dadatiaoao/-1021ccc/README.md

# 野火 F429 七电机小车：当前状态与已确认信息

**2026-11-06 第一阶段更新：**当前开发分支以 `1c464da` 的 main 为基线，将 5/6/7 轴改为串行碰撞回零；地址 1～7 全部就绪后只自动启动一次，顺序为 6 轴顶部接触并到名义约 10 mm 安全观察位、5 轴接触归零并转至 90°、7 轴外伸接触并归中、最后复核整体停放。按 5/6/7 轴顺序，回零寻端速度为 **15/40/150 RPM**，普通动作默认速度为 **20/60/200 RPM**；三轴寻端无进展时间统一为 **1500 ms**。5 轴普通范围 **0～180°**，6 轴普通范围 0～150 mm，PG2/PG3 限位**只显示**。当前源码、软件验证与尚未进行的新流程实机验收见[第一阶段说明](Doc/MECHANISM_COLLISION_STAGE1_2026-11-06.md)。下方早期回零参数与测试数字保留为历史记录，不适用于这次三轴集成。

更新日期：2026-11-04。当前开发主线为 `main`，文档核对基线为 `f14be37`，后续光流停用改动见 4.4 节。原 `codex/chassis-motor-odometry` 的开发成果已快进合入 `main`；旧光流主线 `01c8a68` 保存在 `archive/main-before-odometry`。当前使用电机累计位置估算平移，陀螺保持航向并控制旋转；光流源码保留但退出编译，应用不再初始化、采样或显示光流数据。当前底盘行为见[电机里程计说明](Doc/CHASSIS_MOTOR_ODOMETRY_2026-10-24.md)，文档维护状态见[文档索引](Doc/README.md)。

**2026-10-27 选择性合入 PR #2：仅加入双舵机正式驱动和比赛纯调度框架。未合入 K230 通信、依赖视觉的运行适配器、重复 DUAL 工程、独立舵机测试界面或角度换算。该提交现已成为 `main` 的代码基线。**

- 上电先保持两路 PWM 关闭，等七机就绪后串行完成 **6→5→7→最终停放复核**；任何轴不能跳过。必须三轴均回零成功且机构、底盘和总线空闲，才依次启用两路初始 PWM：夹爪 **PA6/TIM3_CH1=1700 μs**、转盘 **PC8/TIM3_CH3=1240 μs**。无舵机位置反馈，输出不等于到位。
- 回零失败或全局 STOP 取消本次自动启用；STOP 同时关掉两路 PWM，夹爪可能失去保持力。之后不会自动重启舵机；初始化成功、回零等待已结束且机构/底盘/总线空闲、无待确认停车时，可通过明确的 ON 按钮恢复。手动 ON 不检查三轴 HOMED，不能当成回零成功证明；重新启用恢复该路初始脉宽。单路 OFF 同样取消待执行的自动启用。
- **首页 → MORE → SERVOS**：夹爪1700/2430 μs、转盘1240/1900/2600 μs，分别ON/OFF。回零等待、机构/底盘忙或待确认停车时拒绝 ON 和目标调整，OFF 仍可执行。两路实际配置的 `slew_us_per_s=0`，目标在 `Servo_Process` 中直接更新 PWM，不代表机械瞬时到位；没有舵机到位反馈或完整抓放动作计时。
- **首页 → MORE → RACE FRAMEWORK**：仅展示框架，标注 `NO EXECUTOR`。两批顺序、三槽推定状态和一次启动逻辑已保留；完整流程外部抓取/对外放置各12次，车载槽内部抓放不计。没有注册执行器、没有K230 READY/START，START始终拒绝；不是可运行的比赛固件。详见 [比赛框架边界](User/mission/README.md)。
- 当前仍使用 UART5 TTL 电机总线与 USART1 调试；未接入雷达或 K230 协议。
- 2026-10-27 历史软件验证记录：Keil 全量编译 0 错误/0 警告；主回归、舵机启动门控及 25920 组比赛顺序测试通过。当次记录为未烧录，本次文档审阅未重新构建或运行测试。

**2026-11-04 用户补充确认：已完成当前屏幕八段底盘验收和机构回零测试。** 这是功能实测记录，不包含 K230 启动、自主两批搬运、码垛及返回。测试实际日期、固件提交号/HEX、各轴覆盖与重复次数、行程/角度误差及停车时间未提供；不将其扩大为整车比赛或精度验收，舵机动作顺序和机械干涉仍待专项确认。

**机构参数及其假设以 [mechanism_config.h](User/mechanism/mechanism_config.h) 的配置与注释为准；本文及相关说明同步引用该入口。**

**本文是本工程当前状态、需求和交接的统一入口。此前已归档的计划书、阶段任务书、交付书及前期方案均已过时，仅供历史参考；旧文档与本文冲突时先核对当前源码，不再直接执行其中的旧交接指令。软件行为以源码为准；实物结论以注明范围的用户确认或测量记录为准。** 历史测试仍可作为对应版本的证据，不能据此推定当前实物已全部验收。若后续源码与本文发生差异，应核查并更新本文，不用旧文档覆盖新代码。

用户此前试跑出现 FLOW INVALID、ACTION TIMEOUT 和直行横移，曾发现光流红光遮挡，并反馈手推轴向与车体约定不一致。2026-10-24 用户确认光流模块故障，要求新开分支移除其控制反馈；该实现现已进入 main。当前 main 不再使用光流尺度、方向、质量或时间配对，也不再由光流异常触发底盘停车。保留已有机械参数和两个确认标志为 1；底盘参数本轮未重新测量；机构默认启用 TRIAL 试运行，实测范围见下文，比赛纯调度框架已加入，真实导航与抓放执行器未接入。

**2026-10-26 机构历史记录：当时默认 TRIAL=1，上电先 6→5，再按配置及健康反馈条件决定是否回零 7 轴；仅在线不足以保证参加回零。5/6 快慢速为 24/6、60/12 RPM，5 首次搜索 360°。7 号单头 1 mm 螺距丝杆、电机直联、总行程 50 mm，正向伸出；当时改为驱动器原生碰撞回零后缩回到距伸出端 25 mm 的中点，软件范围 ±25 mm。7 轴回零功能用户实测完成；无进展判定仅用于回零寻端，到端确认停车后自动归中，已移除临时电流采样与显示。当前参数、实现状态与待验项目以[机构标定记录](Doc/MECHANISM_CALIBRATION_TODO_2026-10-25.md)和配置头文件为准；旧机构计划、交付、试运行文档仅作历史记录。**

6 号六次整段计数平均 264855，粗测行程约 165 mm；2026-10-26 用户实机确认同步轮为 20 齿、同步带齿距为 2 mm，每电机圈位移为 40 mm，旧指令范围 0..160 mm；新碰撞点坐标的普通指令上限暂设 150 mm，真实底部余量待验证。临时采数已删除。同日用户已实机确认全部 1～7 号电机均为 **3200 指令脉冲/电机圈**，不能与每圈 65536 反馈计数混用。

## 1. 当前结论与实物进度

| 项目 | 当前已知状态 | 证据与范围 |
|---|---|---|
| 工程平台 | 野火 STM32F429 挑战者 V1 核心板，不使用野火底板；7 台电机 | 用户确认；H743＋8 电机是独立方案，不属于本工程 |
| 扫码 | **已实测成功，运行正常，可稳定扫码** | 用户于 2026-10-22 确认；USART3 9600/8N1、手动电平触发、PB12 低有效、15 字符任务码及换行结束符均匹配 |
| 单电机 | **已实测成功，运行正常** | 用户于 2026-10-22 确认；未提供测试固件提交、完整动作清单及异常注入记录，不扩展为七机或所有故障策略通过 |
| 多电机 | **已同时连接两台，并先后请求 move 完成测试** | 用户于 2026-10-22 补充；这是双节点连接、顺序动作验证，不代表两轴同步运动、四轮聚合或七机并发通过；测试地址、脉冲量和精度未记录 |
| 七电机 | 总线、控制、反馈、启动流程和故障处理已实现并有历史主机回归 | 已补充底盘八段和机构回零功能测试；七机并发、总线异常及停车重试未获专项验收确认，逐台配置仍需核对 |
| 光流 PMW3901 | 用户于 2026-10-24 报告故障，已退出当前 main 底盘控制 | 驱动源码归档保留、不参与编译；首页替换为鼠标位移模块占位卡片，无内页 |
| 陀螺仪 | **已完成实测**，继续使用当前模块 | 继续使用现有模块；2026-11-05 改为按 CAL 现场采样更新零偏，新流程待上板验证；漂移、角度误差和安装映射仍需量化 |
| LCD/触摸 | 4.3 寸 RGB 电容触摸屏；原画板曾运行且可触控 | 旧显示/触控有实测；2026-10-24 改为 180° 整屏倒置及总览首页，主机渲染/触摸/调度回归通过，实屏四角与比赛字高仍待验 |
| K230 视觉上位机 | **外部视觉模块的历史确认：基础模型训练完成**，可输出识别图像坐标；本仓库没有 K230 侧程序 | 用户确认；接 F429 的 USART1（PA9/PA10），通信协议尚未实现；未声明毫米坐标、抓放闭环或场景识别率已通过 |
| 比赛启动与分工 | **每次上电自动机构回零，再等待 K230 板上按钮触发 START；STM32 管任务与动作，K230 管视觉及启动** | 用户于 2026-10-23 确认的待实现需求；K230 的 READY 携带抽签启停区 1/2 与初始朝向，确认 STM32 READY 后才允许发 START；STM32 仍复核并回报拒绝原因。当前 6→5→7 串行碰撞回零软件已实现，待新集成实机复核，用户已确认完成机构回零测试；完整标定和接线追溯待补；K230 协议和比赛任务入口尚未实现 |
| 视觉任务交互 | **STM32 在需要 K230 时发送当前阶段和要执行的任务代码** | 首版不考虑比赛中 K230 断连或重启，不安排重连续跑；消息编码、字段及坐标约定待实现 |
| 抓放推进与异常范围 | **抓住、入槽、释放不做结果反馈，动作程序正常执行结束即按成功推进** | 首版不考虑抓取失败或空载对心超时处理；槽位/计数属于流程推定，不能证明实际持物或落点。既有电机反馈和停车策略保留 |
| 载物位 | **计划三个独立载物位，一趟带三个** | 用户明确设计方案；不代表机械制成或装载检测已验收 |
| 放置定位方案 | **随臂摄像头，视轴与夹爪轮廓圆心对齐；先空载对心，再回车取料、返回放置** | 用户确认方案；夹爪闭合轮廓为与物料抓取边缘同大小的圆。视觉同时定位夹爪圆与目标同心圆，底盘/机构微调；收敛后底盘不动，5 号轴回车取料再返回，6/7 号轴恢复定位姿态后垂直放下。目标在时间预算内完成，首版不处理对心超时；尚未实现/验收该闭环 |
| 舵机 | PA6夹爪、PC8转盘，两路50 Hz PWM已接入 | 三轴回零后输出初始脉宽；无位置反馈；舵机启用顺序与机械干涉未获专项实测确认 |
| 四轮底盘 | 车体速度、电机累计位置估算平移＋gyro 保向/旋转、屏幕单次前进/后退 30 cm | 用户于 2026-11-04 确认旧八段功能测试，2026-11-05 确认当前前进/后退按钮实测方向正确；直行后旋转问题仍待定位，距离误差/重复性未量化 |
| 整车功能 | 外设及底盘软件基础已具备，尚未形成比赛自主运行程序 | 机构碰撞回零及显示用限位软件已实现，新集成待实机验收，完整标定未完成；比赛纯调度已实现；全局定位/导航及真实抓放执行器未实现 |

**当前屏幕入口：上电打开“运行总览”；底栏固定为“首页 / 底盘 / 机械臂 / 限位 / 停止”。底盘 → MORE → “前进30cm”或“后退30cm”显式启动一次直线移动，参数不全时拒绝；只驱动地址 1～4，5～7 可缺席。全局停止覆盖七轴。** 上电机构回零由配置门控（默认 TRIAL=1；TRIAL=0 内置配置未标定，会拒绝回零），旧逐轮上电测试和电机 MANUAL/RUN 测试菜单已删除；比赛 K230 START 未实现；比赛纯框架已加入但执行器未接入。当前页面、旋转规则和预览见[UI 改版说明](Doc/UI_REDESIGN_2026-10-24.md)。

## 2. 整车组成与地址

电机为 X42S_V2.0 光耦版，采用 Emm 固件、TTL 串口。代码按固定地址 1～7 创建节点，不自动修改电机地址或写入持久化参数；具体固件版本、应答设置及多机电气连接仍待逐台核对。

| 地址 | 角色 | 已确认用途 |
|---|---|---|
| 1 | 前左轮 | 麦克纳姆底盘，主要按速度控制 |
| 2 | 前右轮 | 同上 |
| 3 | 后左轮 | 同上 |
| 4 | 后右轮 | 同上 |
| 5 | 旋转臂 | 同步轮 1:3 减速，120°/电机圈；回零与车侧平行，抓放与车侧垂直（90°） |
| 6 | 上下轴 | 同步带升降、无减速，实物总行程粗测约 165 mm；已实机确认 20 齿 × 2 mm，配置 40 mm/电机圈；顶部回零，向下为正 |
| 7 | 前后微调轴 | 单头 1 mm 螺距直联丝杆，50 mm 总行程，中点为零，正向伸出 |

2026-10-26 用户确认 7 号总行程为 50 mm，并要求碰撞回零与中点定位。5/6 限位仍为 PG2/J7-41、PG3/J7-43：COM 接地、NC 输入上拉，释放低、触发/断路高；**新流程只采样并显示，不用于运动决策**。5 号 1:3 减速，碰撞收拢端为 0°，90° 为工作位；6 号直驱同步带，以顶部碰撞点为 0 mm、向下为正，两轴回零方向已有用户实测确认。详细确认状态见[第一阶段说明](Doc/MECHANISM_COLLISION_STAGE1_2026-11-06.md)。底盘继续保留用户录入轮径 78 mm、前后轮距 216 mm、左右轮距 218.6 mm、传动比 1、方向 `{1,-1,1,-1}`；本轮未重新测量。平移按电机每圈 65536 反馈计数换算。2026-11-05 用户确认当前“前进30cm”“后退30cm”实测方向正确；保留 `{1,-1,1,-1}`。有效地面距离、打滑误差及转向反馈一致性仍需分别验证。

## 3. 工程、工具链与资源

| 项目 | 当前配置 |
|---|---|
| 工程路径 / 目标 | 仓库内 `Project/YH-F429.uvprojx`，Keil 目标 `LCD` |
| MCU | STM32F429IGT6 / 工程 STM32F429IGTx，Cortex-M4F，LQFP176 |
| 存储器 | 片内 Flash 1024 KiB、RAM 256 KiB（含 64 KiB CCM）；核心板另有 SDRAM、SPI Flash |
| 软件框架 | STM32 HAL 1.7.3；Arm Compiler 5.06 update 7 build 960（AC5） |
| 时钟 | HSE 25 MHz；PLLM=25、PLLN=360、PLLP=2、PLLQ=7；HCLK 180 MHz、APB1 45 MHz、APB2 90 MHz |
| 初始化方式 | 现有 main/BSP 的 C/HAL 初始化；本工程没有 .ioc，不需要从零重建 CubeMX |
| 显示 | LTDC＋DMA2D，480×272、ARGB8888；单层 522240 字节，外部 SDRAM 0xD0000000 |
| 触摸选择 | 源码选择 GT1151QM 4.3 寸配置；实物芯片型号没有单独确认记录 |
| 调度 | 协作式主循环，无 RTOS；main 中静态 QrApp，统一推进所有服务 |
| 栈 / DMA | 配置栈 4096 字节；UART DMA 缓冲在 DMA 可访问的片内 SRAM，不在 CCM 或 SDRAM |
| 产物 | `Output/YH-F429.hex`、`.axf`；Output、Listings 被 Git 忽略 |

PLLQ 当前不是精确 48 MHz，工程没有新增 USB 业务。历史 MotorDemo、单机 service 及其协议回归保留，默认 main 不调用 MotorDemo_Process。旧单机 UI 及重复的底盘/机构 UI 格式化器已删除，屏幕统一由 qr_ui.c 管理。

### 3.1 已配置引脚

下表“代码配置”不自动等同实际接线；扫码已由用户确认配置匹配，电机双节点顺序 move、光流和陀螺已有用户实测反馈；具体覆盖按第 1 节区分。

| 功能 | MCU / 接口 | 配置 |
|---|---|---|
| 电机 | UART5：PC12 TX、PD2 RX | 115200/8N1；RX DMA1 Stream0/Channel4，TX Stream7/Channel4 |
| 扫码 | USART3：PB10 TX、PB11 RX | 9600/8N1；RX DMA1 Stream1/Channel4 |
| 扫码 TRIG | PB12，V1 J7-14 | 推挽、低有效；周期 1000 ms，其中低电平 800 ms |
| 夹爪舵机 | PA6 / TIM3_CH1 | 50 Hz；初始/低位 1700 μs，高位 2430 μs |
| 转盘舵机 | PC8 / TIM3_CH3 | 50 Hz；初始 1240 μs，另有 1900/2600 μs 预设 |
| 上位机/调试 | USART1：PA9 TX、PA10 RX | 115200/8N1 为当前初始化；拟接 K230，双方协议尚未实现，printf 与协议复用待处理 |
| 历史光流 SCLK（未启用） | SPI2 PB13，J7-54 | AF5；Mode 3，8 bit，MSB first；APB1/64=703125 Hz |
| 历史光流 MISO（未启用） | SPI2 PC2，J7-16 | MCU 输入，接模块输出 |
| 历史光流 MOSI（未启用） | SPI2 PC3，J7-52 | MCU 输出，接模块输入 |
| 历史光流 CS（未启用） | PE3，J7-49 | 独立 GPIO，低有效 |
| 5 号旋转臂限位 | PG2，J7-41 | 输入上拉；COM 接地、NC 接输入；高有效 |
| 6 号上下臂限位 | PG3，J7-43 | 同上；仅初始化 GPIOG 这两位 |
| 陀螺 SCL | I2C1 PB6，J7-32 | AF4、开漏，100 kHz |
| 陀螺 SDA | I2C1 PB7，J7-31 | AF4、开漏 |
| 触摸 | I2C2 PH4/PH5；PD11 RESET、PD13 INT | 沿用野火 BSP；EXTI 只通知，前台处理触摸 |
| Flash | SPI5 PF7/PF8/PF9、PF6 CS | 保留现有 BSP |
| 显示/显存 | LTDC、FMC/SDRAM、DMA2D | 保留原板资源；完整网络以 V1 原理图及 BSP 为准 |

HAL UART MSP 按 USART1/UART5/USART3 分支；统一回调位于 `User/usart/bsp_uart_callbacks.c`。UART5/USART3 各自 RX DMA 缓冲 256 字节、软件队列 512 槽，UART5 TX 持久缓冲 128 字节。光流 SPI2 初始化转发已移除，当前固件不配置其引脚；陀螺与触摸不共用 I2C 总线。

### 3.2 模块接线边界

- **电机 TTL：**主控 TX → 电机 R/A/H，主控 RX ← 电机 T/B/L，共地。光耦脉冲端和 TTL 通信端是不同接口。七台的实际参数、并联接法和电平尚未整体验证。
- **扫码：**用户已确认上述接口/模式/格式可稳定工作。裸 XM1605 资料的 12Pin 为 2=VCC、3/8=GND、4=RX、5=TX、12=TRIG；不能套用成任何转接板的排针顺序。当前固定波形用于手动电平触发；连续模式下 TRIG 的暂停/继续语义不同。实物电源/转接电路细节尚无完整记录。
- **历史光流接线（驱动未编译）：**方案使用 3.3 V 供电/逻辑，共地；模块 VCC 直接关联 VDDIO，不能因有稳压器就按 5 V 接入。资料的 MIS/MOS 丝印与信号方向有歧义：必须按芯片 MOSI 输入接 PC3、MISO 输出接 PC2，不能只看缩写。RESET 不接 MCU、依赖模块上拉及软件复位；MOTION、VREG 不接，VREG 不是外部供电口。早期有安装与模块实测记录，2026-10-24 后续反馈为模块故障；尚无恢复正常确认。实际排针版本/信号核验记录和毫米标定另待补齐，且不再作为当前底盘启动条件。
- **陀螺：**型号 WDS601M-ICM-42688，资料目标芯片 ICM-42688-P，MODULE。用户确认引脚为 **VCC、GND、SCL、SDA、SA0、CS、INT1、INT2**。当前实现走芯片直连 I2C：VCC=3.3 V，CS 拉高，SA0 拉低选 0x68，INT1/INT2 不接 MCU。PS/模式焊点按模块资料保持开路，SCL/SDA 外部上拉到 3.3 V；用户已完成实测，但具体模式焊点、上拉、电平和固定安装方向没有逐项记录。若 SA0 确认固定高，需明确改为 0x69，代码不自动猜地址。未使用板载 MCU 的串口/解算接口。

核心板供电与屏幕排线的历史事实：原画板曾由 DAP LINK 下载并正常显示/触控；屏幕产品资料为 4.3 寸、480×272、5 点触摸、RGB888，要求 5 V 与 3.3 V。原图仅作规格记录，标称刷新指标不是当前应用性能：

显示屏参数原图

## 4. 当前程序架构与运行效果

`main → QrApp_Init / QrApp_Process` 统一编排以下模块，后台服务不因切页停止：

| 模块 | 当前职责 | 主要位置 |
|---|---|---|
| 应用 | 底盘调度、触摸意图分发、控制权仲裁、校准门控 | `User/app/qr_app.c` |
| 机构 | 显示用限位采样、有界碰撞回零、角度/毫米 API、中点回零与屏幕验收 | `User/mechanism/` |
| 底盘 | 配置校验、X 型麦轮逆解、电机位置里程计、非阻塞单次平移/旋转 | `User/chassis/` |
| 电机 | Emm 构帧/解析、七节点独立状态、唯一 UART5 调度、控制/停止/反馈 | `User/motor/emm_protocol.*`、`motor_bus.*` |
| 扫码 | UART 字节接入、文本组帧、任务码解析、会话锁定/重扫 | `User/qr/`、`User/usart/bsp_qr_*.c` |
| 光流（归档、不编译） | 保留 SPI2/PMW3901/服务/旧 UI 源码，应用无引用 | `User/flow/` |
| 陀螺 | I2C1 适配、ICM42688 初始化、单轴速率、CAL/ZERO/积分/恢复 | `User/gyro/` |
| 界面 | 总览首页、模块详情/MORE、固定底栏、180° 显示与触摸、分步绘图 | `User/app/qr_ui.*`、`User/lcd/lcd_orientation.h`、gyro UI |
| 舵机 | TIM3 双路 PWM、预设脉宽、上电门控和 OFF | `User/servo/` |
| 比赛框架 | 两批步骤、三槽推定状态、同色映射、一次启动和错误处理；执行端为空 | `User/mission/` |
| 底层 | 时钟、LCD/SDRAM/触摸、UART/DMA、SPI/I2C | `User/main.c`、各 BSP；HAL 保持原版本 |

电机累计位置与 gyro 接入短程底盘动作，光流驱动不参与编译；扫码结果仍只采集与显示，不触发比赛动作，未实现全局导航。新增业务通过现有 MotorBus API 发送，不另建 UART5 发送者。

### 4.1 上电与屏幕操作

1. 初始化通信、扫码、gyro 和显示用限位后，进入“运行总览”。首页展示准备/机构回零/底盘验收/运动/停车/故障等真实软件阶段、当前轴或验收段号及任务码。默认 TRIAL=1 等待七机反馈齐全、静止且无故障/未确认停车后，只自动尝试一次 6→5→7 串行碰撞回零及完整停放；TRIAL=0 的内置配置仍未标定，会拒绝回零。限位去抖状态不参与开始条件。
2. 首页六个白色模块卡片分别为电机、陀螺仪、扫码、鼠标位移模块、视觉、机械臂。鼠标位移模块显示 NOT LINKED，点击留在首页，暂不设计内页；其余卡片点击进入模块；右上角 MORE/LESS 统一切换诊断。视觉页明确显示 K230 协议尚未实现。
3. 底栏在所有页面固定为“首页 / 底盘 / 机械臂 / 限位 / 停止”。底盘显示后台轮端里程计当前连续坐标段的 X/Y/YAW，断链重建用 SEG 区分；无效或过期显示 --。该估计不等于实际地面位置，也不等于每段动作的相对目标坐标。
4. 机械臂概览显示 5 号角度、6/7 号毫米位置和 HOMED/NO ZERO。MORE 内可切换轴并执行重新回零/机构验收。限位页独立显示 PG2/PG3 原始电平和消抖状态，高电平写“按下 / 断路”，7 号明确无开关。
5. 电机页只读：七轴状态、速度、单轴位置、错误/停止信息和上一轴/下一轴；已删除 MANUAL、使能/速度/脉冲 RUN、0xAA/SYNC 测试模板及隐藏标题跳转。底层 MotorBus 的运动 API 和停车策略保留。
6. 底盘 → MORE 提供“前进30cm”“后退30cm”。每次按下分别以动作开始时的车体局部 X 轴为基准，前进目标为 +300 mm、后退目标为 −300 mm；两按钮的实测前后方向已由用户于 2026-11-05 确认，自动准备四轮、使用轮端里程计和 gyro 保向，到位后确认停车并复查误差。一次点击只移动一次，不自动往返；准备/运动/停车确认期间再次点击拒绝，长按不重复。正常陀螺模式需先静止 CAL，配置和反馈有效（启动失败降级模式见末节）；停止或故障会取消尚未执行的移动。八段路线、段号、段间等待及专用接口已彻底删除。机构与底盘继续互斥，CAL/ZERO 都在机构或底盘持有控制权时拒绝；CAL 另查七轴活动/UNKNOWN/未确认 STOP，ZERO 未执行这层电机状态检查；光流采样及清零入口已移除。
7. 所有按钮为白底黑字白色矩形，按住不重复。切页只改变显示，后台采样、回零/验收继续推进；“停止”取消机构/底盘动作和运行中的比赛框架，向七轴发 STOP 并等待反馈确认，同时关闭两路舵机 PWM、取消其上电自动启用。

**比赛目标流程（需求；自动回零与纯调度已实现，通信及真实执行尚未接入）：**

- K230 发送配置就绪消息，包含抽签启停区 1/2 和初始朝向；STM32 完成自动回零、配置接收及必要准备后报告执行就绪。文档分别称为 `K230_READY` 和 `STM32_READY`，仅用于区分方向，实际协议编码待定。
- K230 先确认 STM32 的 READY，再允许板上按钮发送 START；STM32 收到后再次核查，未就绪则拒绝并回报原因。初始朝向的单位/参考方向仍需约定。
- STM32 管整场步骤，在需要视觉时发送阶段和任务代码；K230 返回对应任务的识别结果。首版不做比赛中 K230 断连/重启恢复。
- 抓住、放入载物位及释放不增加物料结果反馈，动作序列正常结束后更新逻辑槽位与计数；不把电机命令刚入队当作整个动作结束。规划首版不做抓取失败检测/重试或专用空载对心超时恢复。现有纯调度框架仍有扫码 15 s、其余每个动作 90 s 的通用超时；超时进入 FAULT 并调用停止接口，接入对心执行器前须协调这一实现与需求。超时不等于已对心成功。
- 空载对心成功后底盘保持不动，回车取料再返回记录姿态并垂直放置。原有电机反馈、停车确认/重试与故障门控继续保留；上述简化不改变当前底层代码。

| 配置 | 默认值与实际含义 |
|---|---|
| CHASSIS_MECHANICAL_CONFIRMED / CHASSIS_FEEDBACK_CONFIRMED | 当前均为 1，沿用用户调参配置；前者确认机械/方向，后者确认电机位置换算与 gyro；不再确认光流参数。源码有效配置不等于实机精度验收通过 |
| MOTOR_SYNC_CLEAN_BOOT_CONFIRMED | 0；同步缓存默认锁定，无已实测的运行期解锁方案 |
| MOTOR_DRIVER_REQUIRE_MANUAL | 0；驱动 API 不强制 UI 会话，程序化调用方负责明确动作意图；屏幕无原始电机运动入口 |
| MOTOR_UNKNOWN_AUTO_RECOVER_MS | 500；只有无未确认停止意图、获得新的零速/无故障反馈并满足稳定窗，才允许 UNKNOWN 自愈 |

除 CHASSIS_* 外，表中总线策略宏集中在 `User/motor/motor_test_config.h`（历史文件名保留）。旧 UI 测试模板及其无用宏已删除；公共 API 仍检查反馈、动作参数、目标/脉冲关系及同步锁。

### 4.2 电机通信与停止语义

已支持单轴使能、限时速度、三种位置脉冲模式（相对上一输入目标、相对坐标零点、相对当前实际位置）、四轮 37 字节 0xAA 速度聚合、传统缓存同步及逐轴反馈。不是七台实物已经同步验证。上一次输入目标不明时拒绝对应相对模式；同步缓存失败会锁定，MCU 复位不证明电机缓存已清。

总线只有一个活动请求；最小命令间隔 10 ms、应答期限 60 ms、取消/超时隔离 120 ms。静止时位置/速度/状态目标各约 500 ms；运动时速度和位置目标 200 ms、状态 500 ms，实际频率受控制、重试和离线节点影响，四轮速度发布仍为 100 ms。电机反馈新鲜度阈值保留 1600 ms，各字段独立计时。轮端位移先对齐到共同时间再使用，位置过期、跳变或断轨中止平移动作。

**2026-10-22 已落地的故障修复：**

- UART5 在清 IDLE 前检查 PE/FE/NE/ORE，DMA 回调同样隔离；恢复丢弃受影响的 DMA、软件队列及协议半帧。检查本次 RX/TX DMA 启动状态，覆盖旧 HAL 返回 OK 但底层未启动的情况。恢复失败至少间隔 100 ms；RX 错误不主动截断在途 TX。
- RX 不可用时阻止所有 TX（包括 STOP），停止意图保留，接收恢复后继续；当前没有 TX-only 停止通道。
- STOP 的“待发送”“已提交”“未确认”“已确认”分开。首次提交及两次快速尝试至少间隔 200 ms，此后至少 1000 ms 一次，轮转轴并让出反馈事务；忙/隔离会延后实际发送。
- 重复 STOP 合并，不重置首次期限或证据基准。只有首次 STOP 提交后新取得、仍新鲜的零速和无保护/堵转状态，才确认停止。ACK、DMA 完成、旧零速均不够。
- 3 s 到期可转 UNKNOWN，但保持 STOP UNCONF、运动禁入及重试；界面概览 STOP?、详情 STOP UNCONF。收到足够停车证据后停止重发。位置/速度动作本身不自动重放。
- STOP 不自动 Disable，尤其地址 6 不用失能替代升降停车。实物保持力矩与机械制动效果尚未验收。

协议线上没有事务序号，超过隔离期的同地址同码迟到响应仍有归属限制。链路断开、MCU 停机或重启时，软件不能保证机械停住；重启也不保留 RAM 中的未决意图。现有单机及双节点顺序 move 实测不覆盖这些故障情形。

### 4.3 扫码

接受固定 15 字符 `ddd+ddd+ddd+ddd`，按 CR/LF/CRLF 组帧。两批颜色各取 1～6 且不重复、集合相同；每批位置为 1～3 的排列；不从噪声里截取合法片段。用户已确认实物设置匹配且可稳定扫码。

每会话只发布并锁定一个合法任务；重复/其它码不替换。RESCAN 清当前结果、本机旧缓冲并增加会话，保留累计统计/历史；重扫等待结束符或 250 ms 无数据间隙重新同步，边界处可能丢弃首条记录。10 秒 WAIT TIMEOUT 后仍接收，静默不判离线。UART/溢出/半帧超时丢弃受损记录，不覆盖已锁定结果。

PB12 周期触发在锁定后仍继续；只更新 DUP/IGN 等统计。扫码、RESCAN、切页及故障恢复均不触发电机动作。纯文本接口不能完全识别模组内部滞留后才输出的旧码。

### 4.4 光流停用与鼠标位移模块占位

2026-11-04：移除 QrApp 的光流状态、初始化、周期采样、快照和累计清零，删除首页光流状态及 FLOW/MORE 内页。首页原位置改为“鼠标位移模块 / NOT LINKED”，点击不跳转；尚未实现鼠标协议、采样或位移接入。

`User/flow/` 下 SPI2、PMW3901、服务、旧 UI 及许可文件完整保留，但从 `Project/YH-F429.uvprojx` 编译列表移除。公共 `HAL_SPI_MspInit` 仅保留 SPI5 Flash，不再转发光流 SPI2。默认 `Scripts/test.ps1` 也不编译光流源文件或调用光流独立测试；历史驱动回归仍可手动运行 `Scripts/test_flow.ps1`，不属于当前应用验收。

底盘继续使用电机累计位置＋gyro；此次未增加新的位移传感器或改变控制参数。旧光流采样、标定及故障记录见已标注过时的 [光流历史文档](Doc/OPTICAL_FLOW.md)。

### 4.5 陀螺仪

仅输出选定旋转轴的 **角速度（deg/s）＋相对转角（deg）**。默认 Z+、地址 0x68、±500 °/s、100 Hz、65.5 LSB/(°/s)，这些是源码默认，非实物安装结论。使用条件为所选轴近似竖直、车体近似平面运动；相对积分会漂移，不是绝对航向或任意姿态欧拉 yaw。

驱动核验 WHO_AM_I=0x47；轮询 DRDY，只有新样本参与积分。未启用加速度业务、温度、FIFO、磁场参考或姿态融合；时间戳来自 MCU 毫秒时钟，漏样无法追回。

- **按键采样校准（2026-11-05）：**已删除固定 15.86°/s 补偿。上电显示 UNCAL / CAL REQUIRED，只提供 RAW，RATE/REL 为 `--`；等机构回零和所有运动结束，将整车保持静止，进入首页“陀螺仪”页点“校准”（CAL）。程序收集至少 201 个连续新样本且采样窗口满 2 s，成功显示 CAL:OK / READY，按本次所选轴均值更新 RAM 中的 BIAS，并将相对角归零。按住不重复；再次点击会重新测量并替换偏置。
- **零偏范围与质量检查：**为容纳现有模块约 15.86°/s 的静止读数，X/Y/Z 三轴均使用单样本绝对值 ≤25°/s、均值绝对值 ≤25°/s。三轴窗口极差 ≤1°/s、方差 ≤0.04 (°/s)²、3 s 超时及原采样连续性门限保持不变。这些是待实板验证的软件接纳上限，不是固定补偿值或传感器精度指标。窗口失败不覆盖旧偏置，并中断角度连续性；首次失败仍未校准。偏置不存 Flash，不后台自适应。
- CAL 使用当前时间的新鲜度：运动为 MOTOR ACTIVE，相关反馈不足为 MOTOR UNKNOWN，未确认停车为 STOP UNCONF。轴范围默认 0x7F；从未发现且从未命令的节点可缺省，任何轴未确认 STOP 都不能绕过。旧上电测试已删除；显式底盘准备/运动/未确认 STOP 仍阻断校准。
- ZERO 在已校准且最新样本可用、未进行 CAL 时建立新角段，保留偏置。每次上电或传感器重新初始化后必须先 CAL，ZERO 不能替代零偏校准。ZERO 只重置角段，不验证偏置，也不消除持续漂移。应用仅检查机构/底盘是否占用；`Gyro_ZeroAngle` 本身不接收电机活动或 STOP 状态，因此不能宣称 ZERO 与 CAL 具有相同的停车门控。
- 轮询空档达到 10 ms、样本 dt 大于 14 ms/为零、过期 30 ms、非法码/饱和或总线故障会中断连续性，显示 REL -- / GAP。保留旧数值供快照诊断，但不当作有效角或跨空档积分。速率恢复后可 ZERO，或重新 CAL。
- 配置巡检不更新采样 `last_poll`，避免占用下一次 DRDY 轮询额度；2026-11-04 修复切页相位下 15 ms 间隔触发 GAP 的问题。普通页第六行在异常时显示 ERR/BUS，ZERO/CAL 被机构或底盘占用拒绝时直接提示；MORE 的 LBUS 保留最近一次非 OK 的总线错误，正常通信后仍可追溯。详见 [UI 修复记录](Doc/UI_REDESIGN_2026-10-24.md)。
- 总线故障按 250 ms 至 4 s 退避；持续 500 ms 无有效样本会重初始化。电机零速与低方差不能证明没有外力推动或恒定慢转，CAL 仍要求操作者保证静止。

### 4.6 界面与主循环

全部页面共用可取消绘图状态机：一次至多绘制一个 480×4 矩形条带或两个字形后返回主循环。至少间隔 100 ms 请求新快照，冻结整组控件文本，切页立即取消旧绘图作业。仅重绘变化的控件；校准/清零依靠状态更新，不强制整页清除。

LCD 基础绘图按 180° 映射像素、线、矩形、字体及位图；触摸在 QrUi_Touch 只转换一次为 `(479-x,271-y)`。配置统一在 `User/lcd/lcd_orientation.h`。中文标签使用片内 20×20 精简字模，不依赖外部 SPI Flash 字库；英文遥测沿用 Font16，任务码使用 Font24。当前字高不代表已满足比赛 12 mm 实测要求。

这是已实现的调度策略，不是实板耗时保证。单个 LCD/HAL 操作真正超预算时仍应显示 GAP，没有调宽陀螺 10/14/30 ms 阈值来掩盖丢样。诊断包括 UI 最大单步耗时及 gyro 最大轮询/样本间隔。

## 5. 已有软件验证与实物边界

2026-11-05 底盘直线按钮改动（基于 `55a6192`）：已删除八段代码，`Scripts/test.ps1` 全量回归通过，Keil Rebuild 为 0 错误、0 警告。独立车体模型验证前进/后退各 300 mm、完成后无自动续行、准备中停止/传感器重置取消；应用测试验证两个按钮、忙时拒绝与长按去重。连续往返的特定模拟采样相位触发停车后 `FINAL ERROR`，已保留回归覆盖；未放宽到位和停车复查门限，不能据此保证任意实车工况成功。该次交付时未烧录；2026-11-05 用户后续确认新按钮实测前进/后退方向正确。30 cm 为命令距离，实际距离误差及直行稳定性未确认，直行一段后开始旋转的问题仍待定位。[本次日志](Output/straight-move-20261105/full-tests.log)、[构建日志](Output/straight-move-20261105/keil-build.log)、[HEX](Output/straight-move-20261105/YH-F429.hex)、[界面预览](Output/straight-move-20261105/chassis-buttons.png) 保存在本地忽略目录。

2026-11-05 后续调整：根据实板 `CAL:MOVING 1/201` 反馈及用户要求，三轴单样本/均值绝对值上限统一为 25°/s。全量主机回归通过；三种轴映射各 62385 项检查，新增三轴正负 25°/s 边界及三轴同时存在大零偏的按键校准覆盖。Keil Rebuild 为 0 错误、0 警告；[新版 HEX](Output/calibration-all-axes-25/YH-F429.hex)、[测试日志](Output/calibration-all-axes-25/full-tests.log)、[构建日志](Output/calibration-all-axes-25/keil-build.log)。尚未烧录，新阈值待实板验证。以下为此前单轴放宽版本的验证记录。

2026-11-05 按键零偏校准：基于最新 `main / f75e0ca`，`Scripts/test.ps1` 全量主机回归通过。新增约 15.86°/s 带噪声偏置、负偏置/重复校准、扣偏后积分、越界/波动拒绝及真实按键长按去重测试；三种轴映射各 53469 项、两个 I2C 地址各 140119 项检查通过。Keil LCD / AC5 Rebuild 为 0 错误、0 警告；[主机日志](Output/calibration-20261105/full-tests.log)、[构建日志](Output/calibration-20261105/keil-build.log)、[对应 HEX](Output/calibration-20261105/YH-F429.hex) 留在本地忽略目录。未烧录；新校准流程的实物成功率、静止漂移和温漂仍待验证。

UI 改版时的历史验证与 Keil 资源见[UI 改版说明](Doc/UI_REDESIGN_2026-10-24.md)：全量主机回归通过，18 个页面变体完成渲染/边界检查；LCD/AC5 全量构建 0 错误、0 警告。Code/RO/RW/ZI=87356/30636/1688/22376 字节，静态 app=13456 字节，静态分析最大栈 1752 字节加未知项，配置栈仍为 4096 字节。当次未烧录或实屏验收；新增用户功能确认见本文顶部。底盘基线验证见[分支说明](Doc/CHASSIS_MOTOR_ODOMETRY_2026-10-24.md)，升降换算及采数清理历史见[机构试运行说明](Doc/MECHANISM_TRIAL_2026-10-24.md)；机构历史交付见[机构交付说明](Doc/MECHANISM_IMPLEMENTATION_2026-10-24.md)。下表保留原光流版本的历史验证，不能当作当前 main 实机验收。

2026-10-24 机构交付历史（`49be15a`，非当前配置）：全量主机回归通过；机构默认/严格 MotorBus 两组各 6319 项通过。Keil LCD / AC5 全量构建 0 错误、0 警告；Code/RO/RW/ZI=86024/19196/1708/18716 字节，静态 app=9792 字节，栈仍为 4096 字节。未知机械参数继续保持无效，未烧录或完成实机验收。

| 记录 | 已核对结果 |
|---|---|
| 历史光流版本主机测试 | `Output/flow-fix-full-tests.log`：默认/配置/固定补偿应用、默认/严格总线及底盘、UART 故障、光流、三种 gyro 轴映射及两个 I2C 地址全部通过；原四轮上电测试已替换 |
| 故障回归 | 包含 STOP 命令丢失/仅 ACK 丢失、持续离线与公平查询、UART 错误+IDLE/DMA 次序、DMA 假成功、CAL 门控、慢 LCD 和真实超预算 GAP |
| 历史光流版本构建 | `Output/build.log`：AC5 LCD，0 错误、0 警告；Code=76372、RO-data=18552、RW-data=1708、ZI-data=15588 字节 |
| 历史资源记录 | app 静态对象 6664 字节（底盘初版 6480，历史 5472）；配置栈仍为 4096 字节；静态最大调用深度 1760 字节（历史 1248），存在函数指针/循环未知项，不是实测栈高水位 |
| 用户实测 | 扫码、单电机正常；新增双节点连接/先后 move、光流与陀螺实测完成；不扩展为同步、七机、标定精度或异常注入验收 |

历史光流版本慢 LCD 回归中的七节点＋扫码 10 Hz＋光流＋触摸＋gyro 场景记录：UI 单步最大 2 ms、gyro 最大轮询/样本间隔 3/14 ms、触摸 STOP 至 transport.send 2 ms、PB12 相位抖动 2 ms。运动中的应用联合场景另完成 21 组四轮速度，gyro 最大轮询/样本间隔 3/12 ms，抢占/清零/STOP 仲裁通过。**这些是指定替身成本模型的结果，不是实板性能、串口线上延时或机械停车时间。** 故意将单个绘图原语设成 12 ms 时，仍检出 GAP。

常用命令（在本工程目录执行）：

```powershell
.\Scripts\test.ps1
.\Scripts\build.ps1 -Rebuild
```

这些脚本面向 Windows：主机测试依赖 Visual Studio MSVC（/W4 /WX），固件构建依赖 Keil UV4/AC5 并检查 0 警告；不能在 macOS 上直接照此运行。Output/Listings 的日志、HEX、map、预览图可被清理，重要验收记录需另行保存；HEX 存在不代表已经烧录。

用户已确认完成屏幕八段和机构回零功能测试；仍待补录固件标识、测试日期、次数及原始测量。专项待验：电机计数与实际轮转方向/圈数、四轮往返及横移/斜行误差、四轮/七机通信压力、停车确认/重试、UART 故障恢复和轴 6 带载保持；当前 gyro 按键采样校准的成功率、重复性及校准后漂移/角度误差；K230 通信和后续比赛任务。光流当前仅保留归档源码，鼠标位移模块待后续设计。

## 6. 未确定、未实现的事项

以下是明确缺口，不是已获确认的参数，也不是自动执行的开发任务书。

| 事项 | 当前边界 |
|---|---|
| 七台配置 | 地址用途已确定；实物固件/应答模式/菜单参数尚未全部核对 |
| 底盘模型 | 用户几何/方向和确认标志沿用；电机位置换算已实现，实际地面尺度、打滑和重复精度需重新量化 |
| 三机构轴 | 默认 TRIAL；全部 1～7 号电机 3200 指令脉冲/圈已实机确认；5/6 方向已确认，6 号 20 齿 × 2 mm＝40 mm/圈已确认；7 号 1 mm/圈、50 mm 行程已确认，用户于 2026-11-04 再次确认完成机构回零测试；具体固件标识、各轴覆盖及归中精度未提供，不能据此确认所有回零分支和异常路径 |
| 舵机 | PA6夹爪、PC8转盘；脉宽预设见 servo_control.c；电源和机械干涉、动作时间仍需实机核对 |
| 光流 | 归档源码保留且退出编译；初始化、采样、数据页已移除，鼠标位移模块仅占位 |
| 陀螺 | 原模块已实测；当前按 CAL 采样更新偏置，上电/重初始化后需重校准；保留 I2C1、0x68、Z+，新流程及精度/温漂/安装映射待实测 |
| K230 | 模型已训练，识别物料、圆环/数字、障碍物并输出图像坐标；USART1 协议、坐标标定、延迟/置信度和 printf 共存方式尚未实现 |
| 载物与确认 | 三独立载物位方案明确；槽位动作序列未接入；两个舵机用于夹爪与转盘。首版已明确不做抓取/入槽/释放结果反馈，按动作序列正常完成推定成功 |
| 两圆对心放置 | 随臂摄像头及取料期间底盘保持不动已确认；相机标定、图像阈值到落点误差、空载/载料返回重复性、抓取圆与物料底面中心关系、遮挡与下降高度待验证；首版不处理空载对心超时 |
| 整车算法 | 电机位置估算＋gyro 短程动作已实现；旧屏幕八段功能测试已获用户确认；当前独立前进/后退 30 cm 的方向已获用户实测确认，距离精度及保向问题仍待验证；机构软件已落地并临时放行，5/6 方向及部分传动信息已确认，完整标定仍待验证；全局定位/导航与比赛执行器未实现；纯调度框架已加入 |
| 实物追溯 | 扫码、单机/双节点顺序 move、光流、陀螺已有反馈；逐项用例、原始测量和误差仍需补录，不据此宣布整车通过 |

## 7. 文档与资料索引

### 当前代码入口

完整的当前说明、历史档案与源码证据对照见[文档索引](Doc/README.md)。

- [主程序](User/main.c)、[应用编排](User/app/qr_app.c)、[界面](User/app/qr_ui.c)、[UI 改版与预览](Doc/UI_REDESIGN_2026-10-24.md)
- [底盘 API](User/chassis/chassis.h)、[底盘配置](User/chassis/chassis_config.h)、[当前底盘说明与验收](Doc/CHASSIS_MOTOR_ODOMETRY_2026-10-24.md)、[历史交付](Doc/CHASSIS_IMPLEMENTATION_2026-10-23.md)
- [电机配置](User/motor/motor_test_config.h)、[电机 API](User/motor/motor_bus.h)
- [机构标定配置](User/mechanism/mechanism_config.h)、[机构 API](User/mechanism/mechanism.h)、[机构历史交付](Doc/MECHANISM_IMPLEMENTATION_2026-10-24.md)、[后续标定待办与记录](Doc/MECHANISM_CALIBRATION_TODO_2026-10-25.md)
- [舵机控制](User/servo/servo_control.c)、[比赛框架边界](User/mission/README.md)
- [扫码配置](User/qr/qr_config.h)、[归档光流配置（未编译）](User/flow/flow_config.h)、[陀螺配置](User/gyro/gyro_config.h)
- [光流第三方许可](User/flow/THIRD_PARTY_NOTICES.md)、[陀螺来源与许可](User/gyro/UPSTREAM.md)：仍有效，不属于过时计划/交付文档。

### 行为规划与历史边界

[智能搬运行为层总计划书](Doc/BEHAVIOR_MASTER_PLAN_2026-10-22.md)：基于本地官方三份 PDF，规划 K230 感知、四轮移动、机构/载物、两批搬运、码垛、计数与验收。已同步代码进度，剩余目标仍属规划；不属于下列停止维护的档案。

[机构阶段计划](Doc/MECHANISM_STAGE_PLAN_2026-10-24.md)、[机构交付](Doc/MECHANISM_IMPLEMENTATION_2026-10-24.md)及[试运行固件记录](Doc/MECHANISM_TRIAL_2026-10-24.md)均已过时，仅保留历史。当前配置与实测范围见[机构标定记录](Doc/MECHANISM_CALIBRATION_TODO_2026-10-25.md)。

### 历史迁移候选方案（未实施，重新采用前需重审）

2026-10-23：用户已购入“TJA1050 CAN模块”，电机端 CAN 通信小板尚未核对。新增 [TTL → CAN 假设性迁移计划](Doc/TTL_CAN_MIGRATION_PLAN_2026-10-23.md)，包含引脚冲突、光流 SCK 候选改线、分包适配及验收。**当前工程仍使用 UART5 TTL；未切换总线、未改接线，也未完成 CAN 实测。**

### 已过时，仅供参考的历史文档

下列正文保留当时的目标、接线依据、实施过程和证据，**不是当前项目事实的另一套来源**。其中“尚未实施”“未实测”“未提交”“单独分支”“上电只读”等描述可能只在当时成立；当前结论以本文为准。历史文档内的嵌套交接提示不再直接执行。

| 历史内容 | 文件 |
|---|---|
| 扫码阶段任务 / 交付 | [QR_UART_STAGE_TASK](Doc/QR_UART_STAGE_TASK.md)、[QR_UART](Doc/QR_UART.md) |
| 七电机阶段任务 / 交付 | [MULTI_MOTOR_STAGE_TASK](Doc/MULTI_MOTOR_STAGE_TASK.md)、[MULTI_MOTOR](Doc/MULTI_MOTOR.md) |
| 光流任务 / 开发基线 / 交付 | [OPTICAL_FLOW_STAGE_TASK](Doc/OPTICAL_FLOW_STAGE_TASK.md)、[OPTICAL_FLOW_BASELINE](Doc/OPTICAL_FLOW_BASELINE.md)、[OPTICAL_FLOW](Doc/OPTICAL_FLOW.md) |
| 陀螺任务 / 交付 | [GYRO_STAGE_TASK](Doc/GYRO_STAGE_TASK.md)、[GYRO](Doc/GYRO.md) |
| 审查修改计划 / 修复交付 | [审查计划](Doc/GYRO_MOTOR_REVIEW_FIX_PLAN_2026-10-22.md)、[修复报告](Doc/GYRO_MOTOR_FIX_REPORT_2026-10-22.md) |
| 单机历史演示 | [MOTOR_DEMO](Doc/MOTOR_DEMO.md) |
| 旧底盘计划 / 光流交付与修复 | [阶段计划](Doc/CHASSIS_STAGE_PLAN_2026-10-23.md)、[交付](Doc/CHASSIS_IMPLEMENTATION_2026-10-23.md)、[光流修复](Doc/CHASSIS_FLOW_FIX_2026-10-24.md) |
| 旧电机屏幕 / 原画板例程 | [电机界面](Doc/MOTOR_UI_DISPLAY_2026-10-23.md)、[原例程说明](Doc/readme.txt) |
| 早期整车架构 / 起步 / 兼容性分析 | 原工作区的 `迁移分析/`，未随本仓库提供；不作为当前代码入口 |

### 原始资料历史位置

下列路径来自原 Windows 开发机，不是当前检出目录内的可用路径；本次仅核对仓库源码，未重新核验外部资料、赛事规则或硬件原理图。

| 资料 | 位置 |
|---|---|
| 赛题、评分与解析 | `E:/工创赛/官方文件`（命题.pdf、评分细则.pdf、赛题解析.pdf） |
| 电机官方资料/例程 | `D:/BaiduNetdiskDownload/ZDT_XS系列第二代闭环步进电机资料` |
| PMW3901 | `E:/工创赛/硬件说明/PMW3901光流传感器模块` |
| ICM-42688-P | `E:/工创赛/硬件说明/ICM-42688-P加速度六轴IMU陀螺仪` |
| XM1605 | `E:/工创赛/硬件说明/二维码扫描模组/XM1605扫码模组资料` |
| 舵机 | `E:/工创赛/硬件说明/PWM舵机（PM系列）` |
| 野火 V1 板资料 | `E:/MPU's_study/野火【STM32F429开发板-挑战者】资料` |
| 无极 S2 参考资料 | `E:/MPU's_study/无极S2开发板资料汇总` |

硬件说明目录中的 H743 八电机拓展板 README/设计文档属于用户确认的独立方案，本轮未改写，也不据此改变本工程主控或电机数量。

## 8. 后续维护规则

只有用户明确确认、当前源码落地或实际验证完成的信息才能更新为事实。实物结果注明模块、固件版本（若已知）、验证范围和日期；未知数据保持未定，不把资料默认值、软件初值或模拟测试值写成实测值。

2026-10-27 选择性合入 PR #2 的代码已于 2026-11-04 成为 main 主线；排除项和实际范围见本文顶部，旧 main 已归档。保留既有诊断模块和底盘动作接口；旧上电逐轮测试不恢复。交付时同步维护本文，历史计划/交付文档仅用于追溯。

2026-11-06：底盘 MORE 页在前进/后退按钮下新增“左转90度”“右转90度”，分别单次逆时针/顺时针旋转 90°（俯视，沿用现有正角定义）。准备、运动、停车中拒绝重复命令；STOP 取消待执行转向。四轮诊断压缩为两行，底栏不变。

## 2026-11-06：陀螺启动失败降级与纠偏

上电等待最多 2 s 检测有效陀螺原始样本；一直无可用样本时锁定本次上电为 `ENCODER ONLY / NO GYRO`。已有正常样本但尚未 CAL 时不会降级，仍须静止校准；正常启动后在运行中掉线仍按原逻辑停车。降级后底盘不采用陀螺数据，即使后台驱动重试恢复也不自动切回；重启重新检测。陀螺页保留真实错误，不伪造校准成功。

轮端模式采用四轮累计编码器位置，在共同时间点插值后计算平移和转角，正角为俯视逆时针。左右转按钮分别请求 +90/-90°；保留车体控制限速、稳定窗口、停车确认和最终误差复查。电机闭环保证轮端执行，不能保证轮胎不打滑或整车真实航向；屏幕角度是几何估算，不是陀螺实测。轮端过期、重置、跳变仍中止动作。

`User/chassis/chassis_config.h` 的 `CHASSIS_LEFT_TRAVEL_SCALE`（地址 1/3）与 `CHASSIS_RIGHT_TRAVEL_SCALE`（地址 2/4）默认均为 1.0，定义为实际有效轮周长/标称周长。比例越大，相同目标速度所需 RPM 越低；里程计使用同一比例乘回实际距离，避免只改指令而估算自相矛盾。范围 0.5～1.5；修改后重新编译上电，不允许运动中改参。这不是自动纠偏，也不能补偿随机打滑。

实测时保持地面、载荷和速度一致，记录实际直行距离、偏左/偏右、横向偏移、终点朝向角；分别测前进、后退多次。再据数据估计左右比例；仅一次横移量不足以唯一确定轮径差。转弯精度还受轮距、轴距及麦轮侧滑影响。

软件验证：全量主机回归、四种动作的轮端降级独立模型、恢复不切源、轮反馈丢失停车、未校准门控及比例换算。新降级和转向尚未实板验收。

本次验证日志：[全量主机回归](Output/motion-20261106/final-tests.log)、[轮端降级专项](Output/motion-20261106/encoder-final.log)、[Keil 最终构建](Output/motion-20261106/keil-final.log)。Keil 0 错误、0 警告；[固件 HEX](Output/motion-20261106/YH-F429.hex)、[四按钮预览](Output/motion-20261106/buttons.png)。未烧录，未以模拟结果替代实测。
