dadatiaoao/-1021ccc/Doc/CHASSIS_MOTOR_ODOMETRY_2026-10-24.md

# 四轮底盘：移除光流反馈，使用电机位置里程计

更新：2026-11-04，源码核对基线 main / `f14be37`，并纳入后续光流停用改动。本文继续维护当前底盘行为，保留 2026-10-24 电机里程计初版的验证记录。该方案最初由 `01c8a68` 建立开发分支，现已成为 main；旧光流方案留在 `archive/main-before-odometry`。机构、舵机及比赛纯调度的进展另见[工程 README](../README.md)。

## 当前行为

- `SetBodyVelocity(vx,vy,omega)` 仍以 mm/s、°/s 接收速度，周期刷新与 300 ms 输入有效期保持原语义。驱动内部负责电机闭环，MCU 不增加轮速 PID。
- `MoveRelative(dx,dy,speed)` 改用四台电机累计位置估算平移。沿用协议反馈每电机圈 65536 counts，乘有效轮周长、除减速比，应用各轮方向，再用麦轮正运动学计算车体 X/Y。
- 平移仍保留接近目标减速、限加速度和 gyro 保向；`RotateRelative(angle,rate)` 继续用 gyro 控制有符号相对角。保留现有增益和速度上限，没有顺带提速。
- `Chassis_Process(c,gyro,now)` 不再接收 `FlowSnapshot`。底盘光流尺度、安装偏置、时间配对、有效性门控和 FLOW INVALID 故障链均已移除。
- 光流源码保留但退出编译，初始化、后台采样、FLOW/MORE 诊断和 CLEAR 入口均已删除。首页改为“鼠标位移模块 / NOT LINKED”占位卡片，无内页。GYRO ZERO/CAL 都受机构/底盘控制权门控；CAL 另检查电机活动和未确认停车，ZERO 没有相同的电机状态检查。
- 唯一 MotorBus/UART5、四轮 0xAA 速度包、100 ms 发布、健康检查、STOP 重试和新反馈停车证据保留。运动时位置查询目标由 500 ms 调为 200 ms，与速度查询相同；状态查询仍为 500 ms，实际间隔由既有总线调度决定。
- 2026-11-05：底盘八段路线、段号、段间等待、专用接口及配置已删除。屏幕“底盘 → MORE”改为“前进30cm”“后退30cm”，每次点击分别执行动作开始时车体局部 X 轴的 +300 mm（前进）/−300 mm（后退）目标，准备四轮后复用单次闭环控制，停车确认及新反馈误差复查通过才成功。长按不重复，忙时拒绝，不自动往返。仅驱动 1～4，5～7 可缺席；正常陀螺模式需先静止 CAL；完成或明确取消机构回零并确认停车。上电仍可能尝试机构回零，不能概括为“上电不运动”。

## 位移估算及故障处理

四轮位置是串口依次回读的，不能直接把四个不同时间的位置相加。每轮保留最近 4 个位置样本，以四轮最新样本中最早的时刻为共同时间，只在样本区间内插值，不外推。gyro 保留约 1.75 s 的角度历史，与共同时间配对后，把车体位移旋转到动作起始坐标系。轮询时间戳为 MCU 接收时刻，仍存在通信延迟及匀速插值近似。

保留电机位置 1600 ms、gyro 30 ms 的有效期。位置反馈缺失/过期、序号回退、不可解释的位置跳变、历史不足或 gyro 断轨使平移失败并请求停车；不使用旧命令或目标值填补缺失测量。跳变阈值按 RPM 上限和采样间隔计算，小幅复位若落在物理可行范围内仍不能可靠识别。

当前屏幕底盘概览显示后台 `Chassis.odometry` 的连续坐标段 X/Y/YAW、VALID/SEG，MORE 显示目标/反馈与原因；详见 [UI 说明](UI_REDESIGN_2026-10-24.md)。动作的相对目标坐标与后台坐标段不同。失效时坐标显示 `--`，代码保留断轨原因、轮号和年龄；失败动作不会自动续跑。旧版 `EST X/Y`/`ODOM` 页面文字仅属于初版界面。

**电机转数闭环不能证明车在地面上移动了相应距离。** 打滑、空转、有效轮径和麦轮接触误差仍会影响行程。`SUCCESS` 表示轮端估算与 gyro 达到内部窗口并确认停车，实物终点要用尺和外部角度参考验收。

## 配置与烧录

`User/chassis/chassis_config.h` 沿用用户已提交参数，没有填入模拟尺寸：

| 参数 | 当前值 |
|---|---|
| 有效轮径 | 78 mm |
| 前后轮中心距 / 左右轮中心距 | 216 / 218.6 mm |
| 减速比：电机圈数 / 轮子圈数 | 1 |
| 1～4 电机前进方向 | `{1,-1,1,-1}`；2026-11-05 用户确认前进/后退 30 cm 按钮实测方向正确，保持配置 |
| 机械确认 / 反馈确认 | 1 / 1，沿用用户配置；反馈确认现在指电机位置尺度/方向与 gyro |

光流的 23 mm / 180 counts 不再参与底盘计算，也无需填入另一轴光流尺度。未知机械参数仍应置 0 并拒绝运动，两个确认标志为 1 不等于本分支实物精度已通过。

`Chassis_DefaultConfig` 保留最大平移 100 mm/s、角速度 30°/s、电机上限 60 RPM、平移加速度 200 mm/s²、角加速度 60°/s²。修改后需重新编译并烧录。

2026-10-24 初版记录曾生成 `Output/YH-F429.hex`，当次未烧录；该路径被 Git 忽略，不代表当前检出含有固件。实机精度追溯需核对按协议正向转动一圈对应约 +65536 counts（协议反向为负），当前前后按钮方向已由用户于 2026-11-05 实测确认；旧“车尾作为车头”配置注释已删除，不能据此推定当前方向错误。屏幕八段功能测试是历史记录；距离尺度、保向稳定性及转向反馈一致性仍需独立测量，不以屏幕估计坐标自证精度。

## 2026-10-24 初版软件验证记录（非当前固件重新验证）

以下计数、资源占用、日志和 HEX 校验值仅对应当时版本；2026-11-04 文档核对未重跑测试或构建。

- `Scripts/test.ps1` 全量主机回归通过，MSVC `/W4 /WX`：扫码、手动/固定补偿应用、多电机默认/严格门控、UART 故障、FLOW、GYRO 和底盘。
- 底盘默认/严格两组各 75553 项检查通过。覆盖每圈计数、减速比/方向、轮询相位、共同时间插值、纯旋转位移抵消、时钟回绕、位置跳变/复位/过期、卡轮超时、停车后越界及首次故障锁存。
- 真实 MotorBus 加独立惯性车体模型完成一轮八段：42451 ms，最终回位 -3.8/+2.1 mm、约 0.0°；另验证 +270° 后按新朝向局部平移。这些仅为模拟结果。
- 主动模拟轮子空转而车体不动：程序可能按轮端估算 SUCCESS，实际位移为 0。该用例明确记录没有地面反馈时的能力边界。
- 实际 QrApp/Flow 服务联合替身验证：光流通信失败后可以 START，动作中 FLOW CLEAR 不改变底盘动作，STOP 仍取消。正常 CAL、配置手动参数以及默认固定补偿应用均验证。
- 慢 LCD/多外设替身：UI 最大单步 2 ms；七节点并行 gyro 最大轮询/样本间隔 3/14 ms；运动应用场景 21 组四轮速度，gyro 3/12 ms。不是实板时序测量。
- Keil `LCD` / AC5 全量构建：0 错误、0 警告。Code=75728，RO-data=18512，RW-data=1708，ZI-data=18284 字节；静态 app=9360 字节。栈配置仍为 4096 字节，静态最大调用深度 1752 字节加未知函数指针/循环项，不是实测高水位。
- 日志：`Output/motor-odometry-tests.log`、`Output/build.log`；产物/日志被 Git 忽略。
- 本次 HEX SHA256：`C0C14F5112D0C7D00319DC35E5669172D706CB936487EF96AE5A8B321B55E0B2`。

## 实机记录

2026-11-04 用户确认：已完成当前屏幕八段底盘验收及机构回零测试。测试实际日期、固件提交号/HEX、重复次数和原始测量未提供；该确认只记为功能测试完成，不能写成自主比赛流程或量化精度验收通过。

待补记录：轮端一圈计数、地面/载荷、各段目标与外部实测/估计坐标、gyro 偏差、STOP 停稳耗时及重复测试结果。原光流版本的失败与修复仅作历史追溯。

## 2026-11-06：陀螺启动失败降级与纠偏

上电等待最多 2 s 检测有效陀螺原始样本；一直无可用样本时锁定本次上电为 `ENCODER ONLY / NO GYRO`。已有正常样本但尚未 CAL 时不会降级，仍须静止校准；正常启动后在运行中掉线仍按原逻辑停车。降级后底盘不采用陀螺数据，即使后台驱动重试恢复也不自动切回；重启重新检测。陀螺页保留真实错误，不伪造校准成功。

轮端模式采用四轮累计编码器位置，在共同时间点插值后计算平移和转角，正角为俯视逆时针。左右转按钮分别请求 +90/-90°；保留车体控制限速、稳定窗口、停车确认和最终误差复查。电机闭环保证轮端执行，不能保证轮胎不打滑或整车真实航向；屏幕角度是几何估算，不是陀螺实测。轮端过期、重置、跳变仍中止动作。

`User/chassis/chassis_config.h` 的 `CHASSIS_LEFT_TRAVEL_SCALE`（地址 1/3）与 `CHASSIS_RIGHT_TRAVEL_SCALE`（地址 2/4）默认均为 1.0，定义为实际有效轮周长/标称周长。比例越大，相同目标速度所需 RPM 越低；里程计使用同一比例乘回实际距离，避免只改指令而估算自相矛盾。范围 0.5～1.5；修改后重新编译上电，不允许运动中改参。这不是自动纠偏，也不能补偿随机打滑。

实测时保持地面、载荷和速度一致，记录实际直行距离、偏左/偏右、横向偏移、终点朝向角；分别测前进、后退多次。再据数据估计左右比例；仅一次横移量不足以唯一确定轮径差。转弯精度还受轮距、轴距及麦轮侧滑影响。

软件验证：全量主机回归、四种动作的轮端降级独立模型、恢复不切源、轮反馈丢失停车、未校准门控及比例换算。新降级和转向尚未实板验收。
