dadatiaoao/-1021ccc/Doc/CHASSIS_IMPLEMENTATION_2026-10-23.md

# 四轮底盘软件交付、标定与实机记录

后续进展：2026-10-24 首次试跑失败、时间配对修复及 X/Y 标定状态见 [修复记录](CHASSIS_FLOW_FIX_2026-10-24.md)。本文数值与待测表保留 2026-10-23 初版交付时的版本边界。

日期：2026-10-23。实施基线：`main / a1dac27`；软件提交：`f9ec56f`。此前已有文档和屏幕资料已先提交保留。

**软件已实现；主机测试、联合模拟和 Keil LCD 构建通过。未烧录，未取得本阶段实机测量，未完成地面验收。** 默认机械/反馈确认均为 0，轮径、轴距、轮距、减速比、方向与光流尺度保持未知；当前屏幕 START 应拒绝并显示 CONFIG REQUIRED。

本文件对应 [阶段计划](CHASSIS_STAGE_PLAN_2026-10-23.md)，当前事实以 [README](../README.md) 为入口。总计划的 K230、导航、机构回零、舵机、比赛流程、CAN 与 Flash 参数存储均未实施。

## 1. 已落地的范围

| 文件 | 内容 |
|---|---|
| `User/chassis/chassis_config.h` | 显式无效的机械/反馈默认值、完整运行配置结构与问题位 |
| `chassis_kinematics.*` | X 型麦轮、真实单位、平移向量/角速度限制、统一轮速缩放、对称整数 RPM 量化 |
| `chassis_odometry.*` | 两点 gyro 时间配对、毫米尺度/安装角、旋转中心偏置补偿、连续性/序号检查 |
| `chassis.*` | Prepare、周期速度、MoveRelative、RotateRelative、STOP、一次八段验收 |
| `chassis_ui.*` / `qr_ui.*` | 底盘视图、具体配置缺项、轮速详情、START 边沿、诊断页与全局 STOP |
| `qr_app.*` | 调度及四轮控制权仲裁；移除原 boot 状态机及成员 |
| `motor_bus.*` | 仅增加实际四轮帧提交次数/时刻诊断；协议、租约、轮询与 STOP 证据链不改 |
| 工程、测试脚本 | 注册新源文件，删除旧上电测试宏/用例，以无自动运动、配置拒绝、底盘及并行用例替代 |

始终只有 MotorBus/UART5 一个发送者。Chassis 不调用串口、延时或等待循环，不向旧目标追加队列；所有动作通过主循环推进。现有同步 I2C/SPI 访问及 LCD 原语仍有各自耗时边界，不能称整个固件零阻塞。

## 2. 对外调用和结果

公开类型/API 见 [`chassis.h`](../User/chassis/chassis.h)。调用方绑定现有 MotorBus，配置在初始化时复制；准备/运动期间保持配置不变。修改已标定参数后，应在确认停止的情况下重新初始化/重新编译，而非运行中修改正在使用的配置。

```c
/* QrApp 已负责每轮调用 Process，不要额外创建第二套底盘实例抢同一组轮子。 */
Chassis_Prepare(&app.chassis, now_ms);  /* 显式意图；只提交一次 */
/* 持续运行 QrApp_Process，检查快照，等 READY，不在这里忙等。 */

/* 二选一：速度模式周期刷新，或启动一个有限动作。 */
Chassis_SetBodyVelocity(&app.chassis, 100.0f, 0.0f, 0.0f, now_ms);
/* 速度模式：上层建议每 50 ms 用当前目标再次调用。 */

Chassis_MoveRelative(&app.chassis, 300.0f, 0.0f, 100.0f, now_ms);
/* 或 Chassis_RotateRelative(&app.chassis, 90.0f, 30.0f, now_ms); */
/* 有限动作只启动一次，随后查询 Chassis_GetSnapshot。 */
Chassis_Stop(&app.chassis, now_ms);     /* 随时取消；随后仍需 Process 验证停车 */
```

代码片段是独立调用方式说明，不应把速度调用和有限动作连续提交；前一个动作持有四轮时，后一个运动请求返回 BUSY。

- 坐标：前 +x、左 +y、俯视逆时针正角；速度 mm/s、°/s，距离 mm，角度 °。
- 地址 1/2/3/4 = FL/FR/RL/RR。`gear_ratio` 为电机转数/轮子转数；直接驱动也需实物核对后明确填 1。
- `ACCEPTED` 仅表示意图接受。Prepare 等四轮健康静止，异步使能并等待新的状态反馈；总期限 10 s。不请求 5～7 使能、运动或回零。
- 状态与结果分开：DISARMED/PREPARING/READY/VELOCITY/MOVING/ROTATING/STOPPING/FAULT；结果 NONE/RUNNING/SUCCESS/CANCELLED/FAILED。STOPPING 不等于已停止。
- 速度模式合法刷新覆盖目标；300 ms 无新请求则停止并锁定失败。内部 100 ms 重发不能替上层续命；新包租约不超过原始截止时间，剩余不足 100 ms 不再排包。零向量也进入停车确认。
- MoveRelative 的目标在本段起始车体系内，横纵向一起纠偏并保持开始朝向；RotateRelative 只依赖 gyro，保留有符号累计角，+270° 不转成 -90°，首版范围 ±360°。
- 有限动作不可被速度或另一个动作抢占。直接速度不依赖光流/gyro，不承诺地面测速或保向闭环；四轮新鲜健康反馈仍是必要条件。
- 故障或超时不能靠再次发送速度、重复 START 或 STOP 清掉失败。确认停止后须显式 Prepare；屏幕 START 内部重新 Prepare。未确认停车时持续 STOP，不接受新运动。
- `publish_accepted` 为 MotorBus 接受次数，`submitted_frames/last_submit_ms` 来自实际 transport.send 成功提交，均不是机械执行完成；BUS_REJECTED、最大提交间隔及四轮反馈年龄保留诊断。

## 3. 算法和测量边界

`k=(L+W)/2`，omega 从 °/s 换 rad/s，四轮轮缘速度分别为 `vx-vy-k*w`、`vx+vy+k*w`、`vx+vy-k*w`、`vx-vy+k*w`；再乘 `60*gear/(pi*diameter)` 及每轮符号。任一轮超限时四轮同比缩放。整数 RPM 对称四舍五入，不增加最小转速脉冲。

内部最多每 20 ms 计算一次，使用实际 dt，不补跑积压周期；100 ms 发布最新四轮目标。平移比例 Kp=1.5/s、角度 Kp=2.0/s、角速度阻尼 0.2，平移/角向加速度初值 200 mm/s²、60°/s²，限速 100 mm/s、30°/s。接近目标还受 `sqrt(2*a*remaining)` 制动包络限制。驱动加速度字段 100 是协议参数，不能理解成 mm/s²。全部是待实车验证的控制初值。

里程计只维护当前 gyro 连续段内的局部坐标。动作保存最近成功配对的光流位置和当时 gyro 角度作为起点，不清零共享服务；准备时要求电机静止，起点仍受采样时间分辨率/时延限制。新光流必须与最近两个有效 gyro 时间戳配对，插值求姿态，等待未配对样本而不外推。同一连续段可用累计 counts 差值吸收未逐次消费的样本。

光流安装角作用于 FlowSnapshot 已映射的 X/Y，不能重复应用 `FLOW_SWAP_XY/FLOW_*_SIGN`。相邻采样间用中间朝向变换平移，再减去 `(R_new-R_old)*sensor_offset`。无论样本值是否看起来正常，光流 rejected/gaps/segments/clears/overflow 或 gyro ZERO/CAL/重启/断轨变化都使当前相关动作失败。平移需光流≤100 ms、gyro≤30 ms；旋转仅需 gyro，单独光流失效不阻止旋转。序列段间也检查下一段必需的传感器及连续性。

平移≤10 mm 且朝向误差≤2°，旋转误差≤2°，实测角速度≤3°/s，**新测量连续满足 200 ms**才请求停止。必须等 MotorBus 的新鲜零速/状态确认，再取得停车确认之后的测量重新检查，才给 SUCCESS；停稳后越界报告 FINAL ERROR。动作期限为 `5 s + 3*距离/速度` 或 `5 s + 3*角度/角速度`，上限 60 s。停车 3 s 未确认记失败，仍持续重试，不推进下一段。

300 ms 是软件发起停车的期限，依赖 MCU 继续运行与通信可用；不是机械停稳保证，也不是驱动端硬件看门狗。保持现有 UART 故障与 STOP 未确认语义。

## 4. 屏幕操作

上电 QR → 右下 MOTOR → 点击左上 `CHASSIS [tap] / MOTOR` → 底盘视图。

- 左下 START：完整配置、必需测量及四轮准备通过后只执行一轮。长按/重复 START 不重启运行中的动作。
- 左上标题：BODY/WHEELS 切换。BODY 显示段号、目标/当前位姿、速度、测量/停车状态；WHEELS 显示各轮目标/实测 RPM。无效或过期反馈显示 `--`。配置不全时列出确认标志、几何参数缺项、方向和光流缺项。
- 顶部 FLOW/GYRO：继续查看原诊断页；BACK 逐层返回。切页不取消动作，不停止后台采样。闭环/序列及四轮占用期间拒绝 FLOW CLEAR、GYRO ZERO/CAL；四轮手动使能/运行、四轮组/同步、模式切换不能抢占，显示 CHASSIS BUSY。
- 底部 STOP：先取消底盘意图，再按原全局范围停止七轴。详情 STOP AXIS 选择 1～4 时也停止整组四轮；5～7 单轴 STOP 保持原义。
- 每段实际停车确认后等待 1 s，再从该段实际姿态开始下一段。依次：+300x、-300x、+300y、-300y、(+200,+200)、(-200,-200)、+90°、-90°。结束 DONE，取消 CANCELLED，失败显示具体原因。任何一段失败不继续。

旧 `Doc/MOTOR_UI_DISPLAY_2026-10-23.md` 和其中截图描述的是实施前基线，保留追溯；当前概览标题和底盘视图以本文件/源码为准。

## 5. 人工标定与逐级放行

当前所有实物栏为 **待测**。不要把 `Tests/test_chassis.c` 的尺寸或测试结果抄进正式配置。

### 5.1 先核对机械和通信

1. 核对地址/物理轮位：1 FL、2 FR、3 RL、4 RR；确认 X 型滚子布局。实际非 X 型时先修正安装或明确变更模型，不用随意翻转公式掩盖问题。
2. 架空用现有 MANUAL 单轴 10 RPM、1 s 点动核对每轮方向。让该轮产生车体前进作用的协议正/负 RPM 记为 `motor_sign=+1/-1`。核对电机实际应答、使能、零速、故障标志，尤其验证聚合包地址 1 ACK 与四轮反馈。
3. 实测有效轮径 D、前后轮中心距 L、左右轮中心距 W、传动比。轮径包含实际承载接触效果；不是轮子外壳/滚子单件直径。
4. 填几何和方向，人工确认后才将 `CHASSIS_MECHANICAL_CONFIRMED` 设为 1。这只放行速度 API，不放行距离动作或屏幕自动验收。先架空核对四轮向量、反向和 STOP；已有 MANUAL 四轮模板是架空通信测试，不是未标定地面验收。

| 机械/通信项 | 用户实测与条件 | 当前结论 |
|---|---|---|
| D / L / W（mm） | 待测 / 待测 / 待测 | 配置为 0，无效 |
| 电机转数/轮子转数 | 待核对 | 配置为 0，无效 |
| FL / FR / RL / RR 符号 | 待测 / 待测 / 待测 / 待测 | 配置为 0，无效 |
| X 型滚子/轮位 | 待核对 | 未确认 |
| 0xAA 四轮聚合、STOP 及新反馈确认 | 待架空实测 | 未通过 |
| 5～7 缺席运行 | 待实物核对 | 仅联合模拟通过 |

### 5.2 光流尺度、轴向及偏置

1. 记录安装高度、地面材质/纹理、光学中心相对旋转中心的 offset_x/y（前正、左正）。只有实测光学中心确实在旋转中心，才可把零偏置视为已确认。
2. 保持车体无旋转，人工沿前/后/左/右各移动 500 mm，每个方向至少三次。每次记录映射后的累计 counts 起止值、质量、rejected/gaps/segments/clears；不用跨无效区间累计值计算尺度。
3. 先确认轴交换和符号，再求正的 X/Y mm/count 和安装角。一般关系为 `body_delta = R(mount_angle) * diag(scale_x,scale_y) * mapped_counts_delta`。轴近似对齐时尺度可用已知距离/主轴 counts 绝对值；有交叉轴残差时须拟合/修正安装角，不能仅分别改两个比例。
4. 用已知角度正反旋转检验偏置补偿，记录补偿后的虚假中心位移。不要把原地旋转的传感器圆弧位移当底盘平移。

| 次数/方向 | 已知 dx/dy mm | 起/止 counts X/Y | SQUAL / rejected / gaps / segments | 外部角变化 | 是否可用于标定 |
|---|---|---|---|---|---|
| 前/后/左/右，各 1～3 次 | 待填 | 待填 | 待填 | 待填 | 待判 |

最终 scale_x、scale_y、mount_angle、offset_x、offset_y、安装高度：**全部待实测提供**。

### 5.3 gyro 及闭环放行

保留当前 `GYRO_TEMP_FIXED_BIAS_ENABLED=1` 与固定 15.86°/s，不自动换偏置。`calibrated` 软件位不是实物精度合格证；ZERO 只能建立新角段，不能消掉漂移。

1. 固定安装轴近似竖直，核对 Z+/现有映射与“俯视逆时针为正”；记录预热时间、RAW/RATE、温度条件（如有外部温度计）与载荷。
2. 无外力且静止记录 10/30/60 s 角度漂移；正反各 90° 至少三次，用外部角度参考核对符号、比例和误差。
3. 首版放行目标：静止 30 s 漂移≤3°、单次 90° 误差≤3°，且采样连续、不发生 GAP。未达到则保持反馈确认 0；先检查固定补偿、安装、时序，不扩大有效性门限。
4. 光流/gyro 标定、偏置补偿及方向/STOP 核对都有证据后，才将 `CHASSIS_FEEDBACK_CONFIRMED=1`；重新构建，再做低速短程试验。两确认标志和全部参数均进入实测记录。

| 试验 | 用户实测 | 状态 |
|---|---|---|
| 静止 10 / 30 / 60 s 漂移（°） | 待测 / 待测 / 待测 | 未验收 |
| +90° 三次，gyro/外部参考（°） | 待测 | 未验收 |
| -90° 三次，gyro/外部参考（°） | 待测 | 未验收 |
| 旋转时补偿后的中心虚假位移（mm） | 待测 | 未验收 |

### 5.4 地面连续三轮记录

每轮记录固件提交、HEX 校验值、全部 ChassisConfig、地面、载荷、安装高度、起点标记。用尺/地面标记/外部角度参考验收，不能只看程序自己的剩余误差。各段目标相对本段实际起点；成对运动不保证累计回到整轮原点。

| 轮次/段 | 目标 dx/dy/角度 | 外部实测终点及角度 | 欧氏位置/角度误差 | 停车耗时 | UI 结果/原因 | 判断 |
|---|---|---|---|---|---|---|
| 第 1～3 轮，各第 1～8 段 | 按固定八段表 | 待测 | 待测 | 待测 | 待记录 | **未验收** |

300 mm 及斜行段终点欧氏误差≤20 mm，平移朝向误差≤5°；90° 转角误差≤5°。三轮每项都满足才记通过，失败样本全部保留。另记录旋转中心漂移、整轮回位误差；未约定阈值的指标只记录，不写成合格。

同时在受控条件下记录屏幕 STOP、停止上层速度刷新、屏蔽一个反馈、恢复反馈的实际行为。停止确认前不开始下一段，恢复后不续跑原动作。通信完全中断时按实际停车能力记录，不能以软件测试代替机械停车结果。

## 6. 软件验证证据

运行命令（工程目录）：`Scripts/test.ps1`，单独底盘回归 `Scripts/test_chassis.ps1`，Keil `Scripts/build.ps1 -Rebuild`。

| 项目 | 已取得的软件结果 |
|---|---|
| MSVC | /W4 /WX；完整原有协议、UART、扫码、UI、Flow、gyro 轴映射及两个 I2C 地址回归通过 |
| 底盘 | 默认/严格 MANUAL 两种构建各 50264 检查通过（末次专项回归，额外覆盖上层持续刷新而传输忙时不得延租）；纯运动学、配置/NaN/Inf、时间回绕、租约、准备、停车、里程计及闭环模型 |
| 联合总线 | 使用真实 MotorBus、分片响应、异步发送/轮询；四轮在线且 5～7 离线、缺轮、使能拒绝、组 ACK 丢失、丢 STOP 首帧重试、持续停车未确认均覆盖 |
| 控制模型 | 独立轮速→车体正解、80 ms 惯性、整数 RPM、5 ms 测量延迟；八段约 42496 ms 完成，模型整轮回位约 (-0.5,-1.4) mm / 0.1°；只表示该模拟场景 |
| 结果真实性 | 新样本稳定窗、ACK 不到位、STOP 后才成功、停稳后外力位移越界失败、卡住超时、故障恢复不重放、段间清零中止 |
| 应用并行 | 七节点＋扫码＋慢 LCD：UI 最大单步 2 ms、gyro 最大轮询/样本间隔 3/14 ms、STOP 至 transport.send 2 ms；超预算绘图仍检出 GAP |
| 运动时并行 | 约 2.2 s 发 21 组速度，gyro 最大轮询/样本间隔 3/12 ms、扫码 21 次重复；手动抢占/测量清零被拒绝，全局 STOP 后无运动重放 |
| 正式默认配置 | 固定偏置宏=1 的应用构建验证上电不运动、配置拒绝与屏幕 STOP；不视为固定偏置实际精度通过 |
| Keil | AC5 LCD 全量构建 0 error / 0 warning；资源数值见下方最终构建记录 |

模型、屏幕替身及超时注入均不是实机结果。没有测量尺寸、架空四轮聚合/STOP 和地面三轮原始数据之前，交付状态保持 **软件已验证，实物待标定/待验收**。

日志在 `Output/chassis-full-tests.log`、`Output/chassis-focused-tests.log`、`Output/build.log`；map/调用图在 `Listings/YH-F429.map`、`Output/YH-F429.htm`。Output 可清理，关键资源和验收边界在本文保留；HEX 存在不代表已烧录。

最终 AC5 构建：Code=75372、RO-data=18392、RW-data=1708、ZI-data=15404 字节；相对 e04f31d 的历史记录分别增加 15808、880、4、1012 字节。map 中静态 app=6480 字节（历史 5472，增加 1008）；静态最大调用深度 1760 字节（历史 1248，增加 512），配置栈仍为 4096 字节。调用图含循环/不可追踪函数指针，不是实测栈高水位。

已构建 HEX：`Output/YH-F429.hex`，对应软件提交 `f9ec56f`；SHA256：`CCA797D6833A9ED92183A7CB0B59B63C7F91A0A2D60AA72096AA016BAFF252D9`。没有执行烧录。
