dadatiaoao/-1021ccc/Doc/MECHANISM_COLLISION_STAGE1_2026-11-06.md

# 第一阶段：三轴碰撞回零与完整停放

基线：`main` 的 `1c464dad7000d22652b1ddc1042667c6fdaad6ff`。本阶段只改现有机构、MotorBus 的回零位置查询优先级、对应主机测试与说明；未移入 PR #4 的视觉、抓取、比赛执行器或复制工程。原 PR #4 中 6 轴原生碰撞回零的协议思路及 900（0.1 电机度）退角作为来源，保留主工程的底盘、舵机启动策略和界面布局。

## 当前软件行为

上电等待地址 1～7 全部在线，位置/速度/状态反馈新鲜、零速、无驱动器故障、UNKNOWN 或未确认 STOP。初次使能在对应轴 PREPARE 阶段完成并确认，因此未使能本身不阻止启动。HOME 一旦接受便取消一次性自动启动意图；STOP 和失败均不会因通信恢复而重试，手动 HOME 是明确的重新启动入口。

串行流程为 **6 轴顶部接触 → 6 轴观察安全位置 → 5 轴收拢接触 → 5 轴工作角 → 7 轴外伸接触 → 7 轴中点 → 复核三轴停放、静止和参考 → HOME SUCCESS**。7 轴缺席不能跳过。6 轴原生退让恰好落在观察位置时，不再发送零脉冲位置命令，但仍等待新的位置样本、零速和稳定时间。完整 HOME SUCCESS 才可触发原有双舵机自动 PWM 启用门控。

| 轴 | 寻端速度 | 普通动作默认速度 | 碰撞坐标与普通范围 | 原生退角 | 最终停放 |
|---|---:|---:|---|---:|---:|
| 5 旋转 | 15 RPM | 20 RPM | 收拢接触点 0°；0～180° | 120 个 0.1 **电机度**，即机械臂约 4° | 90° |
| 6 升降 | 40 RPM | 60 RPM | 顶部接触点 0 mm，向下为正；普通目标 0～150 mm | 900 个 0.1 电机度，即名义 10 mm | 原 PR 观察物理位置，名义约 10 mm |
| 7 伸缩 | 150 RPM | 200 RPM | 伸出接触端回到 50 mm 行程中点后设 0 mm；普通目标 ±25 mm | 3600 个 0.1 电机度，即 1 mm | 行程中点 0 mm |

普通动作默认速度在配置结构中以机械臂度/秒或毫米/秒保存，分别为 40°/s、40 mm/s、约 3.333333 mm/s，发往驱动器时换算为表中的 RPM。普通命令允许的转速上限分别为 20.1/60.1/200.1 RPM，其中 0.1 是浮点换算余量，不表示默认动作再加速。

6 轴旧 PR 坐标按 `新坐标 = 旧坐标 + 名义退让 10 mm` 换算。因此旧观察 0 mm 对应新约 10 mm；旧抓取 130 mm 对应新约 140 mm。抓取功能属于第二阶段，目前只集中保存该姿态参数，未执行抓取。普通升降上限暂取 **150 mm**，低于 main 原 160 mm 指令上限并容纳后续约 140 mm 抓取点。main 旧零点取自限位退离位置，与 PR 的退让零点不同，不能仅凭 `160−10` 证明两者物理边界相同；此上限需实机核对有效余量，软件没有据坐标平移扩大行程。

第二阶段还需把夹爪闭合及允许上限统一改为 2450 μs，并在自动闭爪等待结束后让 6 轴返回本次抓取前高度；本阶段继续沿用 main 的 1700/2430 μs 舵机预设，没有接入抓取状态机。

三轴原生碰撞配置统一在 `mechanism_config.h`。300 RPM / 800 mA / 60 ms 为既有 7 轴及 PR 6 轴所用的驱动器识别试验参数，不能视作已量化的接触力。5 轴 4°固定退角参照旧限位回零后 4°避让幅度换算为 120 个 0.1 电机度，是新的**待实机核对试验值**，不是 5 轴碰撞回零已测得的退角。协议仍只写驱动器 RAM，不保存 EEPROM，也不启用驱动器独立上电回零。全部电机使用 3200 指令脉冲/圈；位置反馈使用 65536 counts/圈。5、6、7 轴传动分别为 120°、40 mm、1 mm/电机圈。

6 轴的退角参数 `900` 的单位是 0.1 电机度；它继续对应名义约 10 mm 退让，**不等于**本次更新的 1500 ms 无进展判定时间。

## 无进展与停车

三轴仅在原生碰撞寻端动作执行后，用该动作之后的新位置样本判定 **1500 ms 有效连续无进展**。累计位移死区分别为 5 轴 0.20°、6 轴 0.05 mm、7 轴 0.02 mm；它们与普通位置到位容差独立。相邻有效样本间隙超过 600 ms 会重新建立观察窗口；缓存或断流不会构成到端证据。时间差使用无符号 32 位差值以跨系统时钟回绕。启动时已在端部可被判为接触；观察到反向退让后不再执行寻端无进展判定。MotorBus 对回零轴的到期位置查询做局部优先处理，STOP 及停车核验仍优先，总线其余节点继续轮询，全局 1600 ms 新鲜度未放宽。

驱动器自行完成时，以退让后反馈位置反推接触点：5、6 轴从该接触点建立零位，7 轴移动到中点才建立零位。主控判到端时先请求原生回零中断，等待 STOP 经新速度和状态反馈确认、机构稳定及新位置样本，再以保存的接触位置为零点安排同一停放目标；7 轴从接触点退完整 25 mm。STOP 入队、ACK 或单次零速均不算停车确认。普通停放、回中和 TEST 卡住会失败，不转成到端成功。

PG2/PG3 仍采集真实 GPIO 并在屏幕限位页显示原始值及去抖结果，**不参与 HOME、普通运动许可、互锁、停车或故障决策**。软件姿态互锁仍有效：5 轴大范围旋转要求 6 轴处于顶部附近（0～10.5 mm）；6 轴下降要求 5 轴处于 90°±2°；7 轴普通微调要求 5 轴在该工作角窗口且 6 轴在观察点 ±0.5 mm。机构 TEST 从 90°/10 mm/中点开始，完成后回到该姿态。

## 软件验证与实机待办

本次 `Scripts/test_mechanism.ps1` 在普通与严格总线门控下通过；测试使用真实 `Mechanism_Process`、`MotorBus_Process` 和 Emm 帧仿真，覆盖七机门控、串行顺序、三轴原生/1500 ms 两路径、时钟回绕、开始即在端部、抖动、样本间隙、停车未确认、驱动故障、STOP、限位显示与软件互锁、TEST、最终停放完成前不报成功。主机反馈间隔断言不超过 600 ms，仍需在真实七机总线上记录间隔。`Scripts/test.ps1` 完整回归通过。`Project/YH-F429.uvprojx` 的 `LCD` 目标由 `Scripts/build.ps1 -Rebuild` 构建为 0 错误、0 警告。这些是主机仿真与编译结果，**本阶段尚未烧录或执行新固件的实机验收**。

实机验收需记录固件提交/HEX、地址 1～7 上电反馈及静止门控、每轴实际到端方式和接触/退让位置、回零轴真实样本最大间隔、STOP 确认时间、最终 5/6/7 姿态与 6 轴新坐标。分别试上电、手动 HOME、STOP 与再次明确 HOME，重点查 1500 ms 是否误判、5 轴 4°退角与三轴避让、6 轴 10/140 mm 对应的原实测物理位置及有效行程。原碰撞回零、视觉对准和抓取已有用户确认实测可用；本次三轴统一集成和 1500 ms 参数尚无实机结论。
