dadatiaoao/-1021ccc/Doc/GYRO_STAGE_TASK.md

# 【已过时，仅供参考】小阶段任务书：单旋转轴陀螺仪角速度与相对转角

> **维护状态：已过时，停止按当前版本维护（2026-11-04）。** 陀螺驱动已接入；当前按键采样校准阈值及新界面以 README 为准，不再遵循初始任务状态。 当前入口为[工程 README](../README.md)和[文档索引](README.md)。
> 以下正文、参数、截图、资源数字、测试/烧录状态及交接指令均保留为当时记录；即使使用“当前”“本轮”等措辞，也不适用于最新 main，不应直接执行。

> **已过时，仅供参考；当前状态、需求、配置和验收结论以 [工程 README](../README.md) 为准。**
> 归档标记：2026-10-22。以下保留原阶段目标、交付与验证记录，不代表当前仍待执行、未完成或已经实物验收；正文及嵌套文档中的旧交接指令不再直接执行。与 README 冲突时，以 README 为准。历史版本的测试证据及引用资料仅用于追溯。

日期：2026-10-21。本文件供新对话实施，是阶段目标与验收要求，不代表已实现或实测。本次仅编写任务书。

## 1. 明确需求与实施范围

用户提供的模块信息：**WDS601M-ICM-42688，封装 MODULE**；新增资料对应 **ICM-42688-P**。用户已更正并确认本次使用的 8 个引脚标识为 `VCC、GND、SCL、SDA、SA0、CS、INT1、INT2`，其中 SA0 末位为数字 0。后续以此为准，不再保留旧名称的拼写疑问。

2026-10-21 补充资料已核对：`E:/工创赛/硬件说明/ICM-42688-P加速度六轴IMU陀螺仪`。图片显示 WDS601M 带板载 MCU，支持芯片直连和 MCU 解算接口；上述 8 脚属于芯片直连侧。**本阶段采用芯片直连模式，主控采集角速度并计算相对转角**，模式选择要求见第 3、4 节。

用户已确认需要 **角速度＋相对转角**。本阶段按小车绕竖直轴转向使用，输出一个安装映射后的旋转轴；传感器 X/Y/Z 选择及正负号集中配置，不能默认电路板 Z 轴必然与车体竖直轴一致。

必须完成：身份识别、初始化、周期采样、角速度换算、静止零偏校准、相对转角积分、有效性与故障恢复、屏幕显示和使用说明。

**对工程进行最小限度的改动；给出最终运行效果；全部在现有 main 分支完成。**

- 不新建功能分支或 worktree，不切回旧版本，不重建 CubeMX；保留 HAL、Keil AC5、时钟及现有外设配置。
- 新增陀螺仪模块和必要测试；现有文件只做初始化、周期调用、UI 路由、工程引用与测试入口的增量修改。
- 不重构电机、光流、扫码，不批量改名/移动/格式化/转换编码。交付逐文件改动理由。
- 陀螺仪只提供测量，不新增电机控制，不接入闭环转向或导航；不实现全姿态、加速度位移积分、磁航向、卡尔曼融合、光流融合或比赛流程。
- 允许底层一次读取三轴陀螺用于安装轴选择和校准运动检测，但业务输出和主页面只围绕选定旋转轴。首版不为此强制启用加速度计或算法库。

相对转角是校准后角速度随时间的积分，会随零偏、温度、采样和安装误差漂移；没有外部航向参考，不能宣称绝对朝向、长期无漂移或固定精度。单轴投影只适用于安装轴基本竖直、车体近似平面运动的条件，不自动等价于任意姿态下的欧拉 yaw。

## 2. main 基线与必须保留的功能

本任务书核对时：分支 `main`，HEAD 为 `50b816b 文档：交付光流接线、使用说明与验证记录`，工作区干净。用户确认前阶段已完成；源码已包含扫码、七电机及光流。文档记录软件测试通过，但不能据此推断实物已验证。

实施前重新读取最新 Git 状态与源码，保留用户后续更改。README 中光流增补仍提到历史开发分支，它是开发记录，不是当前工作分支指令。

先读：

- `E:/工创赛/迁移野火板/README.md`。
- `Doc/MULTI_MOTOR.md`、`Doc/OPTICAL_FLOW.md`、`Doc/QR_UART.md`。
- `E:/工创赛/硬件说明/ICM-42688-P加速度六轴IMU陀螺仪` 中的两张产品说明图片。
- `User/main.c`、`User/app/qr_app.*`、`qr_ui.*`、`app_runtime.*`。
- `User/flow/flow_service.*`、`flow_ui.*`、`bsp_flow_spi.*`、`flow_config.h`。
- `User/touch/bsp_i2c_touch.*`、`User/flash/bsp_spi_flash.*`、LCD/SDRAM BSP。
- `User/motor/motor_test_config.h`、`Project/YH-F429.uvprojx`、`Scripts/test.ps1`、`Scripts/build.ps1`。

当前 QrApp 主循环负责七机总线、启动测试、触摸、扫码、光流和 UI；主程序不是独立陀螺仪例程。必须接入这条真实链路，不只交付未被调用的驱动。

保持以下行为：

1. 默认四轮上电一次性测试及最新电机门控/点动逻辑；不为校准陀螺仪擅自关闭、重放或改变它。
2. 扫码周期触发、锁定/重扫、UART5 七机通信、手动操作及 STOP。
3. FLOW/MORE 页面、后台采样、累计清零和错误恢复；陀螺仪操作不清空光流累计。
4. 新 UI 动作显式分发，不能因枚举范围判断误落入电机 `manual_action` 或取消启动测试。
5. 陀螺仪未接、校准失败或恢复过程中，其余应用继续运行，不停在全局初始化死循环。

本任务不要求自动提交或推送；若实际提交，只包含本阶段相关改动，不能夹带用户其它修改。

## 3. 资料来源与型号边界

用户新增的本地模块资料为两张产品说明图片，已直接阅读：

- [模块概述、参数与引脚图](E:/工创赛/硬件说明/ICM-42688-P加速度六轴IMU陀螺仪/O1CN017M4IpvQErgG1bS1C_!!2214417625444.webp)。
- [引脚表续页与模式选择](E:/工创赛/硬件说明/ICM-42688-P加速度六轴IMU陀螺仪/O1CN01o6f1eRSm9RK1bS1C_!!2214417625444.webp)。

图片确认 WDS601M 具有板载 MCU 和两种使用路径：芯片侧 I2C/SPI 直连；MCU 侧 UART/I2C 解算输出。图示板共 14 脚，用户本次明确的 8 脚对应 Pin1～Pin8；另一侧还包括 PS、INT、TX/DA、RX/CL 和电源脚，不能据图假定用户实物这些脚均已引出或接好。

模式说明写明：PS 悬空为独立陀螺仪芯片模式，需主控自行启动和配置；PS 接 VCC 为 MCU 串口模式；PS 接 GND 为 MCU I2C 模式，也可通过模块右下角焊点选择。实施前检查实物 PS/焊盘的现状，使之符合**芯片直连模式**；不是只在软件中选择 I2C 就完成模式切换。

图片标称模块 VCC 为 3～5 V、最快更新率 500 Hz、角度分辨率 0.01°。后两项未明确全部适用条件，不能当作本工程直连采样率、角度精度或验收保证。图片称提供 Arduino/ROS 示例，但当前目录只有图片，未提供代码、完整模块协议或原理图；不要宣称已读过厂家例程。板载 MCU 的融合输出也不属于本阶段实现路径。

可用的芯片一级参考：

- [TDK ICM-42688-P 产品与资料入口](https://www.invensense.tdk.com/en-us/products/6-axis/icm-42688-p)。
- [TDK DS-000347 v1.6 完整手册](https://product.tdk.cn/system/files/dam/doc/product/sensor/mortion-inertial/imu/data_sheet/ds-000347-icm-42688-p-v1.6.pdf)，本次核对了接口、电源、身份、量程及工作模式相关条目；不是 WDS601M 模块原理图。重点章节：电气规格、信号描述、接口、轴向、Use Notes、寄存器表。

按用户新增的 ICM-42688-P 资料确定芯片实现目标，实物仍通过丝印与身份读回核验。P/V 等变体不可混用；识别不匹配应报告原始值和型号问题，不能删除 ID 校验以便运行。现有图片足以明确接口路径，但未给出完整稳压、电平转换、上拉和内部总线连接电路；这些未展示内容不能凭板载 MCU 的存在推断。

ICM-42688-P 芯片参考事实：VDD/VDDIO 为 1.71～3.6 V；支持 I2C/SPI。I2C 下 CS 接 VDDIO，AD0 选择 7 位地址 0x68/0x69；WHO_AM_I 位于 0x75，期望 0x47。模块标称 VCC 3～5 V 不等于芯片接口允许 5 V 逻辑；本工程优先模块 3.3 V 供电、3.3 V 总线，并核对实际上拉和模式。引脚复用及未使用引脚处理依照芯片手册和模块资料。[依据：TDK 手册](https://product.tdk.cn/system/files/dam/doc/product/sensor/mortion-inertial/imu/data_sheet/ds-000347-icm-42688-p-v1.6.pdf)。

## 4. 接线与资源选择

### 模块引脚核对表

| 已确认标识 / 资料编号 | 接口含义与接入要求 |
|---|---|
| VCC / GND，Pin1 / Pin2 | 图片标称模块供电 3～5 V；本阶段采用 3.3 V 供电方案并共地，不据此推断信号脚耐受 5 V。 |
| SCL，Pin3 | 芯片 I2C SCL / SPI SCLK；首选 I2C 接入时接所选硬件 I2C 的 SCL。 |
| SDA，Pin4 | 芯片 I2C SDA / SPI 数据输入或双向数据；首选 I2C 接入时接 SDA，核对上拉。 |
| SA0，Pin5 | 芯片 I2C 地址选择 / SPI SDO。I2C 首选固定为低得到 0x68，若板载配置为高则使用 0x69；不得悬空，也不能在未检查已有连接前强行短接。 |
| CS，Pin6 | 芯片 SPI 片选；I2C 下保持有效的高电平，与 PS 模式选择分开，不悬空、不由其它设备片选控制。 |
| INT1 / INT2，Pin7 / Pin8 | 芯片中断引脚，不是初始化输入。首版不需要 DRDY 外接时不必占 MCU 引脚；仍按芯片配置处理 INT2 的复用及电平，不能笼统短接或向输出脚强驱动。 |

另检查资料中的 PS（Pin9）或右下角模式焊点：按图片设置为芯片直连模式。PS 的“悬空”要求只用于该模块模式选择，不能扩展为 SA0/CS 也可悬空。若实际仅提供上述 8 脚，应检查模式焊盘或板卡版本，而非虚构第 9 脚接线。MCU 侧 Pin10 INT、Pin11 TX/DA、Pin12 RX/CL 不能与本表芯片侧接口混用；不要让板载 MCU 与 F429 在错误模式下同时访问芯片。

实施完成必须给出模块丝印→MCU GPIO→**V1 核心板排针脚号**→方向/配置/电平的接线表，并注明证据。没有核实的 MCU 接线不得写成已确定事实。

优先评估一组未占用、已引出的独立硬件 I2C，先以 100 kHz 联调、必要时验证到 400 kHz。优先保证触摸与光流不受影响；若没有合适空闲引脚，再说明其它方案的实际改动，不为了复用而先改写整个总线层。首版只实现一种选定接口，不同时维护两套 I2C/SPI 驱动。

| 当前资源 | 约束 |
|---|---|
| 光流 SPI2 | PB13 SCLK、PC2 MISO、PC3 MOSI、PE3 CS，703125 Hz；不得当作空闲或改变其配置 |
| 板载 Flash SPI5 | PF7/PF8/PF9、PF6 CS；MSP 已按实例分发 |
| 触摸 I2C2 | PH4/PH5；PD11 RESET、PD13 INT；不得在恢复陀螺仪时复位触摸总线 |
| 电机 UART5 | PC12/PD2；DMA1 Stream0/7 |
| 扫码 USART3 与触发 | PB10/PB11；DMA1 Stream1；PB12 触发 |
| 调试串口 / 显示存储 | PA9/PA10；保留 LTDC、DMA2D、FMC/SDRAM 全部资源 |

核对实际 HAL MSP 的定义位置，新增实例只走自身分支。I2C 引脚用开漏，核对板载/外部上拉及其电源；不能用 MCU 内部弱上拉代替电气核算。7 位地址和 HAL 地址参数只在 BSP 层转换一次。

首版优先短、有限超时的事务与 data-ready 轮询，不强制新增 DMA/EXTI/FIFO。若实测主循环无法满足采样要求，再做最小必要的 DRDY/FIFO 扩展；说明其时序收益和资源代价。即使采用 HAL 短超时，也要核查本版本内部 BUSY 等待路径，不仅看调用参数。

## 5. 最小模块与数据接口

建议 `User/gyro/` 下组织少量文件，允许按工程风格合并，不为分层扩建框架：

| 模块 | 职责 |
|---|---|
| `bsp_gyro_bus.*` | 选定总线、GPIO、地址、短事务、有限恢复及错误 |
| `icm42688.*` | 身份、复位/配置、量程/ODR/滤波、数据就绪、连贯读取及解析 |
| `gyro_service.*` | 调度、选轴映射、校准、积分、快照与有效性 |
| `gyro_config.h` | 总线/轴/符号、量程/ODR、校准窗口及阈值、过期与重试参数 |
| `gyro_ui.*`（按需） | 简单 GYRO 页；沿用现有字体与局部刷新 |

建议接口为 `Gyro_Init`、`Gyro_Process(now)`、`Gyro_GetSnapshot`、`Gyro_RequestCalibration`、`Gyro_ZeroAngle`。测试可注入总线和时钟，不需新建通用设备框架。

快照至少包含：识别值、初始化/通信状态、选定轴与符号、原始角速度、校准零偏、校正角速度（°/s）、相对转角（°）、校准状态/进度、样本序号/时间/实际间隔、数据年龄、角速度有效与角度连续有效标志、饱和/丢样/错误计数、最近错误。

明确区分 RAW（原始速率）、UNCAL（未校准）、READY、CALIBRATING、STALE/ERROR 和 ANGLE GAP。未校准可显示原始速率供诊断，但不能标成“已校准角速度”，相对转角在首次成功校准前不可用。

## 6. 初始化、采样与相对转角

### 初始化和采样

1. 先确认模块 PS/焊盘为芯片直连模式；完成供电稳定、身份检查、软件复位及完成确认、寄存器 bank 选择、量程/ODR/滤波配置、陀螺仪启用和稳定等待，再允许发布样本；关键配置读回核对。全 0/FF 或错误 ID 不继续正常流程，不能改用另一侧 MCU 地址/协议掩盖模式错误。
2. 配置遵守所选版本的保留位、bank、接口模式及启动时序。手册中的“至少保持开启 45 ms”与“开启后 200 μs 内不写寄存器”是不同约束，不能把前者当作唯一启动条件；另核查启动就绪和首样本条件。[依据：TDK 手册 PWR_MGMT0](https://product.tdk.cn/system/files/dam/doc/product/sensor/mortion-inertial/imu/data_sheet/ds-000347-icm-42688-p-v1.6.pdf)。
3. 建议起点：陀螺低噪声工作、±500 °/s、100 Hz ODR、UI 10 Hz；这些是设计初值，不是实测保证。滤波参数须与 ODR 合法匹配，记录延迟；无需启用 DMP/APEX 或高分辨率 FIFO。
4. 从连贯样本组装有符号数据，明确字节序、所用输出格式和对应灵敏度。量程变化与换算系数必须同步，不混用普通寄存器与 FIFO 格式。验证边界、饱和及特殊无效值语义，不以裸字节全零判断静止样本非法。
5. 只有新的 data-ready 样本才能进入校准和积分；值与上一帧相同也可能是合法新样本，不能靠数值变化判断新鲜度。正确处理状态位清除规则和跨更新读取一致性。
6. 样本时间尽量靠近采集/DRDY；说明采用的是传感器时间还是 MCU 获取时间及误差。不能用 UI 刷新周期积分，也不能主循环每次调用就重复积分旧数据。
7. 报告实际采样周期、最长间隔、处理耗时和迟到情况。无 FIFO 时错过的帧不可恢复，不循环读同一最新寄存器伪造补采；若现有显示/触摸导致持续漏采，要调整调度或做必要缓冲，并保留证据。
8. 长等待及重试用状态机；每次调用限制事务数量，禁止 HAL_MAX_DELAY、长期忙等和中断绘图。使用已有时基时不得复位 DWT 或重配 SysTick，避免破坏光流计时。

### 静止零偏校准

- 默认上电完成识别后显示 UNCAL，等待显式 CAL 操作。**不能在四轮上电测试运行期间自动把转动平均成零偏。** 校准期间保持车体和模块静止；读取电机活动状态作为拒绝条件只能是辅助，电机停止不证明传感器静止。
- 建议以连续约 2 秒、满足预期样本数的窗口作为初值；窗口内数据必须新鲜、无丢样/饱和，均值和波动在可解释的限值内。阈值集中配置并标明待实测，不随意写“保证静止”。
- 用户明确保证静止，程序再检查波动与合理幅值。仅单轴陀螺无法可靠区分恒定慢转和偏置，不能宣称通过方差检查就证明没有运动。
- 校准过程中不发布有效相对转角、不触发电机；失败报告 MOVING/TIMEOUT/ERROR，不能用不完整窗口更新零偏。若有旧零偏则保留并注明本次失败，角度连续性另行失效，避免悄悄回到旧轨迹。
- 成功后设置本次零偏、相对角归零并建立新的积分基准。零偏首版仅保存在 RAM；不为本阶段增加 Flash 持久化。重新复位/重初始化后先回到待校准状态。
- 不在运行时无条件滑动修正零偏，不用死区把真实慢转长期吞掉。温度变化导致的漂移记录实测，首版不扩展温度补偿模型。

### 相对转角与清零

对安装映射后的角速度使用一致符号与单位：`ω = sign × (raw / sensitivity − bias)`；bias 必须在同一轴/单位约定下计算。相邻有效样本可用梯形积分：`Δθ = (ω_prev + ω_now) / 2 × dt_seconds`。

- 首样本只建立时间基准；不得从开机至首样本累计虚构转角。dt 用实际可解释时间并正确处理回绕。
- 内部保留连续累计角；UI 优先显示连续相对角，跨 ±180°/360°不跳变。若另提供归一化角，明确区间且不能覆盖连续积分状态。
- `ZERO` 只重建相对角基准，不重新估计偏置，不修改光流累计/扫码结果/电机模式。校准未成功或样本过期时拒绝 ZERO，并提示先校准/恢复；以最新有效样本定义清零边界。
- 无数据、读取失败、饱和、过大 dt 或已知漏采导致 ANGLE GAP：停止跨缺口积分，保留旧角作失效诊断，不用旧速率乘整段断连时间补齐。连续性失效应锁存；后续角速度恢复也不能自动声称旧角有效，需用户 ZERO 建立新段或重新 CAL。
- 传感器复位/重新配置、轴/符号/量程改变时废弃旧时间基准，按需要重校准；不能将两套尺度或方向的角度无提示拼接。

## 7. 最终运行效果

以下为交付目标，必须在实现说明和最终回复中逐项报告实际效果与验证状态。

| 操作或场景 | 应观察到的效果 |
|---|---|
| 正常上电 | 原扫码、七电机启动测试和光流正常进行；陀螺仪显示 INIT→UNCAL，身份读回可查看，不自动校准或新增动作。 |
| 未接陀螺仪 | 显示 NOT FOUND/ERROR，有限重试并退避；其它页面和 STOP 仍可使用。 |
| 进入 GYRO 页 | 显示选定轴/符号、角速度 °/s、相对角 °、校准状态、数据年龄和错误；无效值用 -- 或明确失效标记，不能以初始 0 冒充有效。 |
| 保持静止并点击 CAL | 提示保持静止并显示进度；满足窗口后 READY、角度从 0 开始；期间运动或异常则失败并说明原因。 |
| 绕安装转向轴正反转 | 校正角速度随方向正负变化，连续相对角随实际转动累计；通过实物验证轴映射，不提前猜顺/逆时针符号。 |
| 停止转动 | 角速度通常接近零，相对角大致保持但可缓慢漂移；交付记录真实漂移，不承诺永久不变。 |
| 点击 ZERO | 将当前有效相对角参考设为 0，保留零偏；长按只执行一次。重新校准需点 CAL，二者语义不同。 |
| 切到 QR/MOTOR/FLOW | 陀螺仪后台采样继续；扫码/光流和电机操作保持，切页、CAL、ZERO 不发电机命令。 |
| 断连、漏采、饱和或过期 | 显示对应错误及 ANGLE GAP，旧角不继续冒充有效转角；不补算未知运动。 |
| 通信恢复 | 恢复识别和采样；重初始化需重新 CAL，普通连续性缺口按 ZERO/CAL 建立新基准，不恢复未知航向。 |

沿用现有 480×272 布局与字体，以一个简单 GYRO 页及 CAL/ZERO/返回控件完成，不重做整个 UI。全体 STOP 在 GYRO 页始终可访问，并复用原语义。

操作指南需能直接照做：实际接线→上电→等待现有电机测试完成并确认静止→进入 GYRO→CAL→正反向转动→ZERO→故障恢复。测试时可使用明确关闭启动动作的测试构建，但不得修改 main 中现有电机默认配置来迁就陀螺校准；说明最终构建使用的配置。

## 8. 测试与阶段验收

按“资料/接线核对→独立驱动与服务→主循环/UI 集成→main 全量回归”推进。资料暂缺时先做接口、状态机和模拟测试，不编造模块供电、具体接线或实物结果。

新增有意义的测试至少覆盖：

- 正确/错误身份、bank/配置读回、复位/启动等待、超时/NACK/BUSY、恢复及不会阻塞原应用。
- 正负数、字节序、量程换算、轴/反号映射、饱和和无效输出；同值新样本与重复旧样本的区别。
- 校准成功、运动/丢样/超时失败、窗口不完整、失败保留旧偏置且不恢复无效角度；电机启动活动时不校准。
- 假时钟下已知恒定/分段角速度的积分、首帧、变 dt、计时回绕、跨 360°、ZERO、CAL 与不重复积分。
- 中断/缺帧后不跨段积分，恢复数据后 ANGLE GAP 不自动消失，重初始化需校准。
- CAL/ZERO/切页的按下边沿处理，长按不重复操作；GYRO 页 STOP 可用，动作不串到电机控制分支。
- 七机/扫码/光流/触摸并行，陀螺仪缺失和恢复不破坏既有行为，报告实际调度预算。

在 `E:/工创赛/迁移野火板` 的 main 上运行：

```powershell
powershell -NoProfile -ExecutionPolicy Bypass -File Scripts/test.ps1
powershell -NoProfile -ExecutionPolicy Bypass -File Scripts/build.ps1 -Rebuild
```

要求现有与新增主机测试通过、Keil 0 错误 0 警告，不删断言掩盖回归。核查新增 RAM/栈与浮点格式化开销；纯服务测试应验证数值与状态，不只验证 UI 文本或固定断言数量。文档改动本身不需要重编全部固件。

实物验收单列：身份与接线、总线波形、样本时序、静止校准、正反向与重复 90°/180°/360°转动、静止 30/60 秒漂移、运行前后温度影响、断连与恢复、四模块并行。使用独立角度标记或量具作参考，不把电机命令角度直接当作实测真值。报告实际误差和条件，不预先承诺精度门槛。没有设备时列出待实测项，软件通过不能写成实物验收通过。

## 9. 交付物与新对话提示

应交付：main 中的最小实现与集成、主机测试、`Doc/GYRO.md`（来源/型号边界、接线、配置/API、校准与积分规则、最终运行效果和操作指南、逐文件改动理由、构建/测试结果及实物待验项）。README 仅增量记录已落地或用户已确认事实。

可直接发给新对话：

> 请读取并执行 E:/工创赛/迁移野火板/Doc/GYRO_STAGE_TASK.md，直接在当前 main 分支完成 WDS601M-ICM-42688 模块接入，不新建分支或 worktree。先读用户新增资料 E:/工创赛/硬件说明/ICM-42688-P加速度六轴IMU陀螺仪 中的两张说明图片，再核对 TDK 芯片手册。用户已确认引脚为 VCC、GND、SCL、SDA、SA0、CS、INT1、INT2，对应芯片直连侧；模块另有板载 MCU 解算路径，本阶段不使用它。检查 PS/模式焊点为芯片直连状态，优先采用 3.3 V 和独立硬件 I2C，明确 CS/SA0 状态与实际接线。用户只需要小车旋转轴的角速度（°/s）和相对转角（°），安装轴/符号可配置。完成识别、初始化、新鲜样本采集、静止零偏校准、相对角积分、无效/断连处理、GYRO 页及测试。要求对工程进行最小限度的改动，不重建 CubeMX，不重构电机/光流/扫码，保留最新 main 的默认电机启动测试与现有操作；上电不无条件校准，CAL/ZERO 不触发电机。不得将相对积分角当作绝对航向。完成现有及新增主机测试和 Keil 构建，交付接线、逐文件理由、最终运行效果与操作步骤，区分软件验证和实物待验项。先检查工作区并保留已有修改。
