dadatiaoao/-1021ccc/Doc/MECHANISM_IMPLEMENTATION_2026-10-24.md

# 机构模块交付与标定说明

> **历史文档，不再作为当前参数、7 轴行为或当前构建产物的参考。** 2026-10-26 更新：5/6 快慢回零为 24/6、60/12 RPM，5 首次搜索 360°；7 为单头 1 mm 螺距直联、总行程 50 mm、正向伸出，当前为原生碰撞回零配合主控无进展寻端，确认停车后缩回中点；用户已确认 7 轴回零功能实测完成，已移除临时电流采样显示。本轮自动归中衔接改动待烧录复核。当前事实、参数、流程及待验项目统一见[机构标定记录](MECHANISM_CALIBRATION_TODO_2026-10-25.md)与 [mechanism_config.h](../User/mechanism/mechanism_config.h)。以下保留当时方案和验证历史，旧会话零点及“无边界”约定已被替代。2026-10-26 用户进一步实机确认：**全部 1～7 号电机均为 3200 指令脉冲/电机圈，6 号同步轮 20 齿、同步带齿距 2 mm，对应 40 mm/电机圈**。下文相关“假设/待核对”仅保留为确认前的历史状态，不再是当前待办。

日期：2026-10-24。分支：`codex/chassis-motor-odometry`；实施基线 `ec11ff2`。

**后续配置覆盖：默认启用 TRIAL=1；全部 1～7 号电机 3200 指令脉冲/圈、6 号 20 齿 × 2 mm＝40 mm/圈已于 2026-10-26 实机确认。160 mm 指令上限对应的真实底部余量仍未验证。当前参数及流程见[机构标定记录](MECHANISM_CALIBRATION_TODO_2026-10-25.md)和 [mechanism_config.h](../User/mechanism/mechanism_config.h)。下文默认值、旧 UI、资源及 HEX 校验值保留为历史交付记录。**

已实现 5/6 号有界回零、7 号会话相对零点、非阻塞角度/毫米接口、限位与停车确认、机械姿态联锁和屏幕单轮验收。**在 `49be15a` 交付时，机械标定值和确认标志仍为 0，上电、HOME、TEST 和机构位置 API 均不能放行未标定运动。没有烧录，没有接线、负载保持、停距或机械精度的实机验收结果。**

开始时该分支已有暂存机构计划和 README 的 stash 应用冲突。本次合并保留了机构确认事项和电机里程计底盘说明，纳入原计划，未合并、切换或重建其他分支。原 stash 保留。MotorBus、Emm 协议、UART5 传输实现未修改；扫码、FLOW、GYRO、底盘里程计及原 1～4 号手动控制保留。未实施 K230 协议、比赛任务、舵机、视觉或 CAN。

## 接线与输入

| 轴 | 限位输入 | 接法与电平 |
|---|---|---|
| 5 ARM | PG2 / J7-41，车内收拢端 | COM → 核心板 GND；NC → 上拉输入；NO 悬空 |
| 6 LIFT | PG3 / J7-43，最上端 | 同上 |
| 7 TRIM | 无输入 | 不找限位、不设机械行程上下界、不自动回中心 |

释放时 COM–NC 导通，输入低；按下或回路断开为高，单输入不能区分这两种情况。对地短路持续低，只能由有界搜索未触发发现。沿用计划中 3.3 V 外部 4.7 kΩ 上拉、1 kΩ 串联和 MCU 侧 10 nF 初始接法，内部上拉辅助；仅初始化 GPIOG 的 2/3 两位。实际端子和排针方向用万用表核对。

每轮在 `MotorBus_Process` 选取下一事务前采样限位并推进机构。按真实经过时间连续 20 ms 确认稳定；活动期间采样空档超过 10 ms 停车失败，不用补采样掩盖空档。寻零方向的原始高电平立即锁存 STOP，随后再等稳定触发与停车确认；200 ms 内不能稳定确认则 `LIMIT UNSTABLE`，不会继续原搜索。

GPIO 触发后停车仍依赖共享 TTL 总线、DMA、隔离和反馈，不是驱动器硬件限位。开关必须留出实测停距，软件停止不自动失能 6 号；负载保持不能当作机械抱闸。

## 集中标定与放行

唯一实物参数入口为 [`MECHANISM_CALIBRATION`](../User/mechanism/mechanism_config.h)。初始化复制配置；运行中不直接修改，参数变更应在确认停车后重新初始化并重新回零。测试中的参数全部是合成数据，不写入此入口。

| 配置 | 必须实测或核对的内容 |
|---|---|
| `axis[0..2]` | 每电机圈机构角度/毫米、指令 pulses/rev、协议正向符号、最大 RPM、动作速度、容差与 `calibrated` |
| `home[0..1]` | 5/6 最大软件位置、初始退离上限、快寻上限、退让量、慢寻上限、最终释放退让量；接线与回零余量/方向确认 |
| 姿态 | 从软件零点量得的车外工作角、顶部窗口、车外角度窗口 |
| `49be15a` 历史调试候选，非当前参数 | 快寻 5 RPM、慢寻/退离 2 RPM、加速度字段 100，5 号 1° / 6、7 号 0.5 mm 容差；必须结合实测传动与停距确认，不等于安全实测值 |
| 验收幅度 | 6 号 +5 mm；7 号本轮起点 ±5 mm；这是用户指定测试幅度，不能推定总行程 |

`home` 只有两项，7 号没有机械边界字段。`CONFIG REQUIRED` 时仍可查看原始限位、在线/使能、计数和反馈年龄。CFG 位为：1=换算，2=方向，4=确认，8=运动参数，16=回零参数，32=姿态参数；分别显示 5/6/7 缺项掩码。

命令采用 `EMM_REL_ACTUAL`，反馈为每电机圈 65536 counts，与命令脉冲数不同。使用宽中间量检查数值、脉冲、RPM、反馈可观测范围和 100～60000 ms 的位置动作时限；不截断超范围请求，不用零脉冲假动作。超时按量化 RPM 与实际脉冲距离计算为预计时间的 3 倍加 1 s，排队另留 1 s；不可表示的动作直接拒绝。

## 回零、坐标与接口

标定放行后每次初始化只自动尝试一轮：先检查两路稳定输入与 5/6 反馈，已发现或已命令的车轮先停车确认；6 号顶部回零后，5 号收拢回零。缺少 5 或 6 则失败。独立机构台架不要求从未出现的车轮在线；已活动的底盘拒绝机构请求。

每轴执行 `CHECK → INITIAL_RELEASE（若初始高）→ FAST_SEEK → BACKOFF → SLOW_SEEK → PARK_RELEASE`。两次寻零都有最大距离；触发后提前 STOP，退离均有界，找不到/退不掉/停不住则锁存失败，不反转猜方向、不扩大距离。慢速触发停车后读取新位置保存接近点，最终退离到开关稳定释放且停稳后，再读取新位置建立软件零点。开关接触点不是软件零点。

5/6 坐标质量为 `HOMED`：ARM 从车内向外为正，单位 °；LIFT 从顶部向下为正，单位 mm。7 若配置有效且在线，首次使能后等零速稳定窗及新位置，以原位置建立 `SESSION_REFERENCE`，不发生找零运动；向前为正，单位 mm。7 缺席不否定两轴回零，但 TEST 显示/拒绝 `TRIM NOT READY`。不清驱动坐标，不写 EEPROM。

公共接口见 [`mechanism.h`](../User/mechanism/mechanism.h)：

```c
Mechanism_HomeAll(m, now_ms);
Mechanism_MoveTo(m, MECH_ARM, angle_deg, deg_per_s, now_ms);
Mechanism_MoveRelative(m, MECH_LIFT, delta_mm, mm_per_s, now_ms);
Mechanism_MoveTo(m, MECH_TRIM, session_mm, mm_per_s, now_ms);
Mechanism_StartAcceptance(m, now_ms);
Mechanism_Stop(m, now_ms);
Mechanism_GetSnapshot(m, &snapshot);
```

调用立即返回 `ACCEPTED/BUSY/NOT_READY/INVALID`；执行结果单独为 `NONE/RUNNING/SUCCESS/FAILED/CANCELLED`。一次仅允许一个机构轴动作或一条机构序列，活动请求不会被重复点击覆盖。独立调用方每轮先调用 `Mechanism_SampleLimits`，再 `Mechanism_Process`，最后 `MotorBus_Process`；应用已绑定机构与底盘双向互斥。

旋转要求 6 号已回零、顶部窗口内、使能健康且零速；正常下降要求 5 号已回零、车外工作角窗口内且静止。5/6 普通位置限制在 `0..max_position`；7 仅检查数值、协议能力、超时和总线健康，不检查机械行程边界。旧 MOTOR 页 5～7 的使能/点动/原始脉冲 RUN 统一拒绝并指向 MECH，不能绕过机构检查。

ACK 不等于到位；完成同时检查匹配的总线请求号、MotorBus 完成、新鲜位置/速度/状态、零速稳定窗和机构单位目标误差。限位中止不要求走完原搜索目标。STOP 沿用 MotorBus 的提交后新速度/状态确认与持续重试；3 s 未确认仍持有控制权，不能清掉停止意图。普通取消且反馈持续可信可保留已有参考；失能、通信/驱动故障或位置不可信则使相关参考失效。失败原因锁存，STOP 不把 FAILED 改成成功或取消；显式 HOME 可在条件恢复和停车确认后重试，绝不自动重跑。

## 历史屏幕验收入口（当前入口见 UI 改版说明）

`MOTOR → 5/6/7 任一轴详情 → 标题 MECH [tap]` 进入机构页。HOME、TEST、全局 STOP、BACK 位于底部；点标题依次查看总览和三轴详情。页面沿用单步条带/两字符绘图，切页继续服务。显示回零轴/子步骤、HOMED 或 SESSION、度/mm、NC 原始/稳定电平、使能/在线、反馈年龄、CFG、停止待确认和失败原因。

TEST 需三轴参考、反馈、静止和标定有效，且 5/6 在收拢/顶部停放窗口。每次只执行一轮，段间停稳等待 500 ms：

1. 5 到标定车外工作角（实物约 90°，默认不填猜值）。
2. 6 到 +5 mm，再回 0。
3. 7 从本轮起点 +5 mm、回起点、−5 mm、回起点；不重定义会话零点。
4. 6 仍在顶部、7 已回位后，5 回 0；共八段，显示 DONE。

异常显示 FAILED，用户 STOP 显示 CANCELLED，均不推进下一段。全局 STOP、退出 MANUAL 等入口先取消机构/底盘生产者，再调用原 MotorBus 停止接口。K230/比赛 READY 尚未实现，HOME READY 不代表比赛可启动。

## 验证记录

主机：`Scripts/test.ps1`，MSVC `/W4 /WX`，覆盖原扫码、多电机默认/严格模式、UART、底盘、FLOW、GYRO 及应用回归；新增 `Scripts/test_mechanism.ps1` 在默认/严格两种 MotorBus 门控下，各 **6319 项**通过。真实 MotorBus 配合独立机械替身验证回零顺序、双次接近与停车后新位置、按住开关上电、7 缺席、部分车轮台架、NC 断路/对地短路/抖动、时钟回绕与采样空档、STOP 首帧丢失/持续不确认、延迟/丢失 ACK、使能失败、反馈过期/位置不刷新、保护/堵转、方向错误、单位/符号/NaN/Inf/溢出、较紧物理误差窗口和一轮八段验收。

实际 QrApp 联合替身验证 NC 对应、配置门控、重复 HOME/TEST、旧手动入口封堵、底盘仲裁、诊断切页、持续扫码与原始限位先停车。慢 LCD 替身单步 ≤2 ms，限位采样最大间隙 ≤10 ms；原有七节点并行场景 gyro 最大轮询/样本间隔 3/14 ms、全局 STOP 至发送 2 ms。**这些是合成模型结果，不是实板或机械停稳时间。** UI 图为 `Output/host-tests/mechanism_config_nc.pgm` 和 `mechanism_cancelled.pgm`。

Keil：`Scripts/build.ps1 -Rebuild`，目标 LCD / AC5 5.06u7，0 错误、0 警告。受限启动时曾出现 DLL 重定位，单独 `--vsn` 在沙箱外正常，随后在沙箱外运行原构建脚本成功；没有改系统 DLL 或工具链。最终资源和 HEX 校验值见下方记录。

| 最终构建项目 | 字节 / 值 |
|---|---|
| Code / RO-data | 86024 / 19196 |
| RW-data / ZI-data | 1708 / 18716 |
| AC5 静态 `app` | 9792（底盘基线 9360，增加 432） |
| HEX SHA256 | `546C7B5A68393930E3A38D9EAAA5D193DAF634F9D8EBFE0542466E6CFA564821` |

日志 `Output/mechanism-full-tests.log`、`Output/build.log`；HEX、AXF、map、日志与 UI 图被 Git 忽略，存在产物不等于已经烧录。配置栈保留 4096 字节；静态最大调用深度仍为 1752 字节加未知循环/函数指针项，不能当作实测栈高水位。当前主机 `sizeof(Mechanism)=456` 字节。

`49be15a` 交付时的实机待办（已知项以当前配置注释为准）：先逐个核对限位释放低/按下及断路高，再测量并录入三轴换算/方向、5/6 有界距离/停距/行程和工作姿态；验证 6 号带载保持，至少三次回零与三轮 TEST，用外部角度/长度量具记录误差和故障停车。实机目标、记录表项和接线细节仍参照[机构计划](MECHANISM_STAGE_PLAN_2026-10-24.md)第 8.4 节；不得用增加显示容差替代机械验收。
