dadatiaoao/-1021ccc/Doc/MECHANISM_STAGE_PLAN_2026-10-24.md

# 旋转臂、上下臂与微调臂模块计划书

> **历史文档，不再作为当前参数、7 轴行为或当前构建产物的参考。** 2026-10-26 更新：5/6 快慢回零为 24/6、60/12 RPM，5 首次搜索 360°；7 为单头 1 mm 螺距直联、总行程 50 mm、正向伸出，当前为原生碰撞回零配合主控无进展寻端，确认停车后缩回中点；用户已确认 7 轴回零功能实测完成，已移除临时电流采样显示。本轮自动归中衔接改动待烧录复核。当前事实、参数、流程及待验项目统一见[机构标定记录](MECHANISM_CALIBRATION_TODO_2026-10-25.md)与 [mechanism_config.h](../User/mechanism/mechanism_config.h)。以下保留当时方案和验证历史，旧会话零点及“无边界”约定已被替代。2026-10-26 用户进一步实机确认：**全部 1～7 号电机均为 3200 指令脉冲/电机圈，6 号同步轮 20 齿、同步带齿距 2 mm，对应 40 mm/电机圈**。下文相关“假设/待核对”仅保留为确认前的历史状态，不再是当前待办。

日期：2026-10-24。适用工程：野火 STM32F429 挑战者 V1 核心板。计划最初基于 `main / 01c8a68`；现按用户指示在 `codex/chassis-motor-odometry / ec11ff2` 实施，保留电机里程计底盘。

**本文件保留 2026-10-24 的设计和待办历史，不作为当前参数或已知状态的来源。当前以 [mechanism_config.h](../User/mechanism/mechanism_config.h) 的配置及注释为准：5 号 1:3 减速与 5/6 回零方向已确认，全部电机 3200 指令脉冲/圈、6 号 20 齿 × 2 mm＝40 mm/圈已于 2026-10-26 实机确认，160 mm 指令上限的真实底部余量仍未验证。当前行为见[机构标定记录](MECHANISM_CALIBRATION_TODO_2026-10-25.md)，历史交付见[机构交付说明](MECHANISM_IMPLEMENTATION_2026-10-24.md)。** 读者应同时参考[工程 README](../README.md)和[行为层总计划](BEHAVIOR_MASTER_PLAN_2026-10-22.md)，但本文件所列用户确认优先于旧的“限位数量/位置待定”描述。

## 1. 本次确认与 Git 基线

### 1.1 用户已经确认的机械条件

| 电机地址 | 机构 | 本阶段定义 |
|---|---|---|
| 5 | 旋转臂 ARM | 一个机械微动限位，位于车内收拢端；从收拢处向外约 90° 到完全旋出车身的位置 |
| 6 | 上下臂 LIFT | 一个机械微动限位，位于最上端；回零方向为向上 |
| 7 | 前后微调臂 TRIM | 暂不接限位；用户指定两侧有足够空间，本阶段不考虑机械行程边界，不增加软限位或边界避让 |

两个限位开关均有 COM、NO、NC 三个接点。上电自动完成两轴回零，顺序固定为 **6 号升到顶部 → 5 号回收拢位**，7 号保持原位；用户确认该顺序能够避碰。

屏幕验收顺序已经确认：**顶部位置旋到车外 → 上下臂下降 5 mm 再升回 → 微调臂前后各 5 mm 并回到本次零点 → 旋转臂回收拢位**。屏幕持续显示各部分状态，其他采样/通信继续运行。

### 1.2 计划编写时的分支操作（历史，不重复执行）

- 原 main 为 `d0f5e86`，本地“电机调参”为 `01c8a68`；已通过 `git merge --ff-only` 快进合并，main 包含 `fd6a80f` 和 `01c8a68`。
- 验证“电机调参”已被 main 包含后，用 `git branch -d` 删除该本地分支；未发现同名远端分支，本次未推送远端。
- 切换前位于 `codex/chassis-motor-odometry / ec11ff2`。该分支比“电机调参”多了电机里程计改动，本次按用户明确指定的分支范围保留它，未将其额外提交混入 main。因此本计划基于的 main 仍为光流＋gyro 底盘方案。
- 原 Keil `uvoptx` 文件只有 Git 归一化后的换行差异，已保留原始文件于 `Output/merge-backup-20261024/`，并留有同日命名的 stash；未将其他分支的本地选项覆盖到 main。

## 2. 模块边界与最小改动

继续使用现有 UART5、Emm 协议、MotorBus 七节点、位置/速度/状态反馈和 STOP 证据链。新增机构服务，不另开串口发送者，不增加 RTOS，不在 ISR 或动作函数内等待运动结束。

建议新增 `User/mechanism/`：

- `bsp_limit_gpio.*`：PG2/PG3 初始化与原始电平读取，无电机操作。
- `mechanism_config.h`：三轴单位换算、方向、回零距离/速度、姿态及验收参数。
- `mechanism.*`：限位去抖、单轴动作、两轴顺序回零、软件坐标基准、控制权与结果快照。
- `mechanism_ui.*`：生成机构页文本，复用现有分步绘图；验收序列作为机构服务内的小状态机，不建立通用任务框架。

既有文件只在必要处扩展：QrApp 持有/调度机构服务，统一 UI 加入口和按钮，Keil 工程/主机测试脚本加入新文件。MotorBus、协议和底层通信优先原样复用；不为本阶段增加电机端清零命令或 EEPROM 写入。

本阶段不实施 K230、抓放流程、舵机、三槽位姿、视觉对心或 CAN 迁移。机构就绪不等于比赛 READY；最终由比赛层综合所需状态。

## 3. 引脚配置与接线

### 3.1 已核查的引脚分配

依据本地 V1 核心板原理图第 1 页排针、第 2 页 MCU 网络，并核查当前 `User/` 的 LCD、SDRAM、触摸、UART、SPI、I2C、LED 初始化。

| 信号 | MCU 引脚 | 芯片脚号 | V1 核心板排针 | 原图网络/备注 | 计划模式 |
|---|---|---|---|---|---|
| ARM_HOME，5 号旋转臂限位 | PG2 | 106 | **J7-41** | PG2 / CAMERA_RST；本车未使用 F429 DCMI 摄像头 | GPIO 输入，内部上拉 |
| LIFT_HOME，6 号上下臂限位 | PG3 | 107 | **J7-43** | PG3 / CAMERA_PWDN；同上 | GPIO 输入，内部上拉 |
| 7 号微调臂限位 | 不分配 | — | — | 本阶段无此输入 | 不初始化、不检查 |

PG2/PG3 没有被当前 LTDC、FMC/SDRAM、触摸、Flash、UART5、USART1/3、SPI2、I2C1 使用。不要把同为 PIN_2/PIN_3 的其他 GPIO 端口误判成冲突。K230 使用 USART1，不占用这两个相机控制网络；以后若给 F429 接 DCMI 相机，必须重新分配。

仅开启 GPIOG 时钟并初始化这两位，不重新初始化 GPIOG 整组，避免影响 LCD/SDRAM。不采用旧开源工程的 PD14/PD15，它们连接本板 SDRAM 数据线。

### 3.2 固定采用 NC 接法

两只开关分别采用同样的电路：

```text
核心板 3.3 V ── 4.7 kΩ ── S ── 1 kΩ ── PG2 或 PG3
                           │             │
                       开关 NC          10 nF
                       开关 COM          │
                           │             │
核心板 GND ────────────────┴─────────────┘

NO 悬空，不接电机电源。
```

4.7 kΩ 为外部上拉，1 kΩ 为输入串联电阻，10 nF 电容放 MCU 侧靠近接入点；它们是本方案的初始硬件配置，不是厂家对该开关的规定值。内部上拉作为辅助，不以内部上拉代替确定的外部接线。每个开关单独一根信号线，共用核心板参考地。

| 实际状态 | COM–NC | 输入 | 软件含义 |
|---|---|---|---|
| 未压下 | 导通 | 低 | 未触发 |
| 压下 | 断开 | 高 | 触发 |
| 信号线或 COM 回路断开 | 断开 | 高 | 与触发相同，不能宣称能区分断线和压下 |
| 输入对地短路 | 持续低 | 低 | 单输入不能直接识别，靠找零最大行程/超时发现未触发 |

接线前用万用表确认释放时 COM–NC 导通、压下时断开；不能只凭外壳端子位置猜测。两个输入只连接上述 3.3 V 逻辑/干接点，不接 5/12/24 V。供电取核心板明确标识的 3V3、GND，不把排针朝向或未核实的供电脚号写死；J7-41/43 按实物 1 脚标记数针核对。

信号与 GND 成对布线，尽量远离电机供电线；不将开关直接串进升降电机电源或使能回路，避免把停车变成失去保持力矩。

GPIO 输入模式与上下拉原则可参考 [ST GPIO 指南](https://wiki.stmicroelectronics.cn/stm32mcu/wiki/Getting_started_with_GPIO)。具体选脚、阻容数值和接法由上述本地原理图及本项目设计确定。

### 3.3 限位采样、去抖及停车时机

- 首版使用前台轮询，不增加 EXTI；每轮在 MotorBus 选取下一发送事务**之前**采样限位并处理停止意图。
- 采样目标间隔 1 ms，记录实际最大间隔；运行期间超过 10 ms 的采样空档视为限位监测中断，请求停车并报告原因。不得用连续快速调用补齐遗漏的采样次数。
- 稳态确认采用实际时间连续 20 ms，而不是“读 20 次”。上电先完成稳态确认，再决定是否已经压住开关。
- 向限位方向运动时，第一次原始高电平就锁存事件、请求 STOP；20 ms 去抖用于判断这个触发是否可信，不先继续顶着开关等去抖。
- 退离阶段允许初始高电平，仅允许已配置的远离限位方向、有最大距离/超时的运动；稳定释放后按状态机继续，不允许自动反转猜方向。
- 原始触发后若 200 ms 内无法稳定确认，记 `LIMIT_UNSTABLE`，本轮失败，不自动恢复原寻零动作。记录触发时间、停车请求/提交时间、最终位置及电平。

GPIO 触发后仍通过共享串口请求停车，既有 DMA 帧、隔离和反馈会带来延迟；开关应在机械硬顶点之前有足够触发行程，回零速度按实测停距确定。此接法不是电机端硬件限位，软件不能保证 MCU 停机或通信完全断开时立即停车。

## 4. 坐标与对外接口

### 4.1 单位与零点

| 轴 | 对外单位与正方向 | 零点来源 |
|---|---|---|
| ARM/5 | °，从车内向车外为正 | 收拢限位低速二次接近、停稳后，退到开关释放的停放位置，定义该位置为软件 0° |
| LIFT/6 | mm，从顶部向下为正 | 顶部限位低速二次接近、停稳后，向下退到开关释放的停放位置，定义该位置为软件 0 mm |
| TRIM/7 | mm，向前伸出为正、缩回为负 | 本次初始化后首次使能、稳定零速和新鲜位置确认时的当前位置定义为 0 mm；不发生寻找原点运动 |

开关的触发点与软件停放零点不同。将实测停车退让量记录为 `home_clearance`；“顶部”“收拢”在正常接口中均指该释放后的停放零点。约 90° 旋出角需要以此零点实测修正，不能把开关接触角与软件零点混用。

5/6 的参考质量为 `HOMED`，7 为 `SESSION_REFERENCE`，屏幕明确区分。7 号不宣称找到了机械原点，重启后零点可以不同。7 号不设最小/最大位置、越界故障或自动回中心；保留数值合法性、协议范围、动作超时、堵转/保护、通信和停止检查，这些不是机械边界判断。

不清电机内部坐标，不写电机持久化参数。记录每轴 `origin_counts`，用相对原点的反馈计数换算机构位置；当前协议反馈为电机每圈 65536 counts，命令脉冲数与它不是同一单位。

### 4.2 计划接口

```c
/* 所有动作只提交意图，立即返回。所有时间使用毫秒。 */
void Mechanism_Init(Mechanism *m, MotorBus *bus,
                    const MechanismConfig *cfg, uint32_t now_ms);
void Mechanism_Process(Mechanism *m, uint32_t now_ms);
MechanismRequestResult Mechanism_HomeAll(Mechanism *m, uint32_t now_ms);
MechanismRequestResult Mechanism_MoveTo(Mechanism *m, MechanismAxis axis,
    float target, float speed, uint32_t now_ms);
MechanismRequestResult Mechanism_MoveRelative(Mechanism *m, MechanismAxis axis,
    float delta, float speed, uint32_t now_ms);
void Mechanism_Stop(Mechanism *m, uint32_t now_ms);
void Mechanism_GetSnapshot(const Mechanism *m, MechanismSnapshot *out);
MechanismRequestResult Mechanism_StartAcceptance(Mechanism *m, uint32_t now_ms);
```

`axis` 为 ARM/LIFT/TRIM；target/delta 和 speed 随轴使用 °/°/s 或 mm/mm/s。请求返回 `ACCEPTED/BUSY/NOT_READY/INVALID`；另有动作结果 `NONE/RUNNING/SUCCESS/FAILED/CANCELLED`。快照保留请求号、当前轴/子步骤、坐标参考质量、目标/实际位置、限位原始/稳定电平、使能、反馈年龄、停止待确认及首个失败原因。

首版同一机构服务一次只执行一个轴的动作。新的请求不覆盖正在执行的动作；返回 BUSY。全序列由上层或内置验收状态机按完成结果推进，不能靠 HAL_Delay 猜测上一动作完成。

## 5. 电机动作与两轴回零算法

### 5.1 选择已有的位置模式，避免额外改造总线

正常位置动作与寻零都使用现有 `MotorBus_Submit()`＋`Emm_MoveEx()`。寻零采用**有最大位移的扫寻位置命令**，碰开关后提前 STOP；如果完整扫寻已经走完却没触发，立即失败，不再次加长距离继续撞。

这比无限发送速度命令更适合当前工程：现有单轴 Submit 不允许在该轴正在运动时不断覆盖速度，而位置动作已经具备目标计数、执行期限和到位反馈。无需为了回零增加“单轴速度续租”或另一个串口写入者。

- 单轴相对移动统一用 `EMM_REL_ACTUAL`。MoveTo 先由软件原点和当前新鲜位置计算差值，再生成一次相对实际位置命令，不依赖上一次输入目标。
- 只在轴已停稳、无待发动作且参考有效时计算差值。记录发送后的 MotorBus 实际量化目标；动作结束按最终软件绝对目标复核，不能只靠较早的反馈计算值判成功。
- 单位换算集中实现：电机圈数＝机构单位位移/每电机圈机构位移，命令脉冲＝圈数×该轴 pulses_per_rev；命令速度也按同一机械系数换算 RPM。保留 64 位中间值并检查协议范围。
- 不向电机发送零脉冲的假动作；量化后为零时，仅在新鲜位置已落入容差、轴已静止时返回完成，否则提示分辨率不足。

### 5.2 上电顺序

```text
限位输入就绪、配置检查、两轴反馈健康且静止
       ↓
6号使能确认 → 6号顶部回零 → 顶部释放后的停放位置
       ↓
5号使能确认 → 5号收拢回零 → 收拢释放后的停放位置
       ↓
两轴 HOMED；7号如在线则使能并建立 SESSION_REFERENCE
       ↓
等待屏幕验收或后续业务调用，不自动展开或循环试动作
```

5/6 是本次自动回零必需节点；缺少任意一个则准备失败，不跳过。7 缺席不否定已完成的两轴回零，但机构三轴验收不可启动，显示 `TRIM NOT READY`。四轮可未连接，本阶段回零不依赖光流和 gyro。

上电自动回零每次 MCU 启动只发起一次；若失败或用户 STOP，不因后续反馈恢复自动再来一遍。屏幕显式 HOME 可在停车确认及条件恢复后重新发起整套回零。

### 5.3 每轴回零子状态

| 步骤 | 动作与推进条件 |
|---|---|
| CHECK | 配置/反馈/静止/使能确认，采集稳定开关电平；参考标志先清为 UNHOMED |
| INITIAL_RELEASE | 若上电已触发，向远离限位方向作有界扫寻；稳定释放后请求停车并等确认；仍不释放则失败 |
| FAST_SEEK | 向限位方向发有界位置扫寻；原始触发即 STOP，待稳定触发＋停车确认；距离用尽或超时而未触发则失败 |
| BACKOFF | 按配置退让距离向外移动，到位、零速、开关稳定释放后进入下一步；不能只等固定时间当已退开 |
| SLOW_SEEK | 更低速度重新向限位扫寻；原始触发即 STOP，稳定触发＋停车确认后读取新的位置反馈，保存接近点证据 |
| PARK_RELEASE | 从已确认接近点向外移动 home_clearance；到位、停稳且开关稳定释放后，以最终新鲜位置建立软件零点 |
| HOMED | 本轴回零成功；允许 HomeAll 推进下一轴 |

每一段都单独配置最大运动量和超时。计划编写时的历史候选初值为寻零速度 5 RPM、二次接近/退离 2 RPM（非当前配置）、驱动加速度字段 100；它们是低速调试候选，必须根据本车传动和停车余量确认。不能在传动比未知时把这几个 RPM 直接解释成安全的 °/s 或 mm/s。

不做“超时后自动交换方向”或自动扩大搜索范围。断线表现为持续触发时，只允许有界的 INITIAL_RELEASE，随后报告不能释放；方向配置错误必须由人工核对。

### 5.4 停车、到位和有效性

- ACK 仅说明命令接受。普通位置动作同时要求位置误差在容差内、零速、新鲜健康状态和到位标志；机构层还核对请求号，避免消费上一动作的 COMPLETE。
- 被限位中止的扫寻不要求原位置目标完成，而等待既有 STOP 确认及限位稳定状态，再推进下一步骤。
- 建零位置必须是在相关停车/最终退让之后新读取的位置，不能用旧位置、触发前缓存或 ACK 推定原点。
- 停止不自动失能，尤其 6 号维持使能保持。保持力矩不是机械抱闸，实物负载保持需单独验收。
- 中途故障终止当前序列并停正在运行/待运行的相关轴；不要为了一个未连接的 7 号创建永远无法确认的自动 STOP。全局 STOP 按用户原有按钮语义仍停止全部七轴。
- 通信/驱动异常、反馈断续或参考不可信时使相关坐标参考失效；5/6 需重新回零，7 需在停车后重新建立本次基准。普通明确取消且反馈持续可信，可保留已有参考，但动作结果仍是 CANCELLED，不推进下一段。
- 停车超过现有 3 s 阈值保留 `STOP UNCONFIRMED` 与重试，不自动解锁。机制层不设置“等几秒就算停了”的旁路。

## 6. 限位保护、机械顺序与控制权

### 6.1 5/6 的单端开关不能代表两端都受保护

回零后两轴均以远离开关的方向为正。正常动作使用配置的 `0..max_position` 软件范围；对远端没有硬开关的事实如实标注。用户“不考虑边界”的要求只用于 7 号，不能扩展到 5/6。

向归零端运动时检测到原始限位触发，或正常停放阶段无预期地出现触发，立即停相关运动并锁定 LIMIT 故障；不会当作普通位置完成。只有明确的回零退离步骤允许从已触发状态向外离开。

5/6 的软件最大范围、回零扫寻上限、退让距离、正负方向是必须实测的配置。未知置无效，显示缺项；不能用“旋出约 90°”推定旋转臂的总机械行程，也不能把电机已有的 32 脉冲模板当作机构距离。

### 6.2 本阶段固定机械联锁

- 旋转前，6 号必须已回零、位于顶部停放窗口且零速；启动旋转后禁止其他机构轴插入动作。
- 正常向下移动前，5 号必须在已确认的车外工作角附近且静止；上电 6 号寻顶部是用户确认可行的特殊准备路径，不要求先知道 5 号角度。
- 7 号不参与自动回零，不增加其位置边界；其动作仍受单动作互斥和总线健康约束。
- 机构上电回零/验收运行期间，拒绝底盘 START 和运动入口，不让车体与机械臂两套验收同时运动。若已知四轮正在运动，先停车并确认，再开始回零；从未出现且未命令的四轮不阻塞独立机构台架。
- 底盘运动期间拒绝机构验收启动。最终比赛需要机构与底盘协同的动作，另由任务层明确组合，本阶段不解除这个验收互斥。
- 5～7 的手动动作不得绕过机构服务：现有 MOTOR 页的 RUN 在机构拥有控制权时拒绝；后续接入时将这些轴的手动位置/点动统一经机构检查。不能只禁新页面而保留旧入口直接向限位方向运行。
- 全局 STOP、退出 MANUAL 等原有会停车的入口，先取消机构和底盘的生产者意图，再调用 MotorBus_Stop，防止下一轮又发新动作。

## 7. 参数与调试放行

计划使用每轴独立配置，不继续复用全局 `MOTOR_TEST_PULSES_PER_REV=0` 作为实际机构参数。

| 配置组 | 必填内容 |
|---|---|
| 电机配置 | 每轴 pulses_per_rev、使能/反馈模式、正向协议符号、允许 RPM/加速度字段 |
| 机械换算 | 5 号每电机圈对应臂角度；6/7 每电机圈对应毫米；方向和测量证据 |
| 限位 | 5=PG2、6=PG3、NC 高有效；采样/去抖及原始触发处理固定采用本文件方案 |
| 回零 | 各轴扫寻上限、初始退离上限、快/慢速度、BACKOFF 与最终 home_clearance、步骤超时 |
| 正常位置 | 5/6 最大正向行程、位置容差、顶部窗口、车外工作角及角度窗口；7 没有 min/max 行程项 |
| 验收 | 车外工作角约 90°；下降 5 mm；微调 ±5 mm；各段速度和超时 |
| 放行标志 | 开关接线已核对、方向/换算已核对、回零余量/姿态已核对；默认均未确认 |

缺参数时仍初始化 GPIO、屏幕和通信，显示 `CONFIG REQUIRED`，不执行自动回零。实际参数确认并启用放行后，正常固件才执行用户要求的上电自动回零；不是将猜测的行程写成默认值就开始动作。

初始软件位置容差建议 5 号 1°、6/7 号 0.5 mm，并确保换算后不小于一个指令脉冲分辨率；若底层现有计数容差更宽，机构层不能只检查其 COMPLETE，需独立进行物理单位复核。软件阈值属于调试初值，精度最终以外部测量为准。

每段超时由配置速度和运动上限计算并留余量，限在现有位置动作可接受的 100～60000 ms；不可表示的动作直接拒绝，不无提示截断脉冲数。超时处理是停车和失败，不隐式重发同一位移动作。

## 8. 屏幕最终运行效果与验收

### 8.1 用户看到的流程

参数尚未确认：上电显示两限位实时状态、各轴在线/使能/位置和配置缺项，无机构运动。

参数完整的正式验收构建：上电自动执行两轴回零，屏幕显示 `LIFT HOMING → ARM HOMING → HOME READY`；7 号在线并建立基准后显示 `TRIM SESSION ZERO`。不开启底盘自动运动，也不立即展开机械臂。

在 MOTOR 的机构轴详情增加 `MECH` 入口，机构页保留 HOME、TEST、STOP、BACK 和各轴选择/详情；沿用 ASCII 字体与分步绘图。首页显示 5/6/7 的参考质量、当前位置、限位状态和当前步骤；详情显示原始计数、目标、反馈年龄、失败原因及 STOP 是否确认。

TEST 只在两轴 HOMED、7 号 SESSION_REFERENCE、三轴健康/静止和配置完整时接受。反复按下不重启正在执行的序列；HOME 也不抢占活动动作。切页不暂停服务。

### 8.2 一轮验收序列

所有目标相对既定软件零点，段间停稳后等待 500 ms；每次点击只运行一轮。

1. 核查上下臂在顶部停放位置、旋转臂在收拢位置；不满足则拒绝 TEST，先 HOME。
2. 5 号从 0° 到配置的车外工作角（约 +90°），完成后保持。
3. 6 号到 +5 mm，再回 0 mm。
4. 7 号从本轮开始位置前进 +5 mm，再回本轮开始位置；后退 -5 mm，再回本轮开始位置。此处不重新定义 SESSION 零点。
5. 确认 6 号仍在顶部停放位置、7 号已完成回位后，5 号回 0°。
6. 完成显示 DONE；任何阶段异常显示 FAILED＋具体原因，停止且不自动继续。用户 STOP 显示 CANCELLED。

验收时不推动 7 号找开关、不判断其机械边界。整个过程中通信、扫码、光流/gyro 诊断和屏幕持续工作；机构动作本身不依赖光流正常。

### 8.3 软件验证

- GPIO 模拟：NC 释放/触发/断线/对地短路；上电按住、接点抖动、采样时间回绕、超长采样间隙；验证原始触发先停车，稳定状态再推进。
- 回零替身：6→5 顺序；已压住先退离；快寻、退让、慢寻、最终释放完整证据；找不到/退不掉/停不住；距离用尽但没有触发；错误方向不自动互换。
- 与真实 MotorBus 联合测试：查询忙、延迟 ACK、STOP 首帧丢失、反馈过期、位置未刷新、使能失败、堵转/保护；不能用“发命令即完成”的空桩验证回零。
- 坐标换算：不同脉冲/传动系数、正负方向、目标舍入、MoveTo 与相对移动、零位偏移、协议范围溢出、NaN/Inf；5/6 软件范围检查和 7 无边界限制分别验证。
- 联锁：顶部未确认禁止旋转；未在车外禁止正常下降；机构/底盘两种验收互斥；手动入口不能绕过；退出手动和全局 STOP 清除生产者意图。
- UI/并行：上电回零期间切页、持续扫码、重复 HOME/TEST、故障锁存、停止未确认显示，沿用耗时绘图替身检查主循环/gyro 时序。
- 完整运行当前主机测试与 Keil 构建；新接口兼容 AC5，检查新增状态对象和栈的占用。

### 8.4 实机验证

1. 先不使能电机，逐个按开关，确认屏幕 PG2/PG3 与物理开关对应；释放低、按下高；拔开回路为高，不误记另一轴。
2. 核对三轴方向、每圈位移、pulses_per_rev 与 6 号负载保持；先低速单轴验证停距，确定开关触发行程和退让量。
3. 分别在未压开关、上电已压开关两种状态执行回零；至少三次，记录软件停放零点的外部重复性。初轮目标：旋转零位重复性 ≤1°，升降 ≤0.5 mm；未达到时如实记录并调整机械/速度，不通过扩大显示容差伪装通过。
4. 连续三轮 TEST，外部量具核对车外角度、5 mm 行程与回位；初轮目标为旋转终点误差 ≤2°、直线端点误差 ≤1 mm。记录载荷和失败样本，不只看屏幕的电机估计值。
5. 受控验证中途 STOP、触发限位、连接异常和恢复；确认不会跳到下一步，升降不被软件自动失能，停车未确认不会被清掉。

## 9. 计划编写时的验证结果与交接（历史）

在合并后的 main 上执行 `Scripts/test.ps1`：**全部通过**，包含底盘、七电机总线、UART、扫码、光流、gyro 及 UI 并行替身。这仅验证已合入的软件基线，不表示本计划中的机构模块已经开发或实机验收。

执行 `Scripts/build.ps1`：**未能完成构建**。Keil 在创建 ARMCC/ArmLink 进程时失败；单独运行已存在的 `armcc.exe --vsn`、`armlink.exe --vsn` 同样报 Windows“无效的系统 DLL 重定位”。目前证据指向编译器进程启动环境问题，不是编译器给出的 C 源码错误；本次未修改系统 DLL 或工具链，不记录为构建通过。

物理参数尚待测量：三轴每圈位移/角度、方向、pulses_per_rev、5/6 搜索距离和退让量、远端软件范围、车外工作角及停距。开关数量、位置、NC 接法、引脚、回零顺序、验收顺序和微调轴不处理边界已确定，不重复询问。

原计划实施顺序：**限位输入与显示 → 配置/单位换算 → 单轴有界回零 → 6→5 上电编排及 7 号会话基准 → 非阻塞位置 API 与联锁 → 屏幕验收 → 联合故障测试 → 参数实测与实机验收**。现按用户最新指示在 `codex/chassis-motor-odometry` 实施软件部分，未合入 main、未引入其他分支提交；参数实测与实机验收仍待完成。保留原 MotorBus 停止策略与其他模块。

### 核查来源

- [V1 核心板原理图已提取文本](../../迁移分析/evidence/yh_v1_core.txt)、[第 1 页排针图](../../迁移分析/evidence/yh_page1.png)、[第 2 页 MCU 图](../../迁移分析/evidence/yh_page2.png)。原 PDF 位于本机野火资料目录 `F429_F767_挑战者_V1/原理图/F429_767_挑战者V1核心板-原理图.pdf`。
- [既有 V1 迁移核对](../../outputs/野火F429挑战者V1核心板_迁移核对.md)中的 PG2/PG3 仅作历史交叉核对；本次已重新核查当前运行代码占用。
- 当前 `motor_bus.*`、`emm_protocol.*`、`qr_app.*`、LCD/SDRAM/BSP 配置是软件依据。
- 本地一点创绘 `APP/car_init/car_init.c` 的退离—再接近状态机仅作设计参考；不沿用其旧轴号、PD14/PD15、固定延时停车、直接串口发送或自动猜方向逻辑。
