dadatiaoao/-1021ccc/Doc/MECHANISM_TRIAL_2026-10-24.md

# 机构临时试运行固件

> **历史文档，不再作为当前参数、7 轴行为或当前构建产物的参考。** 2026-10-26 更新：5/6 快慢回零为 24/6、60/12 RPM，5 首次搜索 360°；7 为单头 1 mm 螺距直联、总行程 50 mm、正向伸出，当前为原生碰撞回零配合主控无进展寻端，确认停车后缩回中点；用户已确认 7 轴回零功能实测完成，已移除临时电流采样显示。本轮自动归中衔接改动待烧录复核。当前事实、参数、流程及待验项目统一见[机构标定记录](MECHANISM_CALIBRATION_TODO_2026-10-25.md)与 [mechanism_config.h](../User/mechanism/mechanism_config.h)。以下保留当时方案和验证历史，旧会话零点及“无边界”约定已被替代。2026-10-26 用户进一步实机确认：**全部 1～7 号电机均为 3200 指令脉冲/电机圈，6 号同步轮 20 齿、同步带齿距 2 mm，对应 40 mm/电机圈**。下文相关“假设/待核对”仅保留为确认前的历史状态，不再是当前待办。

2026-10-24，按用户“先填值、直接编译烧录试跑”的要求启用。本说明覆盖原交付中“当前默认未标定、不运动”的描述；原门控逻辑保留在 `MECHANISM_TRIAL_RUN=0` 模式。**本版本为 TRIAL，不是完成标定的正式固件。**

**参数依据：以 [mechanism_config.h](../User/mechanism/mechanism_config.h) 的当前配置及注释为准。全部 1～7 号电机 3200 指令脉冲/圈、6 号 20 齿 × 2 mm＝40 mm/电机圈已于 2026-10-26 实机确认；六次计数与粗测行程保留为历史依据，实际定位误差及底部余量仍待验证。以下为确认前试运行记录。**

## 2026-10-25 实测反馈、升降换算与临时功能清理

5 号由同步轮 1:3 减速驱动，电机一圈对应机械臂 120°；回零姿态与车侧平行，抓放姿态与车侧垂直，工作目标保持 90°。6 号由同步带直接驱动、无减速，向顶部回零。用户已确认两轴回零方向正确，符号保持 +1。按最新要求再次将回零快寻/慢寻及退离速度翻倍：5 号 8/4 RPM，6 号 20/8 RPM；对应 max_rpm 分别为 8、20.1。6 号 20.1 仅为允许 20 RPM 换算的浮点误差，整数 21 RPM 仍被拒绝。正常旋转臂速度仍为 6°/s，升降普通动作速度改为 10 mm/s。

用户将原 150 mm 行程估计更正为约 **165 mm**，并反馈六次底部至顶部停稳计数：

| 次数 | 反馈计数 |
|---|---:|
| 1 | 264919 |
| 2 | 264816 |
| 3 | 264799 |
| 4 | 264918 |
| 5 | 264798 |
| 6 | 264880 |

- 平均值：**264855 counts**，对应 **4.041366577 电机圈**。
- 历史粗测估算：`165 × 65536 / 264855 = 40.8277736875 mm/圈`；该公式已不用于当前配置。
- 当前采用值：按用户指定的 **20 齿 × 2 mm 齿距 = 40 mm/电机圈**。若最终确认为 20 齿 MXL、齿距 2.032 mm，理论值为 40.64 mm/圈；目前未确认，也未采用。
- 最大与最小计数相差 121 counts，按当前 40 mm/圈换算，等效约 0.07385 mm；这是六次重复测量的极差，不代表绝对定位精度。长度尺度仍需核对齿距、底部重复位置及顶部停车端点。
- 本次测量依据每电机圈 65536 反馈计数，未使用 3200 指令脉冲/圈假设；指令脉冲配置仍需另行核对。

按用户要求彻底删除临时采数页面、按钮、启动宏、采数接口/状态/快照字段、专用速度续期 API 与测试。上电恢复“运行总览”及原自动 6→5 HOME、7 会话零点。原采数操作文档删除，原始测量数据保存在本节。

升降软件范围仍为 **0..160 mm**，顶部停车后再退离 4 mm 建立软件零点。按当前 40 mm/圈，平均 264855 counts 对应约 161.655 mm，与粗测约 165 mm 不同，因此真实底部剩余行程未经验证，不能宣称 160 mm 终点还剩约 1 mm。首次搜索上限设为 **170 mm**，按配置覆盖标称范围并由限位提前 STOP。初始已压开关时最多退离 8 mm；触发后退让 4 mm、慢寻上限 10 mm、最终释放退离 4 mm。旋转臂首次搜索改为 100°，覆盖 0..90° 位置范围；初始退离 6°、触发后退让 4°、慢寻 10°、最终退离 4°。

升降正常动作速度为 10 mm/s，协议量化为 15 RPM（10 mm/s）；20/8 RPM 回零分别约为 13.33333/5.33333 mm/s。170 mm 快寻与 160 mm 普通动作的位置超时参数分别约为 39.25 秒和 49 秒，机构另留 1 秒排队时间，均能通过现有 60 秒位置动作时限。这些是超时参数，不是运动耗时；对应匀速运动时间约为 12.75 秒和 16 秒。此前参数调整仅涉及配置、测试中的预期 RPM 和对应说明，未改变回零、位置换算、联锁或停车逻辑。软件零点仍在最终释放退离后建立。

## 当前入口与烧录

直接编译 `Project/YH-F429.uvprojx` 的 LCD 目标即可，或执行 `Scripts/build.ps1 -Rebuild`。默认 `User/mechanism/mechanism_config.h` 中 `MECHANISM_TRIAL_RUN=1`，无需再手动开启确认标志。

上电进入“运行总览”并显示 TRIAL 标记。5/6 反馈就绪后自动按 **6 号顶部回零 → 5 号收拢回零 → 在线的 7 号建立会话零点** 执行一轮；7 不找限位、不作找零运动。两轴回零后保持静止，通过“机械臂 → MORE → 机构验收”启动 TEST 才执行旋转到 90°、升降 0→+5→0 mm、微调前后各 5 mm 并回位、旋转收拢的一轮八段序列。底盘不会自动跑。

5/6 任一离线或反馈异常仍会拒绝/中止；7 缺席不影响两轴回零，但三轴 TEST 不会启动。失败或 STOP 后不自动再来一轮，恢复条件后显式点 HOME。全局 STOP、限位原始触发、去抖、反馈、位置动作时限和停车持续确认/重试均保留。

## 试填参数与真实参数的区别

| 参数 | 5 号旋转臂 | 6 号同步带升降 | 7 号微调 |
|---|---|---|---|
| 机构单位/电机圈 | 120°，按电机 3 圈/臂 1 圈 | **40 mm，按 20 齿 × 2 mm 齿距假设** | **假设 2 mm** |
| 每电机圈指令脉冲 | **假设 3200** | **假设 3200** | **假设 3200** |
| 协议正方向符号 | +1 为向外，回零方向已实测 | +1 为向下，回零方向已实测 | **假设 +1 为伸出** |
| 正常运动速度 | 6°/s，即 3 RPM | 10 mm/s，量化为 15 RPM（10 mm/s） | 0.5 mm/s，即 15 RPM |
| 暂用软件位置范围 | 0..90° | 0..160 mm | **不设机械边界** |
| 最大转速参数 | 8 RPM | 20.1 RPM（整数上限仍为 20 RPM） | 15 RPM |
| 暂用到位误差 | 1° | 0.05 mm | 0.05 mm |

6 号已确认同步带直驱，全行程粗测约 165 mm；当前 40 mm/圈来自 20 齿 × 2 mm 齿距假设，真实行程及底部余量仍需核验。7 号传动换算仍未测。`calibrated/wiring_confirmed/home_confirmed=1` 仍包含原试运行放行，不能扩展为所有轴、指令脉冲或机械停距均已验收。界面保留 TRIAL 标记。

| 回零子步骤（机构角度/毫米；RPM 为电机转速） | 5 号 | 6 号 |
|---|---|---|
| 初始已压开关时最大退离 | 6° | 8 mm |
| 第一次搜索上限/速度 | **100° / 8 RPM** | **170 mm / 20 RPM** |
| 第一次触发后退让 | 4° | 4 mm |
| 二次搜索上限/速度 | 10° / 4 RPM | 10 mm / 8 RPM |
| 最终释放退让 | 4° | 4 mm |
| 初始退离、退让、最终释放的速度 | 4 RPM | 8 RPM |

首次搜索范围按当前配置覆盖标称行程，实际机械边界和停距仍需核验；超过上述搜索上限没有触发仍会报 `LIMIT NOT FOUND`，不会自动扩大距离。这里的角度指最终机械臂角度，例如 100° 搜索对应 1:3 减速前电机约 300°；毫米和速度按当前换算配置计算，指令脉冲/圈仍为假设；实物每圈位移或电机脉冲设置不一致时，真实距离会不同。5/6 当前方向已实测正确，保持原符号；程序不会自动反转猜方向。

接线固定为 5=PG2/J7-41、6=PG3/J7-43，COM 接 GND，NC 接上拉输入，NO 不接；释放应为低，触发/回路断开为高。GPIO 停车依赖串口链路，不是驱动端硬件急停。

补齐实际指令脉冲/圈、7 号每圈位移及方向、回零余量、姿态误差及停距后再记录完整标定值。将 `MECHANISM_TRIAL_RUN` 改为 0 会恢复原来的未标定门控配置，需要按正式测量结果填写并放行。

## 已有软件验证记录（历史，不表示本轮文档修订重新运行）

此前使用 Clang C11、`-Wall -Wextra -Werror` 编译并运行的主机测试记录如下：

- 未标定配置在默认/严格 MotorBus 门控下各通过 6314 项检查。
- 早期采用 40.8278 mm/圈时的 TRIAL 配置（历史参数，已由当前 40 mm/圈替代）在默认/严格门控下均完成 6→5 回零、7 会话零点及八段 TEST；逐段检查串口 MOVE 帧中的 RPM。
- 前次应用 TRIAL 上电自动回零、重复 HOME 拒绝及 STOP 取消测试通过；启动测试改为观察 MOVE 开始，避免沿用旧换算下的固定等待时间。
- 普通应用页面、动作、调度及 18 个页面变体渲染检查通过；临时采数符号和操作文档引用已清除。
- 前次参数调整后的历史验证：默认/严格两组机构回归和实际 TRIAL 参数的八段 TEST 均通过；临时模拟用旋转臂 90°、升降 165 mm 起点验证全范围回零，并验证升降 0→160→0 mm 能通过现有动作时限。仅测试临时输入数据变化，未引入新运动逻辑。

以上为此前模拟验证记录；本轮仅修正文档和注释，未重新运行测试或 Windows Keil/AC5 构建，未生成新的 HEX，也未烧录。用户本次提供的是临时固件的整段采数结果，不能扩展为当前位置动作及双次回零精度已验收。

## 历史软件验证（e93a755，不代表当前源码的构建产物）

原未标定模式的完整回归仍单独编译 `MECHANISM_TRIAL_RUN=0`；另编译实际发货的 TRIAL=1 配置，使用真实 MotorBus 和机械替身验证自动 6→5 回零、7 会话零点和全部八段 TEST。应用联合替身还验证上电直接进入试运行页面、自动发出升降动作、重复 HOME 不覆盖请求、STOP 取消且不自动重试。合成测试不能证明这些假设与实物一致。

试运行应用测试发现并修复了启动准备阶段的问题：车轮反馈字段逐个到达时，等待新鲜速度/状态确认静止；不再把尚未读到的位置当成正在运动并反复 STOP。已知运动的车轮仍先停车确认。

完整日志：`Output/mechanism-trial-full-tests.log`；Keil 日志：`Output/build.log`。最终结果如下；本轮没有连接下载器烧录，也没有实机运动结果。

- 全量主机回归通过；未标定模式默认/严格两组各 6319 项通过。实际 TRIAL=1 参数的完整回零/八段序列与应用自动启动/STOP 用例均通过。
- Keil LCD / AC5 全量构建：0 错误、0 警告；Code/RO/RW/ZI=86168/19196/1708/18716 字节。
- 历史烧录文件（不包含本次调速）：`Output/YH-F429-mechanism-trial-20261024.hex`；与当时构建的 `Output/YH-F429.hex` 内容一致。
- HEX SHA256：`559F2CE1DA0DA4DE8554E8353A8E9B448508713B5CC95554D38D7EF4ACDA7C71`。
