dadatiaoao/-1021ccc/Doc/MULTI_MOTOR.md

# 【已过时，仅供参考】七电机通信：实现、使用及验证记录

> **已过时，仅供参考；当前状态、需求、配置和验收结论以 [工程 README](E:/工创赛/迁移野火板/README.md) 为准。**
> 2026-10-26 用户进一步实机确认：**全部 1～7 号电机均为 3200 指令脉冲/电机圈，6 号同步轮 20 齿、同步带齿距 2 mm，对应 40 mm/电机圈**。下文相关“假设/待核对”仅保留为确认前的历史状态，不再是当前待办。 当前记录见[机构标定记录](MECHANISM_CALIBRATION_TODO_2026-10-25.md)。
> 归档标记：2026-10-22。以下保留原阶段目标、交付与验证记录，不代表当前仍待执行、未完成或已经实物验收；正文及嵌套文档中的旧交接指令不再直接执行。与 README 冲突时，以 README 为准。历史版本的测试证据及引用资料仅用于追溯。

2026-10-22 更新：UART5 接收隔离/假成功检查、持续停止意图及限频重试、分步 UI 和校准门控已实施。验证与实板待验见 [实施报告](GYRO_MOTOR_FIX_REPORT_2026-10-22.md)；下列旧阶段尺寸/检查数保留作历史记录。

## 上电顺序测试增补（2026-10-21）

按用户后续要求，仅新增一次性启动过程，取代本文件下文原有“上电全程只读”的默认行为：等 1～4 号反馈正常且零速，依次使能并用状态读回确认；随后方向 0、10 RPM、加速度 100，约每 1 秒启动下一台（1→2→3→4），全部启动后再间隔约 1 秒依次停止（1→2→3→4）。停止需要新零速/无故障反馈，完成后恢复只读；不会失能，5～7 号不发控制指令。扫码/PB12/会话/触摸/UI 与总线协议未改，旧 MotorDemo 仍不运行。

每次上电/复位只执行一次。点 STOP 或其它手动控制会中止本过程，通信/使能/速度异常会请求四轮停车，不会恢复后重试。初始反馈等待最多 10 秒，缺台则中止；各阶段有超时，速度保留 5 秒总线有效期兜底。过程复用现有控制使能态，电机页显示现有 MANUAL 标题和 `BOOT 1-4 ...` 提示；结束显示 `BOOT 1-4 DONE / READ ONLY`。扫码、RESCAN 和普通切页不影响测试过程。

下载 `Output/YH-F429.hex` 后重新上电或复位即可观察。默认开启，不需要打开原手动运动配置；`User/motor/motor_test_config.h` 中 `MOTOR_BOOT_SEQUENCE_ENABLED=0` 可关闭，`MOTOR_BOOT_RPM` / `MOTOR_BOOT_STEP_MS` 为本过程速度和间隔（默认 10 / 1000）。本次主机新增 1893 项循环检查通过，模拟启动时刻为 1354/2355/3356/4357 ms，停止命令时刻为 5358/6359/7360/8361 ms；实际时刻取决于初始化与反馈，不保证上述绝对时间。原回归在关闭新过程的配置下保留并通过，另以当前默认配置验证了新过程、STOP、缺台、使能拒绝、速度 ACK 丢失及扫码并行。实物运动尚待用户验证。

最小改动：`qr_app.c/.h` 增加小状态机及其计时字段，复用 MotorBus；`motor_test_config.h` 增加三个启动过程宏；`main.c` 只更新入口注释；`test_qr.c` / `test.ps1` 增加本过程模拟并保留旧回归。README 和本文仅补充当前行为，下面的七机阶段验证/内存数据保留为之前交付记录。

本次当前默认配置 Keil AC5 完整重编译为 0 错误、0 警告；Code=43020、RO-data=16792、RW-data=1580、ZI-data=13340 字节，已重新生成 `Output/YH-F429.hex` / `.axf`，未烧录。

## 门控放宽（2026-10-21）

在保持反馈/使能/故障/停车门槛不变的前提下，按用户要求谨慎放宽三处“启动类”门控。三项均可在 `User/motor/motor_test_config.h` 用宏单独恢复旧行为，并各有对应测试构建：

1. **驱动层不再强制 MANUAL 会话**：`MotorBus_Enable/Submit/Wheels/Sync` 只要求节点在线、反馈新鲜、已使能且无故障，不再要求先 `MotorBus_SetManual(1)`。UI 的 READ ONLY/MANUAL 语义与“退出 MANUAL 全停”不变；最终流程的任务状态机可直接调用 API，但须自行保证“显式意图/安全策略”。恢复旧行为：`MOTOR_DRIVER_REQUIRE_MANUAL=1`。
2. **UNKNOWN 自动恢复**：节点进入 UNKNOWN 后，一旦收到新的（UNKNOWN 之后采样）、在线且新鲜的速度/状态反馈，速度=0、无堵转/保护位、隔离窗与稳定窗（默认 500 ms）已过，则恢复为 `STOPPED`（已使能）或 `IDLE`（未使能），不再必须人工再点 STOP；仍在转、有故障或无反馈时继续拦截新动作，不自愈、不重放。恢复旧行为：`MOTOR_UNKNOWN_AUTO_RECOVER_MS=0`。
3. **未配置构建允许单轴点动**：`MOTOR_TEST_CONFIGURED=0` 时，UI MANUAL 下的 SPEED 动作可提交（沿用 10 RPM / acc 100 / 1 s 模板）；POSITION、WHEELS 0xAA、SYNC 仍拒绝并提示 CONFIGURE。恢复旧行为：`MOTOR_BENCH_JOG_ENABLED=0`。

仍保持的硬门控：运动必须有新鲜、在线、已使能、无故障反馈；停止永远允许并优先；`STOPPED` 仍要求停止发送后的新零速/无故障；不重放旧动作；位置模式 00 仍需已知上一目标；同步默认锁定；四轮任一故障仍整组停车。协议帧、地址/功能码回包判定和 60 ms 应答窗口未改。

日期：2026-10-21。基于 `b493bcc`，开始时工作区干净；未覆盖既有未提交修改。当前完成软件实现、主机替身测试和 Keil AC5 编译，**未烧录，七台电机、接线、真实运动、屏幕及并发时序均待实物验证**。用户此前报告的扫码完成不作为本版实物验收记录。

交付复核发现 Git HEAD 被外部操作回退为 `164e74e`（reflog 中有 amend/reset）。开始时已有的任务书增补、`Scripts/build.ps1` 零警告规则、`User/touch/gt9xx.c` 警告修复、扫码任务书更新因此重新显示为未提交；本任务均保留，未重置、覆盖或提交 Git 历史。下文“本次改动”以开始时 `b493bcc` 的文件内容为比较基线。

## 1. 最终运行效果与操作

当前交付固件为 `Output/YH-F429.hex` / `.axf`，目标 `LCD`。上电进入原扫码页，同时启动七地址轮询。默认不使能、不发送运动指令，不执行原自动演示。

| 操作场景 | 已实现的屏幕/程序效果；实物运行时的预期 | 验证依据与边界 |
|---|---|---|
| 上电、复位 | QR 页 `WAIT CODE / --`；七机后台读取。未接齐也继续运行，不以零值冒充反馈 | 主机启动检查通过；实物待验证 |
| 点 MOTOR | 七行 `1 FL / 2 FR / 3 RL / 4 RR / 5 ARM / 6 LIFT / 7 TRIM`；显示 ON、WAIT、OFF 或 STALE、实际 RPM 和状态字 | 七节点模拟及 480×272 字体替身检查通过；非实机截图 |
| 点某一行 | 节点详情：动作状态、P 实际编码器计数、T 本次目标计数、速度、状态、错误、最后结果及各字段年龄 | 无数据为 `--`，过期位置带 STALE；主机检查通过 |
| 扫码、RESCAN、MOTOR/QR 切页 | 保持锁定/去重/重扫；PB12 周期触发，USART3 与七机调度并行；这些操作不提交运动 | 保留原扫码回归并增加七机集成检查；实物吞吐/波形待验证 |
| 单轴 SPEED | UI 仍以 MANUAL + RUN ONCE 为显式意图（驱动层 API 不再强制 manual）；仅选中地址接收一次速度命令；有效期结束请求停车。`MOTOR_TEST_CONFIGURED=0` 时该单轴点动也可用；位置/四轮/同步仍需启用参数 | 模拟及启用参数的应用测试通过；点动路径与配置拒绝分支均有主机检查；实际方向/速度待验证 |
| WHEELS 0xAA | 一次 37 字节包给 1～4 下发四个不同速度，5～7 不随此动作运行；地址 1 ACK 后分别读取四轮反馈 | 字节黄金值、地址 1 缺失、ACK 丢失、10 Hz 提交模拟通过；实物待验证 |
| 机构 POSITION | 选择 5/6/7，触发一次有限脉冲位置动作；长按不重复提交。目标/新鲜实际位置/速度/到位位共同判断完成 | 三位置模式、零位移、不达目标及 ACK 丢失模拟通过；机械行程和每圈脉冲数待核对 |
| SYNC WHEELS | 逐台缓存并等待接收确认，全成功才广播触发；失败进入 `SYNC CACHE UNKNOWN / LOCKED`，不自动重试/切换 0xAA | 成功、拒绝、超时、取消的状态机模拟通过；默认同步锁定，实物缓存边界待验证 |
| STOP | 任意页面底部 STOP 为全体停止；详情页还可单轴/底盘停止。取消相关待发动作，等当前 DMA 帧结束后优先发停止，再读速度/状态 | 满队列、查询/同步中抢占、ACK 缺失、拒不停模拟通过；实机响应时延待验证 |
| 掉线与恢复 | 受影响节点 OFF/STALE；其它节点、扫码继续。自本程序发起的运动中，某轮查询超时/故障会请求四轮停止；恢复后只读，不重放旧动作 | 单节点掉线、地址 1 缺失、恢复及无旧动作重放模拟通过；拔线测试待做 |

### 可照着操作的步骤

1. **逐台确认再接总线。** 在电机本身/厂家工具中核对 Emm 固件、唯一地址 1～7、115200/8N1、固定 `6B`、Response=`Receive`，关闭未安排的定时回传/到位通知。程序不改地址、不写持久参数、不恢复出厂、不升级固件。版本可通过 `MotorBus_ReadVersions(&app.motor)` 诊断读取，在调试器查看 `nodes[i].firmware/hardware/version_valid`。
2. **接线与上电。** UART5 PC12 TX → 电机 R/A/H；PD2 RX ← 电机 T/B/L，GND 共地。按 X42S 手册第 26 页 TTL 多机图和实际硬件版本接入七台，电机按其额定要求独立供电。USART3 PB10/PB11、PB12/TRIG 保持现有扫码接线。先逐台验证反馈，再接七台。下载当前固件，上电默认 QR 页，不自动运动。
3. **查看七机。** 点底部 MOTOR。`WAIT` 表示尚无匹配反馈，`OFF` 表示链路失效，`STALE` 表示部分反馈过期。RPM 或状态 `--` 不是零速/无故障的实测结论。点某行进入详情，`P/T` 单位为编码器计数（65536/圈），不是指令脉冲、毫米或机械角度。
4. **扫码并行。** 在 MOTOR 页持续扫码，点 QR 回看锁定任务；RESCAN 仍只开启新扫码会话。PB12 仍为 1000 ms 周期、800 ms 低电平；模组必须使用已核对的手动/电平触发模式。锁定后继续触发只累加 DUP/IGN。
5. **确认联调参数后重新构建。** 编辑 `User/motor/motor_test_config.h`。默认 `MOTOR_TEST_CONFIGURED=0`，位置/四轮/同步入口显示 `CONFIGURE motor_test_config.h`，但单轴 SPEED 点动在 `MOTOR_BENCH_JOG_ENABLED=1`（默认）时可用（10 RPM、1 s）。在脱开负载或已确认不会越程的条件下，确认方向、低速和行程后把 `MOTOR_TEST_CONFIGURED` 置 1；机构位置还必须把 `MOTOR_TEST_PULSES_PER_REV` 从 0 改为实际已核对值。不要把本次模拟使用的 3200 当成实物事实。修改后运行本文第 5 节的测试/构建命令，再下载。即使启用参数，上电仍只读。
6. **进入手动并使能。** MOTOR 页点底部左侧 MANUAL，标题变成 `MOTOR MANUAL`，左按钮变为 READ ONLY。点目标行，详情初始动作是 ENABLE；点 `RUN ONCE`，等待新状态反馈确认使能。使能 ACK 不等于已锁轴；详情状态字 bit0 才是读回使能。四轮联调前分别对 1～4 执行。程序不自动替你使能其它轴。该 MANUAL 门控是 UI 层语义；通过 API/任务状态机直接调用时不再需要它，但仍要满足新鲜、使能、无故障条件。
7. **单轴速度。** 在详情 `ACTION: ... [tap to cycle]` 这一行点击，选 SPEED，再点 RUN ONCE。模板为方向 0、10 RPM、加速度 100、1000 ms 有效期。只有该地址运行；有效期结束请求停止。CW/CCW 是电机方向，不代表车体前进/后退。单轴速度也受同一总线和故障处理管理。
8. **四轮速度。** ACTION 选 WHEELS 0xAA，再点 RUN ONCE。默认完整向量为 `{10,-12,14,-16}` RPM，可在 `MOTOR_TEST_WHEEL_RPM` 集中修改；正负只映射 CW/CCW，不猜安装方向。每次点一次提交一个完整向量，1000 ms 后停车。连续控制通过 API 最多先以 10 Hz 刷新，软件只保留尚未发送的最新完整向量。观察四个节点实际 RPM，`GROUP ACK1 / VERIFY EACH` 仅是地址 1 的接收确认。
9. **机构位置。** 先回 BACK，再选 5 ARM、6 LIFT 或 7 TRIM；ACTION 选 POSITION，点 RUN ONCE。模板是 10 RPM、32 脉冲、模式 02、8000 ms 完成超时。模式可配置为 00/01/02；00 必须已有本程序已知的上一输入目标，否则拒绝。长按不重复执行。`ACK ONLY`、`EXECUTING` 和 `COMPLETE` 分开显示；只有目标容差内且新速度为 0、新状态到位，才 COMPLETE。未做机械零点/限位，不宣称准确 50 mm 或机械绝对坐标。
10. **同步联调。** 默认 `MOTOR_SYNC_CLEAN_BOOT_CONFIRMED=0`，入口拒绝并显示 SYNC LOCKED。这是因为没有实物证据证明 Stop/Disable 会清除缓存。受控实测前必须对**全部电机重新上电**、确认无其它写总线端和残留缓存，再将此宏置 1 构建用于该次受控启动；MCU 单独复位不能证明缓存干净。使能四轮，ACTION 选 SYNC WHEELS 后 RUN ONCE。任何准备失败/取消/总线异常后保持锁定，没有 UI/API 运行时解锁入口；STOP 不解锁。不得只复位 MCU、保留电机供电后再次使用配置为 1 的固件来绕过锁定。当前清理规则仍待实测，日常交付配置始终为 0。
11. **停止。** 底部 STOP 在 QR、七机概览、详情页均可点，停止 1～7。详情页右侧 STOP AXIS 只停选中轴，左下 STOP WHEELS 停 1～4。退出 MANUAL 点 READ ONLY 也请求全停。程序不因普通停止失能升降轴；没有新反馈时显示 `STOP UNCONF`，超时为 `UNKNOWN`。`STOPPED` 必须有停止发送之后的新零速和无故障状态，不能只凭停止 ACK。停止结果不代表物理抱闸或断电负载保持能力。
12. **掉线恢复。** 联调中断开某台通信，确认其它节点/扫码仍更新并查看停止状态。恢复连接后等待探测和反馈（掉线探测间隔约 2 s），不会自动使能或继续运动。若节点处于 `UNKNOWN`，在收到其新的零速/无故障反馈并经过稳定窗后会自动恢复为 `STOPPED`/`IDLE`（`MOTOR_UNKNOWN_AUTO_RECOVER_MS=0` 可关闭），随后可显式 ENABLE/提交新动作；仍在转或有故障时 `UNKNOWN` 继续阻止新运动。同步缓存故障不会因通信恢复而解除。

触摸命中沿用原坐标：底部 y=232～263，左 x=8～151 切手动/只读或 RESCAN，中 x=160～239 全 STOP，右 x=248～471 QR/MOTOR。详情 ACTION 行 y=136～153；RUN/STOP AXIS 行 y=180～197（左/右半）；STOP WHEELS/BACK 行 y=202～219。一次手势只处理按下边沿，所有手指释放后才开始下一次手势。屏幕真实触点与这些坐标是否一致待实测。

## 2. 协议与官方对照

实际读取来源为资料根目录 `D:/BaiduNetdiskDownload/ZDT_XS系列第二代闭环步进电机资料`，未修改厂家原文件；解压副本在忽略目录 `Output/reference/`。重点读取 `9. 例程_STM32F407/HAL库/Emm固件模式/串口通讯` 中多电机命令、多机同步控制、速度、位置、使能、读实际速度/位置的 `Src/main.c`、`Src/Emm_V5.c` 和 `Inc/Emm_V5.h`。核对了 `3. 说明书/ZDT_X42S第二代闭环步进电机用户手册V1.0.5_260527.pdf` 的配置、接线、应答、运动和反馈章节。赛题只用作范围背景，本阶段不加入比赛流程。

| 项目 | 已落实规则 |
|---|---|
| 地址 | 1 前左、2 前右、3 后左、4 后右、5 旋转臂、6 上下、7 前后微调；EmmParser 总线模式只接受 1～7，输出带地址 |
| F6 | `addr F6 dir rpm_H rpm_L acc cached 6B`，保守使用手册 0～3000 RPM；例程部分注释的 5000 不用于新接口参数上限 |
| FD | `addr FD dir rpm_H rpm_L acc pulses[4] mode cached 6B`；00 相对上一输入目标，01 相对坐标零点，02 相对当前实际位置 |
| 四轮聚合 | `00 AA 00 25` + 四条完整 F6（地址固定 1、2、3、4，各含 6B）+ 外层 6B；总长 37 |
| 聚合应答 | 按地址 1 + F6 + 控制响应匹配；不等四个 ACK，不把一个 ACK 分配成四台完成；地址 1 缺失仍可能已有其它轮执行，超时停车而不重发 |
| 聚合边界 | 仅同类运动子命令，拒绝读取/混合/重复地址/越界；FD 聚合的最后标志必须为 0（不开到位通知），不能当作缓存标志。总线当前只公开四轮速度聚合，未开放任意位置聚合调度 |
| 传统同步 | 每条单播 cached=1，逐一 ACK；10 ms 最小间隔；全部准备后发 `00 FF 66 6B`，匹配地址 1 的 FF 应答；之后仍逐轴验证，不能由 FF ACK 宣称同时到位 |
| 返回语义 | 02 接收确认；9F 异步通知单独记录、不结束当前命令；12/22 为当前位置/限位条件下未运动的返回，在本阶段非回零动作中保留原码并拒绝；E2 条件/参数不满足，EE 格式错误 |
| 版本 | 1F 返回 7 字节，固件和硬件各为 16 位，按 X42S 新手册处理，不沿用旧版本 5 字节假设 |
| 容量 | EmmCommand 与 TX 持久缓冲 128 字节，长度类型 uint8_t（上界 128，传 HAL 时扩为 uint16_t）；每次追加/复制/发送检查边界。七条 FD 的 96 字节封装经主机检查 |

`Emm_Velocity/Move/Stop` 等旧接口及单机 service/demo 保留，供旧回归使用；默认应用只创建一个 MotorBus，旧 service 不并行运行。新运动接口使用 `Ex` 构帧与总线参数检查；不能绕过总线直接调用 BSP send。

## 3. 调度、状态与安全边界

`QrApp_Process` 调用 `BspMotorUart_PumpBus → MotorBus_Process`，再沿用触摸、PB12、USART3/扫码会话和 UI。HAL 回调仍唯一，由原 `bsp_uart_callbacks.c` 按实例分发；时钟、引脚、HAL 1.7.3、AC5、LCD、触摸、扫码协议均未迁移或升级。

- 一个活动请求，7 槽有界普通队列（每节点不重复排队）、一个最新四轮向量槽、一个同步事务。优先级为停止 → 同步准备/触发 → 普通控制/四轮组 → 停止反馈确认 → 轮询 → 版本诊断。停止可取消相关普通队列、四轮槽以及查询等待，保留已在途 DMA 帧到完整发送结束。
- 只在地址、功能码和预期响应类型匹配已发送请求时发布数据。9F、未知地址、错误长度、噪声、其它请求的响应不能确认当前动作；按长度解析，载荷中的 6B 不作帧尾，IDLE 仅搬字节。无法归属节点的坏字节计入 `bus.parser.rejected`，不伪造节点错误。
- 正常字段周期起点 500 ms；运动中的速度和机构位置起点 200 ms；状态仍为 500 ms。60 ms 应答超时；查询失败让出总线，下一次读安排在至少 500 ms 后，连续两次失败降为约 2 s 探测，不原地连续重试。成功后回到正常轮询。字段新鲜度 1600 ms，与 `last_rx_ms` 判定的在线状态分开。
- 超时/取消后该节点隔离 120 ms，再开始新的普通读/控制；停止使用不同功能码可抢占等待。位置/速度命令超时均不自动重发；四轮不在 ACK 不确定时改用同步补发。协议没有序号，软件 request_id 仅用于本地关联。**超过隔离期才来的同地址同码回包仍无法从线上可靠区分**；运动超时先停并验证，UNKNOWN 阻止新动作，不能承诺任意迟到 ACK 都能识别。需实测固件最大响应延时后核定窗口。
- 运动仍要求新鲜、在线、健康、已使能的反馈；`MANUAL` 仅是 UI 层的显式意图，驱动层可用 `MOTOR_DRIVER_REQUIRE_MANUAL=1` 恢复旧强制；让状态机直接调用时由上层保证显式意图。使能 ACK 与状态读回分开。位置需已核对每圈脉冲数；00 还需已知上一目标。中止/故障/速度模式会使上一位置目标关系失效；未建立目标时拒绝 00，使用经确认的 02 或 01。无未确认停止意图的 `UNKNOWN` 在收到新的零速/无故障反馈并过稳定窗后自动恢复（`MOTOR_UNKNOWN_AUTO_RECOVER_MS`，默认 500 ms）；仍在转/有故障时保持拦截。未配置参数时默认只允许单轴低速点动（`MOTOR_BENCH_JOG_ENABLED`），位置/四轮/同步仍需 `MOTOR_TEST_CONFIGURED=1`。
- 速度请求带 100～5000 ms 有效期，从提交时计时；最新排队向量不延长已运行向量的期限。四轮发送最多先按 100 ms 间隔。位置是一次性事务，1000 ms 内未发送就取消；执行超时范围为 100～60000 ms。零位移允许无位置变化；位置完成必须有本次发送之后的新位置/零速/到位反馈且目标误差在 128 编码器计数内（可配置）。
- 自本程序发起的运动期间，节点失联、查询超时、状态保护/堵转/失能或执行超时会请求停止；任一轮影响四轮组，机构按相关轴处理。恢复只查询。默认只读不接管外部控制器已在运行的电机，MCU 复位也不等于电机已停。
- Stop 不自动 Disable，尤其不松开地址 6。STOP ACK 不确认停止；发送后的新速度=0、状态无保护/堵转才 STOPPED，缺反馈保持未确认/超时 UNKNOWN。未确认意图不会因超时或 UNKNOWN 自愈被清除；首次提交及两次快速尝试按至少 200 ms 间隔，此后至少 1 s 一次，轮转轴并给反馈查询让出事务。重复 STOP 合并，不重置首次期限或证据基线；协议隔离/事务繁忙会延后发送。零速与状态必须在首次 STOP 提交之后新取得，ACK、DMA 完成和旧零速均不够。缺反馈持续重试，只有新鲜零速/无保护或堵转证据后确认，始终不重放运动。界面概览 `STOP?`、详情 `STOP UNCONF` 保留未确认状态。
- 同步在准备/触发/验证中被中止、拒绝、超时或传输错误，锁定后续同步；不能假设 Stop/Disable 清空缓存。默认启动也锁定同步。当前没有已实测的运行时清缓存/解锁流程。
- BSP 发送先复制到静态 TX 缓冲，HAL_BUSY 返回未提交，不复用在途缓冲；看门狗为 `20 + ceil(length*10000/115200)` ms，128 字节为 32 ms。电机 Pump 每次最多 128 字节，扫码 Pump 保留原有预算；UI 每次至多绘制一个 480×4 条带或两个字符，100 ms 限制快照请求，作业每轮推进。UART5 先隔离接收错误再清 IDLE，DMA 回调同样门控；恢复丢弃 DMA/SW 队列及协议半帧。接收不可用时阻止全部 TX（包含 STOP），停止意图继续保留至链路恢复；没有另开不能验证反馈的 TX-only 通道。RX 恢复失败至少间隔 100 ms，验证本次 DMA READY→BUSY、EN/DMAR/RxState/错误码；TX 启动也检查本轮 DMA 状态，RX 错误不主动中断在途 TX，看门狗才处理 TX 故障。真实主循环抖动需实测。

调试器可查看 `app.motor`：`nodes[i].data`、`action/request_id/target_counts`、`poll_samples/max_poll_gap_ms/max_age_ms/rejected_commands`，以及总线 `tx_frames/tx_bytes/rx_bytes/timeout_count/ignored_frames/transport_errors/max_step_ms`。这些是统计，不是硬件停车保证。MCU 停机、总线物理断开或断电负载保持仍需硬件方案。

## 4. API 最小示例

所有调用在同一前台上下文，不在中断直接提交；使用当前 `HAL_GetTick()`。以下是调用示意，不在启动或扫码事件中自动执行。

```c
MotorAction a = {0};
MotorBus_SetManual(&app.motor, 1u, now);
MotorBus_Enable(&app.motor, 5u, 1u, now); /* 再等待状态读回 bit0=1 */
a.command = Emm_MoveEx(5u, 0u, 10u, 100u, 32u, EMM_REL_ACTUAL, 0u);
a.pulses_per_rev = confirmed_pulses_per_rev;
a.timeout_ms = 8000u;
MotorBus_Submit(&app.motor, &a, now);    /* 检查返回值及节点 action */
MotorBus_Stop(&app.motor, MOTOR_ALL, now);
```

`MotorBus_Wheels` 接受完整 `int32_t rpm[4]`，先检查 -3000～3000 再取绝对值，拒绝 INT32_MIN；`MotorBus_Sync` 接受 1～7 个带缓存位的 MotorAction，仅允许一个准备事务，调用方不能直接广播触发。需要对同步位置动作设置各自已核对的 pulses_per_rev/timeout；初次同步仍受缓存锁定限制。

## 5. 软件验证记录

从工程根运行：

```powershell
powershell -NoProfile -ExecutionPolicy Bypass -File Scripts/test.ps1
powershell -NoProfile -ExecutionPolicy Bypass -File Scripts/build.ps1 -Rebuild
```

MSVC 使用 `/W4 /WX`。本次保留原有 70 项电机协议/service/demo 检查与原 UI 回归；扫码原有 1036 项回归保留，并增加七机页面和手动入口检查。测试同时编译默认配置和启用参数的配置（仅模拟使用 3200 脉冲/圈），检查三轴位置入口、四轮包、长按、点动、无自动运动。另新增七机协议/调度/故障/同步模拟、门控放宽/UNKNOWN 自愈/无 manual 直控用例、旧严格门控宏构建以及真实 UART5 BSP 替身测试。检查数包含循环断言，不以数量代替场景覆盖。

最终运行 `Scripts/test.ps1` 全部通过：

| 检查 | 实际结果 |
|---|---|
| 原电机/协议/service/demo | 70 项通过，原 UI 回归通过 |
| 默认扫码/七机 UI/应用 | 1066 项通过（含未配置点动用例），4 类扫码初始化失败场景通过 |
| 启用参数的扫码/手动应用分支 | 1066 项通过，4 类扫码初始化失败场景通过；3200 仅为替身参数 |
| 七机协议/调度/故障/同步（门控放宽默认） | 7499 项检查通过（含循环断言），新增无 manual 直控、反馈门控未放宽反例、UNKNOWN 自愈/仍转/故障保持拦截等 |
| 旧严格门控宏构建（`MOTOR_DRIVER_REQUIRE_MANUAL=1`、`MOTOR_BENCH_JOG_ENABLED=0`、`MOTOR_UNKNOWN_AUTO_RECOVER_MS=0`） | 5215 项通过，与放宽前一致，证明可回退 |
| 真实 UART5 BSP 替身 | 24 项通过，另覆盖 UART/DMA 初始化失败及 RX 启动失败恢复 |
| Keil 默认配置（门控放宽前记录） | 完整重编译 0 错误、0 警告；Code=41416、RO-data=16792、RW-data=1580、ZI-data=13324 字节 |
| Keil 启用运动分支（门控放宽前记录） | 完整重编译 0 错误、0 警告；Code=43696、RO-data=16808、RW-data=1580、ZI-data=13324 字节 |
| 最终配置 | `CONFIGURED=0`、`PULSES_PER_REV=0`、`SYNC_CLEAN_BOOT_CONFIRMED=0`，新增三个门控宏取放宽默认值；上表主机数字为本轮 macOS+clang 等价复现，Keil 行需在 Windows 重新编译确认 |

日志在 `Output/host-tests/results.log`、`Output/build.log` 和 `Output/build-manual.log`；`git diff --check` 无空白错误。沙箱内初次构建曾因 Windows DLL 重定位而无法启动 ArmCC，允许在沙箱外执行同一脚本后完成上述实际编译；未更换工具链。

模拟指标（固定 1 ms 前台步长，非实际硬件性能）：七机健康只读 2500 ms 内 TX 315 字节、RX 630 字节，各字段最大更新间隔 501/501/501 ms、最长有效样本年龄 500/500/500 ms；按 115200/8N1 的字节线时折算约 3.28% 占用，不包含实际固件延迟或其它主动回传。地址 1 掉线时，地址 7 最大间隔为 526/513/501 ms，模拟该阶段累计 5 次查询超时。10 Hz 生产者在 2000 ms 内发送 20 个四轮组，轮 1 获得 10 次新速度样本、无超时。实际周期、最长年龄、停止响应和占用仍须上板采集。

最终 map：RO 总量 58208 字节，RW+ZI=14904 字节，ROM 总量 59088 字节。UART5 `dma_rx=0x20001B18`（256）、`rx_queue=0x20001C18`（512）、`tx_bytes=0x20001E18`（128）；USART3 `qr_dma_bytes=0x20001F38`（256），均在片内 DMA 可访问 SRAM，未放 CCM/SDRAM。静态调用图默认已知最大深度 1000 字节、启用分支 2320 字节，另有函数指针/循环未知项；栈已配置 4096 字节，真实高水位和中断余量仍待实测。

`Output/host-tests/` 生成字体渲染 PGM 及测试程序；七机 WAIT、模拟 ONLINE 和节点详情都经过像素/文字边界检查与目视检查。生成图为软件替身，不能作为实物运行证据。

### 待实物验证

全部尚未执行：七台固件/地址/菜单、TTL 多机实际电平与接线；逐轴使能/速度/位置/停止与 6 轴保持；四轮不同速度真实读回、地址 1 断线和 ACK 丢失；同步缓存消费/中止清理规则；机构零点/限位/方向/每圈脉冲/安全行程；主循环与总线实际延时/占用、最长反馈年龄；持续扫码、PB12 示波器波形、触摸四角/切页、真实屏幕和比赛字高。逐项记录固件版本、参数、原始帧及现象后，才可改为“实物已验证”。

## 6. 逐文件最小改动理由

| 文件 | 改动与必要性 |
|---|---|
| `User/motor/emm_protocol.h` | 命令容量 128，增加地址/版本字段、位置模式和新构帧声明；保留旧接口兼容 |
| `User/motor/emm_protocol.c` | 地址解析、7 字节版本、12/22 语义，增加三位置模式/缓存、同类聚合、四轮有符号向量和触发构帧；复用原按长度解析 |
| `User/motor/motor_bus.h`（新增） | 定义七节点快照、动作结果、有界队列、同步事务及统一控制 API；2026-10-21 更新 MANUAL 语义注释 |
| `User/motor/motor_bus.c`（新增） | 唯一活动请求、轮询、分组/同步、取消/停止和故障处理；直接创建七个原 service 会争用 UART，故需此调度模块；2026-10-21 manual 门控可宏回退、UNKNOWN 自愈、入队失败消息细分 |
| `User/motor/motor_test_config.h`（新增） | 集中联调参数、默认运动拒绝及同步缓存门槛，避免把厂家高转速示例放入启动流程；2026-10-21 增加 `MOTOR_DRIVER_REQUIRE_MANUAL` / `MOTOR_BENCH_JOG_ENABLED` / `MOTOR_UNKNOWN_AUTO_RECOVER_MS` 三个可覆盖门控宏 |
| `User/usart/bsp_motor_uart.h` | 增加 Bus Pump 声明，旧单机 Pump 保留供兼容使用 |
| `User/usart/bsp_motor_uart.c` | 同一 UART5 DMA 接收/恢复代码增加 Bus 分发；TX 128、按长度看门狗、HAL_BUSY 和接收预算是大帧/并发所必需 |
| `User/app/qr_app.h` | 应用实例由单个 MotorService 改为一个 MotorBus，提供七节点状态 |
| `User/app/qr_app.c` | 真正接入 Bus Pump/调度及手动/停止分发；扫码会话、触发和接收调用沿用原流程，扫码事件不接运动；2026-10-21 增加 `CONFIGURED=0` 时的单轴点动分支，其余手动/停止流程不变 |
| `User/app/qr_ui.h` | 增加选中节点、详情/动作选择状态和手动/停止事件，显示参数改为 MotorBus |
| `User/app/qr_ui.c` | 沿用 9 行、字体、100 ms 局部更新及 QR/MOTOR/RESCAN；仅电机部分增加七行/详情、手动动作和 STOP，没有数字键盘或全面改版 |
| `Libraries/CMSIS/Device/ST/STM32F4xx/Source/Templates/arm/startup_stm32f429xx.s` | 仅 Stack_Size 1 KiB→4 KiB；128 字节组包和联调调用嵌套需要，启用分支静态调用深度超过原栈。未改启动逻辑/外设初始化 |
| `Project/YH-F429.uvprojx` | 仅增加 motor_bus.c 编译引用，不重建工程；不改芯片、HAL、编译器、时钟和引脚 |
| `Tests/test_motor_bus.c`（新增） | 七地址、拆帧/噪声/版本/边界、聚合/迟到、掉线恢复、停止优先级、位置完成、同步失败锁定等模拟；2026-10-21 增加无 manual 直控、反馈门控未放宽反例、UNKNOWN 自愈/仍转/故障保持拦截 |
| `Tests/test_motor_uart.c`（新增） | 使用真实 BSP 和回调源码检查 DMA 寿命、HAL_BUSY、128 字节看门狗、预算/溢出与初始化失败恢复 |
| `Tests/stubs/stm32f4xx_hal.h` | 为上述真实 UART5 测试补充 TX DMA/引脚/状态替身定义；生产 HAL 未改 |
| `Tests/test_qr.c` | 适配 Bus Pump 和 UI 数据参数，保留原断言，并增加七机页面、手动默认拒绝、动作/长按/STOP 与启用分支检查；2026-10-21 增加未配置单轴点动/配置拒绝分支与消息断言 |
| `Scripts/test.ps1` | 增量加入新测试源及启用参数的第二套应用构建；保留原测试入口和严格警告检查；2026-10-21 增加旧严格门控宏的 bus 构建（5215 项回归） |
| `README.md` | 将单机假设更新为实际七机实现、验证和文档入口，未验证内容保持待实测 |
| `Doc/QR_UART.md` | 仅增加当前电机链路交接说明，保留扫码阶段历史和会话/接线说明 |
| `Doc/MULTI_MOTOR.md`（本文，新增） | 交付运行效果、操作、官方对照、限制、验证和逐文件理由 |

未修改 `main.c` 的执行入口、motor_service/demo、二维码 parser/service/config/TRIG、统一 HAL 回调、时钟/引脚、触摸驱动及显示 BSP；任务书保留为原验收目标，不改写成实物完成记录。

当前 HEAD 差异中额外出现的 `Doc/MULTI_MOTOR_STAGE_TASK.md`、`Doc/QR_UART_STAGE_TASK.md`、`Scripts/build.ps1`、`User/touch/gt9xx.c` 属于上述开始前已有内容，本次没有编辑；审阅本次范围可使用 `git diff b493bcc --` 并同时查看新增文件。
