dadatiaoao/-1021ccc/Doc/MULTI_MOTOR_STAGE_TASK.md

# 【已过时，仅供参考】小阶段任务书：七电机通信与分组控制

> **已过时，仅供参考；当前状态、需求、配置和验收结论以 [工程 README](E:/工创赛/迁移野火板/README.md) 为准。**
> 2026-10-26 用户进一步实机确认：**全部 1～7 号电机均为 3200 指令脉冲/电机圈，6 号同步轮 20 齿、同步带齿距 2 mm，对应 40 mm/电机圈**。下文相关“假设/待核对”仅保留为确认前的历史状态，不再是当前待办。 当前记录见[机构标定记录](MECHANISM_CALIBRATION_TODO_2026-10-25.md)。
> 归档标记：2026-10-22。以下保留原阶段目标、交付与验证记录，不代表当前仍待执行、未完成或已经实物验收；正文及嵌套文档中的旧交接指令不再直接执行。与 README 冲突时，以 README 为准。历史版本的测试证据及引用资料仅用于追溯。

日期：2026-10-21。本文供新的对话实施，是待办任务书，不代表功能已经完成。本次只编写文档，不修改控制代码。

## 1. 阶段目标与范围

在已接入 XM1605 扫码的野火 F429 工程上，将地址 1 的单电机通信扩展为同一 UART5 总线上的七电机通信：

1. 七台独立查询和显示实际速度、位置、状态、数据有效期与错误。
2. 七台可按地址使能、停止及下发受控的速度/位置指令。
3. 四轮支持一次提交四个不同速度，并通过厂家 0xAA 多电机命令成组发送。
4. 支持厂家“先缓存、再同步触发”机制的非阻塞事务，作为兼容/联调入口。
5. 三个机构轴支持方向、速度、加速度、脉冲数及明确的位置模式；本阶段不做 mm/角度机械标定。
6. 保留扫码、PB12 周期触发、会话锁定、RESCAN、触摸与显示，默认启动仍不自动运动。

本阶段交付通信基础与可手动触发的联调入口，不实现麦轮运动学、里程计、导航、机械臂动作编排、限位回零、舵机或完整比赛流程。七个电机无需七个串口。

### 明确要求：对工程进行最小限度的改动

在满足本任务功能和验收要求的前提下，只修改实现七电机通信所必需的代码：

- 复用现有协议、UART5 DMA 收发、统一 HAL 回调、应用主循环和显示框架。改动集中在地址路由、收发容量、总线调度、节点状态、控制入口及必要的 UI 集成；优先在现有模块内扩展，确有必要时再增加小模块。
- 保持现有时钟、引脚、外设分配、HAL/编译器版本和工程组织；不重建 CubeMX，不整体移植厂家工程，不引入 RTOS 或通用多协议框架。
- 保留已完成的扫码功能和时序。七机页面及联调控件沿用现有 UI，不为此次任务全面重做界面或重构无关模块。
- 不做无关文件移动、批量重命名、全工程格式化、编码转换或顺手清理；Keil 工程与测试脚本仅做必要的增量调整。
- 最小改动不意味着保留单机假设、绕过统一总线发送或省略超时/停止处理。必要重构应限于受影响链路，并说明为什么直接扩展不足以满足要求。
- 交付时按文件列出“改了什么、为什么必须改”，说明已有扫码功能的回归结果，让用户能审阅实际改动范围。

## 2. 固定地址与工程基线

| 地址 | 角色 | 主要用途 |
|---|---|---|
| 1 | 前左轮 | 速度 |
| 2 | 前右轮 | 速度 |
| 3 | 后左轮 | 速度 |
| 4 | 后右轮 | 速度 |
| 5 | 旋转臂 | 脉冲位置 |
| 6 | 上下轴 | 脉冲位置 |
| 7 | 前后微调轴 | 脉冲位置 |

这些是用户确认的地址对应关系，不是程序已经逐台验证的结果。不要自动改地址、升级固件、恢复出厂设置或写入持久参数。

开始时读取：

- [README](E:/工创赛/迁移野火板/README.md)：已确认硬件与当前软件事实。
- [扫码实现说明](E:/工创赛/迁移野火板/Doc/QR_UART.md)。
- `E:/工创赛/迁移野火板/User/main.c`、`User/app/qr_app.c/.h`、`User/app/qr_ui.c/.h`。
- `User/motor/emm_protocol.*`、`motor_service.*`、`motor_types.h`。
- `User/usart/bsp_motor_uart.*`、`bsp_uart_callbacks.c`、`bsp_debug_usart.c`。
- `User/qr/qr_config.h`、`User/usart/bsp_qr_trigger.*`。
- `Project/YH-F429.uvprojx`、`Scripts/test.ps1` 和 `Scripts/build.ps1`。
- [总体架构](E:/工创赛/迁移分析/七电机整车程序架构设计_2026-10-20.md)，仅参考本阶段相关部分，不扩大实施范围。

编写本任务书时 HEAD 为 `1ee1e49 主控周期触发扫码`，工作区原本干净；新对话先重新检查 Git 状态，保留后续用户修改。用户已报告扫码模块完成；现有文档的实物验证仍缺详细记录，不能据此补写未提供的测试结果。

当前 `QrApp` 内只持有一个 `MotorService`，`QrApp_Process` 调用 UART5 Pump 和单机服务；UI 也只接收一个 MotorSnapshot。扩展总线时必须同时修改这条集成链路，不能只新建一个未接入主循环的模块。

## 3. 官方参考资料与核对结果

主要资料根目录：

`D:/BaiduNetdiskDownload/ZDT_XS系列第二代闭环步进电机资料`

优先读取此目录中的 **`9. 例程_STM32F407/HAL库/Emm固件模式/串口通讯`**，不要使用 X 固件或 CAN 示例替代当前 Emm/TTL 协议：

| 官方压缩包 | 重点参考 |
|---|---|
| `STM32F407_串口通讯__多电机命令.rar` | `Src/main.c`、`Src/Emm_V5.c`、`Inc/Emm_V5.h`；MMCL 缓存及 0xAA 封装 |
| `STM32F407_串口通讯__多机同步控制.rar` | 单播带同步标志、间隔、广播 0xFF 触发 |
| `STM32F407_串口通讯__速度模式.rar` | F6 字段和方向/速度/加速度 |
| `STM32F407_串口通讯__位置模式.rar` | FD 字段与三种位置模式 |
| `STM32F407_串口通讯__读取电机实时位置.rar` | 位置回包与单位 |
| `STM32F407_串口通讯__读取电机实时转速.rar` | 速度回包与单位 |
| `STM32F407_串口通讯__使能信号控制.rar` | 使能帧 |

需要解压时放到工作区的独立参考目录，保留官方原文件不动，不将厂家整套工程/HAL 拷贝覆盖本工程。

手册为：

`D:/BaiduNetdiskDownload/ZDT_XS系列第二代闭环步进电机资料/3. 说明书/ZDT_X42S第二代闭环步进电机用户手册V1.0.5_260527.pdf`

重点页：18～19（通信配置）、26（TTL 多机接线）、36～40（反馈与同步）、49～50（多电机命令）、53（Emm 速度）、57（Emm 位置）、60（停止/同步）、67～74（版本及反馈）。

本次直接读取官方 F407 压缩包后确认：

- `Emm_V5_MMCL_Vel_Control` / `Emm_V5_MMCL_Pos_Control` 先追加子命令，`Emm_V5_Multi_Motor_Cmd(0)` 发送 `00 AA + 两字节总长度 + 子命令 + 6B`。
- 四条速度子命令共 32 字节，含外层一共 **37 字节**，头部应为 `00 AA 00 25`。每条子命令保留自己的 6B，外层再有一个 6B。
- 同步例程将每条指令的同步标志置 1，命令之间 `HAL_Delay(10)`，最后发 `00 FF 66 6B`。
- 例程使用 `huart1`、静态/global 缓存、直接 HAL DMA 发送，以及无限等待回包；这些仅为演示写法。迁入本工程应复用 UART5 的统一调度、持久 TX 缓冲和超时，不照搬阻塞循环。
- 官方同步示例注释明确提醒：不要让多台同时发送到位通知，以免总线冲突。
- 示例部分注释给出 0～5000 RPM，而上述手册 Emm 命令页给出 0～3000 RPM。首版按手册较保守范围做协议参数检查，并把差异记录到实现说明；实际运动还要受更低的联调配置限制。

## 4. 工程约束与必须保留的功能

继续现有 HAL 1.7.3 / Keil AC5 / 180 MHz 配置，不重建 CubeMX、不升级整套 HAL、不切换 RTOS。

| 资源 | 已用配置 |
|---|---|
| 电机 | UART5，PC12 TX、PD2 RX；115200/8N1 |
| 电机 DMA | RX DMA1 Stream0/CH4，TX DMA1 Stream7/CH4 |
| 扫码 | USART3，PB10/PB11；RX DMA1 Stream1/CH4 |
| 扫码触发 | PB12；`qr_config.h` 当前宏为周期 1000 ms、低电平 800 ms |
| 调试串口 | USART1，PA9/PA10 |
| HAL 回调 | `bsp_uart_callbacks.c` 唯一入口，按 UART5/USART3 分发 |

`QR_UART.md`、`qr_config.h`/`bsp_qr_trigger.*` 注释和测试期望已于 2026-10-21 同步为当前宏 1000 ms/800 ms。以当前宏为集成基线，不在电机任务中擅自改扫码时序。

原电机自动演示不恢复到默认入口，扫描成功/失败、RESCAN、切页、连接恢复和复位都不得隐式触发运动。单电机旧测试/演示可通过兼容接口保留；测试接口需要调整时保留原本验证的行为，不通过删除断言掩盖回归。

## 5. 总线与协议工作项

### A. 一个总线管理器，七个节点状态

推荐建立 `MotorBus`，内部保存 `MotorNode/MotorSnapshot[7]`，整个 UART5 只有一个发送所有者。可以重构现有 service，也可新增 bus 后让旧接口适配，但默认应用只能运行一个总线调度器。

总线负责请求队列、优先级、发送与回包匹配、轮询、超时、迟到响应、分组事务和传输异常。节点负责地址/角色、测量值、字段时间戳、有效性、在线状态和错误计数。

解析结果必须带地址；单播事务按“地址 + 功能码 + 预期响应类型”匹配。未知地址、不相关功能码、过期/异步通知不能结束当前事务。保留拆包、粘包、噪声、载荷中含 6B 的处理，不把 IDLE 当帧尾。

在线状态与具体字段新鲜度分开：收到状态不等于位置也新鲜，故障节点不能让其它节点一起变成离线。UART 总线级故障则影响整条总线，清理/标记未决事务并使相关数据失效。

协议没有事务序号，本地 request_id 只能用于软件关联，不能彻底识别迟到的同地址同码回包。实现要说明隔离窗口、重试与丢弃策略；不能把迟到旧 ACK 误判成下一动作成功。

### B. 控制接口

| 接口意图 | 约束 |
|---|---|
| 按地址查询 | 1～7 的速度、实际位置、状态；启动/诊断可读硬件固件版本 |
| 按地址使能 | 显式请求；与实际使能状态确认分开 |
| 按地址速度 | 方向、速度、加速度、可选缓存标志 |
| 按地址位置 | 方向、速度、加速度、脉冲数、模式、可选缓存标志 |
| 四轮速度组 | 固定地址 1～4 的完整向量，单个 0xAA 包 |
| 同步事务 | 提交成员和命令，逐一准备并确认，最后触发；不允许随处单独调用广播触发 |
| 停止单轴/底盘组/全部 | 最高优先级；取消相关尚未发送动作并分别验证停止 |
| 状态与结果读取 | 区分排队、已发送、接收确认、执行、完成、拒绝、超时/未知、取消 |

位置模式应显式枚举：

- 00：相对上一输入目标位置。
- 01：相对坐标零点的绝对位置。
- 02：相对当前实际位置。

本阶段不假设机构已经回零或标定，应用层不得把绝对脉冲坐标宣传为机械绝对位置。位置验收若需要期望角度，必须提供并核对实际每圈脉冲数；电机反馈的 65536 计数/圈与指令脉冲数不是同一单位。

四轮 API 可接受有符号 RPM 向量，集中换算为方向+幅值；防止负数取绝对值溢出。CW/CCW 不等于车体前进/后退，本阶段不猜各轮安装方向。

### C. 多电机封装、应答与容量

- 0xAA 首版只聚合运动命令，不将多台读取混入同包。
- 手册规定运动聚合命令只有地址 1 回复。四轮包应匹配地址 1 的对应控制响应，不能等待四个 ACK；也不能凭一个 ACK 将四台全部标为成功。
- 本阶段常用聚合包采用同类子命令，尤其四条 F6；混合不同控制功能码的完整支持不是必需，避免自行猜多个确认的对应方式。
- 0xAA 内位置命令的“同步位”用于是否返回到位通知，不能与普通单播缓存语义混用。组包接口必须区分，默认不开启主动到位通知。
- `02` 是接收确认，`9F` 是异步完成通知；`12/22` 按对应命令语义处理，不能一概当格式错误或正常完成；保留 `E2/EE` 的原始含义。软件超时/传输异常单独分类。
- 单地址误差/状态/速度等实际反馈才用于确认执行；位置完成需结合本次目标、新鲜反馈、容差和超时，不能仅看之前遗留的“到位”标志。
- 零位移或已经位于目标的合法请求允许不发生位置变化，不能把旧演示的“必须观察到移动”条件机械套到所有位置动作。
- 扩大 `EmmCommand` 和 UART TX 缓冲；可用 128 字节作为七轴常见指令的有界容量。所有添加、总长度、DMA 长度和复制都检查边界，统一长度类型。七条 13 字节位置指令加外层共 96 字节，但是否开放这种包仍按应答与同步约束决定。
- TX 缓冲在硬件发送完成前不可重用；HAL_BUSY 不等于提交成功。检查现有固定 20 ms TX 看门狗与最大帧、波特率和调度抖动是否匹配，必要时按长度计算。

### D. 同步缓存事务

采用 `PREPARE → ACK_ALL → TRIGGER → VERIFY` 非阻塞流程；其中 ACK_ALL 仅适用于逐台缓存的单播阶段，不适用于 0xAA。

任一成员拒绝、离线、准备超时或取消时，不广播触发。一次仅允许一个同步准备事务；广播 0xFF 会触发总线上所有已缓存命令，不能假设其只作用于软件中命名的底盘组。

官方资料没有在本任务中证明“Stop/Disable 一定清除所有缓存”。部分准备失败后进入同步状态不确定/锁定状态；明确实施经资料与实测验证的清理/重新建立已知状态流程。未经确认不得解锁后直接发下一次广播。不要为清理缓存而随意触发未知动作。

对 0xAA 执行状态不确定也不自动切换另一种机制重发，避免相同位置动作执行两次。同步启动不代表同时到位。

## 6. 调度、故障和带宽

1. 优先级：停止及故障处理 > 控制/必要确认 > 常规轮询 > 诊断。
2. 四轮速度使用“最新完整向量覆盖尚未发送的旧向量”，不排队回放一串过期速度。位置动作是一次性事务，不能按同样规则悄悄覆盖或重复。
3. 同一总线上默认只等待一个可确定匹配的单播应答；广播/聚合采用各自明确的应答策略。
4. 查询允许有限重试，但一次失败后让出总线；掉线节点降低探测频率。不能对一个掉线节点连续长时间重试而拖住其它六台。
5. 运动 ACK 超时标记结果未知，不自动重复位置命令；先停止/查询/确认状态，再由联调流程决定下一步。
6. 停止可取消普通待发队列及查询等待，发送前处理已在途帧与最小间隔，禁止随意拼接截断帧；迟到响应不能复活被取消动作。停车后没有新反馈时显示未确认。
7. 地址 1 失联时，0xAA 包可能没有 ACK，但其它成员仍可能执行；四轮组立即进入故障处理，不可把此情况当作“整组没动”而重发。
8. 底盘任一轮故障时停止整个底盘组；三个机构轴按受影响范围处理。地址 6 升降轴不默认失能，停止与松轴分开；通信控制不能保证断电后的负载保持。
9. 故障恢复只恢复查询，不自动使能、不重放旧动作。四轮速度命令带有效期，上层停止更新则请求停车；MCU 停机或物理通信失效时该软件机制不构成硬件停车保证。
10. 接收 Pump 和绘图有单次处理预算，保持扫码触发/接收及时运行，不在主循环中无限清空高速输入。

厂家同步例程使用 10 ms 间隔，当前单机服务使用至少 5 ms。新实现先将间隔集中配置，以 10 ms 作为保守联调起点，实测后调整；所有间隔通过时间状态机实现，不使用 HAL_Delay。

不要要求七台各自每 100 ms 查齐三个量。可采用以下起点，后续根据总线统计实测调整：

| 运行状态 | 调度建议起点 |
|---|---|
| 默认只读 | 每台三个反馈约 500 ms 一轮，按事务交错，总计约 42 次查询/秒 |
| 四轮运动联调 | 四轮整组速度最多先按 10 Hz 更新；各轮速度约 5 Hz |
| 全节点基础状态 | 每台约 2 Hz |
| 机构位置 | 每轴约 2 Hz；当前运动/接近目标的轴临时提高反馈优先级 |
| 掉线节点 | 降频探测，不占用正常轮询频率 |
| UI | 延续约 100 ms 局部更新 |

以上是设计初值而非性能保证。字段有效期按各自轮询周期设置，不能继续以“三项都在 500 ms 内”判所有节点在线。报告实际更新间隔、最长数据年龄、超时和总线占用；停止响应不得受低频基础轮询限制，停车后优先查询相关轴。

## 7. UI 与联调入口

默认上电仅七机轮询和扫码。电机页显示七行地址/角色/在线或过期/实际转速/关键状态；选择某轴查看实际位置、目标、最后应答、错误和时间。480×272 空间不足时分页，保留 QR/MOTOR 与 RESCAN 行为。

提供一个明确选择的手动联调模式，用于“选地址的使能/停止、有限时速度动作、有限脉冲位置动作、四轮速度组”。参数集中在联调配置中，不要求做复杂屏幕数字键盘；未配置有效测试参数时拒绝运动并给出原因。

单次触发执行一次，按钮长按不得不断提交相对位置动作。保留始终可访问的停止入口。不得照搬厂家 1000～2000 RPM、多圈脉冲的上电示例作为默认演示。

三个机构轴尚无完整限位/零点方案，本阶段不自动碰撞回零、不自行寻找端点；实物位置联调使用已确认不会越程的低速小行程或脱开负载条件。软件接口和模拟测试可先完成，不因机械标定尚未完成而停止全部开发。

扫码会话接受事件只更新显示/数据，不连接到新运动接口。只读页面应标明只读；进入手动控制模式后更新模式标签，不出现“READ ONLY”同时发送动作的情况。

### 明确要求：给出最终运行效果

以下是本阶段完成后的预期效果，属于验收目标，当前不能写成已实现或已实测。交付时应逐项说明实际达到的效果、操作入口和验证依据。

| 场景 / 用户操作 | 最终应观察到的效果 |
|---|---|
| 上电或复位 | 扫码与七机轮询同时启动；默认只读，不主动使能或下发运动命令。没有接齐七台时也能正常使用。 |
| 查看 MOTOR 页 | 可看到地址 1～7 与对应角色、在线/离线/过期状态、实际转速和关键状态；选择节点可看位置、目标、应答及错误。无有效反馈时显示“无数据/过期”等标识，不用初始零值冒充实测值。 |
| 扫码、RESCAN、切页 | 延续现有周期触发、扫码锁定和重扫行为；七机通信继续运行，这些操作不会触发电机运动。 |
| 手动选择单台并触发速度动作 | 只有选定地址收到该次运动控制，按已配置的方向、速度和时限运行；可看到指令状态与实际速度反馈。未配置有效参数时明确拒绝。 |
| 手动触发四轮速度组 | 地址 1 前左、2 前右、3 后左、4 后右分别接收各自的设定速度，支持四个不同值；地址 5～7 不受此操作驱动。界面区分组命令应答和四台实际反馈，不将一个 ACK 显示成四台执行完成。 |
| 手动触发机构位置动作 | 地址 5 旋转臂、6 上下、7 前后微调按所选单轴执行一次低速、有限脉冲动作；长按不重复提交。显示本次目标、实际位置和执行状态；未机械标定前不宣称已实现准确 50 mm 或指定机械角度。 |
| 执行同步联调 | 各成员准备成功后才发送同步触发；准备失败时显示失败/缓存状态不确定并禁止继续广播，不因一个成员失败而误触发其余已缓存动作。 |
| 点击单轴、底盘或全体停止 | 取消相关待发运动并优先请求停止，随后用反馈更新结果；无反馈时显示“停止未确认”，不能宣称已停稳。地址 6 不因普通停止而自动失能松轴。 |
| 某电机掉线或故障 | 明确标识受影响节点；其余可通信节点的查询、扫码和触摸继续工作。底盘任一轮故障则请求停止底盘组，并显示确认情况。恢复连接后仅恢复查询，不重放旧动作。 |

实现说明 `Doc/MULTI_MOTOR.md` 和最终回复必须提供一份可照着操作的运行指南：上电后看到什么、如何进入手动模式、如何选择地址/动作、参数在哪里配置、如何启动与停止、异常时显示什么。逐项标记“软件/模拟已验证、实物已验证、待实测”，附实际测试结果；只有真实采集的屏幕或串口记录才能作为实机证据。无需为了演示效果增加复杂 UI 或自动运动流程。

## 8. 分步交付与验收

### 第一步：七机只读

完成地址路由、独立快照、总线轮询、掉线退避和七机 UI；上电无运动命令。扫码与电机同时运行。只接部分电机时也能使用，未接节点明确无有效数据，不以初始零值冒充读回。

### 第二步：控制与分组

完成逐台使能/停止/速度/位置、四轮 0xAA、传统同步事务、优先级与取消。默认仍只读，联调动作需显式触发。以官方字节格式建立纯 C 协议与调度测试。

### 第三步：故障与集成回归

覆盖以下有意义的场景：

- 七地址交错回包、拆分/粘连/噪声、载荷含 6B、错误地址/长度/帧尾不误确认。
- 四轮包长度 37、顺序 1～4、总长度字节及内外校验；组包溢出不发送截断数据。
- 位置模式 00/01/02、正负速度转换、参数边界。
- 0xAA 仅地址 1 的 ACK、ACK 丢失但其它轴可能已执行、9F 不冒充接收确认。
- 单播查询重试和迟到回包隔离；运动超时不重复执行；单节点掉线不饿死其它节点。
- 同步准备中某轴拒绝/超时：不发触发；残留缓存锁定后不隐式恢复。
- 停止在队列满、查询等待或准备同步期间仍能进入；旧速度和相对位置不在停止后被重放。
- TX DMA 数据寿命、HAL_BUSY、UART/溢出恢复；UART5/USART3 回调互不串线。
- 位置本来就在目标、过期到位标志、实际未到目标等完成条件。
- 默认启动、扫码成功、RESCAN、切页、长按、掉线恢复和复位不误触发运动。
- 扫码锁定/去重/重扫、PB12 宏配置波形、触摸、UI 边界和原电机行为回归。

使用现有脚本并按新增模块扩展测试入口；旧接口变更时调整测试结构但保留回归目标，不以固定断言数量作为唯一标准。

在 `E:/工创赛/迁移野火板` 运行：

```powershell
powershell -NoProfile -ExecutionPolicy Bypass -File Scripts/test.ps1
powershell -NoProfile -ExecutionPolicy Bypass -File Scripts/build.ps1 -Rebuild
```

要求主机测试通过，Keil 0 错误、0 警告；原有 gt9xx.c 的 8 个未使用符号警告已修复，构建脚本会拒绝任何新警告。核查扩大后的 DMA 缓冲仍在片内可访问 SRAM，并记录内存使用。

### 实物验收单独记录

1. 逐台核对固件、唯一地址、115200/8N1、0x6B、Receive，关闭未安排的定时主动回传/到位通知；先记录设置，不自动写参数。
2. 接线按厂家 TTL 多机图并核对实际电机版本，逐台验证，再接七台；显示七台独立反馈。
3. 分别验证一台速度、位置、停止，然后四轮不同速度聚合；观察真实反馈，不仅看 ACK。
4. 验证传统同步缓存与触发，以及中止/失败后的缓存恢复边界；无法验证清理规则时保留同步故障锁定，不宣称可安全重用。
5. 验证单节点失联、地址 1 失联、应答缺失及恢复，确认其它节点查询和扫码仍可运行，且没有旧动作重放。
6. 与扫码持续输出、触摸切页、PB12 触发并发，测量周期与错误计数。

无法实测时，完成软件实现、模拟验证和构建，提供具体接线/操作步骤，将物理项标为待实测；不得把软件通过写成七电机实物验收通过。

## 9. 最终产物与交接提示

应交付：

- 协议扩展、总线/节点管理、实际主循环与七机 UI 集成、联调入口、Keil 工程引用和测试。
- `Doc/MULTI_MOTOR.md`：地址、接线、配置、API、官方对照、时序、已知限制、实测操作与验证记录。
- README 只更新实际落地和已明确的信息，未完成计划留在本任务书。
- 逐文件最小改动说明、测试/构建结果，以及与之分开的实物验证状态。
- 最终运行效果与操作指南，逐项对应第 7 节的场景，说明已达到的效果、验证方式和待实测项。

可直接发给新对话：

> 请读取并执行 E:/工创赛/迁移野火板/Doc/MULTI_MOTOR_STAGE_TASK.md，在已完成扫码模块的现有野火 F429 HAL/Keil 工程中实现七电机通信。主要参考 D:/BaiduNetdiskDownload/ZDT_XS系列第二代闭环步进电机资料/9. 例程_STM32F407/HAL库/Emm固件模式/串口通讯 中的多电机命令、多机同步控制及基本控制例程，并核对同目录资料根下的 X42S 手册。地址固定为 1 前左、2 前右、3 后左、4 后右、5 旋转臂、6 上下、7 前后微调。完成七地址轮询、统一总线调度、四轮 0xAA 速度组、三个机构轴的位置指令、非阻塞同步事务、停止/故障处理与状态显示。明确要求对工程进行最小限度的改动，复用现有模块，只调整必要链路，不做无关重构或全面 UI 改版；交付逐文件改动理由。保留扫码、PB12 周期触发、会话锁定和触摸；上电默认只读，运动由明确联调入口触发，不恢复自动演示。无需重建 CubeMX。完成主机测试与 Keil 编译，README 只写实际事实；实物未验证的部分单独列出，不把 ACK 当运动完成。必须给出最终运行效果及可操作的使用步骤，覆盖上电、七机显示、扫码并行、四轮速度、机构位置、停止与掉线恢复，区分预期效果、软件验证和实物验证。先检查工作区，保留已有改动。
