dadatiaoao/-1021ccc/User/gyro/UPSTREAM.md

# Gyro driver provenance

## MPU6050 migration (2026-11-05)

The active driver is now `mpu6050.c/.h`. The bounded state-machine structure
was adapted from this project's previous Apache-2.0 ICM implementation, so its
copyright notices and license remain. No third-party MPU driver was copied.
The old register bank, I3C setup, reset interrupt, DRDY bit and invalid-sentinel
rules have been replaced, not reused as MPU6050 register behavior.

Primary references read:
- InvenSense RM-MPU-6000A-00 rev 4.0, [manufacturer-authored register map hosted by SparkFun](https://cdn.sparkfun.com/datasheets/Sensors/Accelerometers/RM-MPU-6000A.pdf): registers 25–27, 55–58, 67–72, 106–108 and 117, shadow-register coherency and status clearing.
- InvenSense PS-MPU-6000A-00 rev 3.4, [TDK product specification](https://product.tdk.com/system/files/dam/doc/product/sensor/mortion-inertial/imu/data_sheet/mpu-6000-datasheet1.pdf): electrical levels, I2C/address, axes and startup.

The old TDK register-map download redirects to a search page; the directly
readable manufacturer-authored rev 4.0 mirror is recorded explicitly above.
MPU configuration is 100 Hz, +/-500 dps, 20 Hz DLPF, gyro XYZ enabled,
accel/temp/FIFO/auxiliary master disabled. Every setting is read back and
periodically checked. There is no RESET_DONE interrupt or reserved negative
sample encoding. A status poll followed by a coherent 15-byte status/data
burst consumes any event arriving between the transactions. Existing service,
calibration, UI and bus timeout/recovery contracts are retained, with the old
fixed bias disabled by default. See [migration record](../../Doc/MPU6050_MIGRATION_2026-11-05.md).

## Original ICM42688 source history

Adapted from Zephyr **v3.7.0**, commit `36940db938a8f4a1e919496793ed439850a221c2` (tag resolved through GitHub's commit API).

Read and used:

- [icm42688_common.c](https://github.com/zephyrproject-rtos/zephyr/blob/36940db938a8f4a1e919496793ed439850a221c2/drivers/sensor/tdk/icm42688/icm42688_common.c), blob `3a0c79869be9c4665eba0b1fc915234366b1448f`.
- [icm42688.c](https://github.com/zephyrproject-rtos/zephyr/blob/36940db938a8f4a1e919496793ed439850a221c2/drivers/sensor/tdk/icm42688/icm42688.c), blob `febb4612efaf8167c5731fcb59d9797fcc30491a`.
- [icm42688_reg.h](https://github.com/zephyrproject-rtos/zephyr/blob/36940db938a8f4a1e919496793ed439850a221c2/drivers/sensor/tdk/icm42688/icm42688_reg.h), blob `5f3b58f0b3c074d69ee029cf1d956f4f73dd554e`.

Apache-2.0. Original copyright notices are retained in `mpu6050.c`; full license is in `LICENSE-Apache-2.0.txt`. This directory contains a **modified subset**, not an unmodified vendor SDK. Register values and added behavior were checked against TDK DS-000347 rev 1.6.

## Historical ICM42688 core logic (before MPU6050 migration)

| Upstream function | Local implementation | Preserved behavior |
|---|---|---|
| `icm42688_reset` | `Icm_Begin` / `Icm_Step` phases 0–6 | POR allowance, soft reset, wait, RESET_DONE and WHO_AM_I verification |
| `icm42688_configure` | `Icm_Step` settings sequence | Gyro power mode / FSR / ODR, startup settling, FIFO bypass, FSYNC off, DRDY source |
| `icm42688_sample_fetch` / `icm42688_read_all` | `Icm_Fetch` | Status → DRDY gate → one burst → signed big-endian decoding; no-data is distinct from a new sample |
| Register header | Relevant constants in `icm42688.c` | Register addresses, WHO_AM_I and status bits |

## Historical ICM42688 changes

- Replace Zephyr device/SPI/logging/sleep/byteorder glue with a small injected `GyroIo`, implemented by independent STM32 hardware I2C1. No RTOS or new toolchain.
- Split sleeps and configuration into deadlines and one transaction per initialization step. Check identity before reset as well as after it. Verify bank, reset-bit clear and every written setting.
- Configure filters and interface **before** powering the gyro (TDK §12.9). Retain the upstream 50 ms startup allowance and perform no writes after gyro ON during that wait; satisfy the separate 200 µs / 45 ms constraints.
- Explicit TDK §12.3 I2C settings: bank 1 INTF_CONFIG4/5/6, return bank 0, DRIVE_CONFIG. Preserve documented reset values in reserved bits. Use internal PLL/RC, no external clock.
- Gyro only: read six contiguous gyro bytes instead of fourteen temp/accel/gyro bytes. Accelerometer and temperature are off. Preserve signed conversion while removing the Zephyr host-endian helper (ARM target and host tests both decode explicitly).
- Set DRDY latched / clear-on-sensor-read, so a status read does not prematurely clear an event before the gyro burst. Equal raw values still count as new samples when DRDY is set. Guard invalid sentinel codes and near-full-scale saturation.
- Add periodic ID/bank/power/FSR/interface checks. Reject mismatches; do not silently accept another ICM variant or the module's MCU protocol.
- Omit FIFO, RTIO, triggers, accelerometer channels and runtime attribute APIs outside this stage. The calibration/integration service, UI and all bus code are local implementations, not upstream algorithms.

Selection rationale: the inspected Zephyr driver provides a licensed, compact C register path and clear reset/fetch contracts; its RTOS bindings can be removed without importing an application framework. The other inspected candidate, [oldsheep68/icm42688](https://github.com/oldsheep68/icm42688), is Rust/embedded-hal and would require a different toolchain. The WDS601M images advertise Arduino/ROS examples but do not supply their sources. No module MCU example or attitude-fusion output is used here.

The retrieved upstream originals are retained under ignored `Output/gyro-reference/` for this implementation session; the pinned public links above make the provenance independently reproducible.
