dadatiaoao/-1021ccc/Doc/UI_HOME_2026-10-24.png

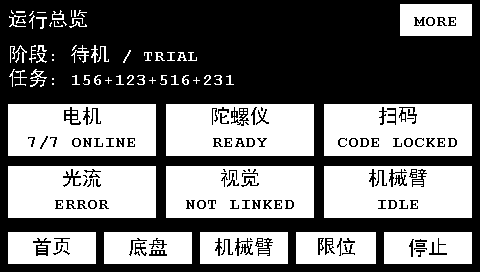
Doc/UI_HOME_2026-10-24.png
