dadatiaoao/-1021ccc/Doc/MECHANISM_CALIBRATION_TODO_2026-10-25.md

# 机构参数标定待办与记录

## 2026-11-06 现行三轴碰撞回零标定入口

本文件下方 2026-10-25/26 的限位回零零点、0～90°/0～160 mm 范围、旧 7 轴 1500 ms 判定和旧 TEST 起点均为**历史版本记录**。当前实施状态、参数表、主机验证和实机记录要求统一见[三轴碰撞回零第一阶段](MECHANISM_COLLISION_STAGE1_2026-11-06.md)，以 `mechanism_config.h` 为代码配置入口。此次三轴新集成尚未实机验收，不能用原限位回零或 PR 抓取试验的实测确认替代。

当前待测重点：5 轴接触零点与 4°固定退角、90°工作姿态和 0～180°边界；6 轴碰撞点 0 mm、名义观察 10 mm、后续抓取 140 mm 的实物位置及 150 mm 普通指令上限下的底部余量；7 轴外伸接触后中点 0 mm；七机总线位置样本间隔与三轴 1500 ms 判定的误触发率；PG2/PG3 仅显示且不影响运动；任一 STOP/故障后不继续停放。记录固件提交和各轴原生完成或主控中断路径，不以软件 SUCCESS 替代量具测量。

更新：2026-11-04；当前源码核对基线 main / `f14be37`。范围为 5 号旋转臂、6 号升降臂和 7 号微调臂；第 6、7 节的构建/回归描述保留 2026-10-26 当时记录，不能理解为当前构建状态。

**新增用户确认（2026-11-04）：已完成当前屏幕八段底盘验收和机构回零测试。** 未提供测试实际日期、固件提交号/HEX、各轴覆盖和重复次数，暂不认定所有回零分支及异常路径均已验收；机构精度、端部余量和带载保持继续按下表跟踪。

当前参数及假设以 [mechanism_config.h](../User/mechanism/mechanism_config.h) 为准；本文补充用户最新确认、待测项目和记录方法。本文记录当前机械事实、参数及本轮回零改动；未验证项目明确保留。已有原始数据和历史验证见[机构试运行说明](MECHANISM_TRIAL_2026-10-24.md)。

## 1. 已确认事项

| 项目 | 已知结论 | 证据范围 |
|---|---|---|
| 5 号传动 | 同步轮 1:3 减速，电机一圈对应最终机械臂 120° | 用户确认机械结构 |
| 5 号零位 | **完整回零、最终退离 4° 后停住的位置与小车侧边平行** | 用户此前明确确认；与代码在最终退离后建立软件 0° 一致 |
| 5 号工作姿态 | 抓放时应与车侧垂直，当前目标为软件 90° | 用户确认目标姿态；终点实际角度及重复误差仍需量具核对 |
| 5/6 号方向 | 旋转臂向收拢端、升降臂向顶部回零，当前方向正确 | 用户实测反馈；无需重新猜测方向 |
| 全部电机指令脉冲/圈 | **1～7 号每台均为 3200 指令脉冲/电机圈** | 用户于 2026-10-26 实机确认 |
| 6 号结构及传动尺度 | 同步带直驱、无减速；**20 齿 × 2 mm＝40 mm/电机圈** | 用户于 2026-10-26 实机确认轮齿数及齿距 |
| 6 号整段采数 | 六次计数为 264919、264816、264799、264918、264798、264880，平均 **264855 counts** | 用户提供；每电机圈 65536 反馈计数，对应约 4.04137 圈 |

旋转臂配置中的角度均指最终机械臂角度。例如首次搜索 360° 对应减速前电机 3 圈；途中触发限位会提前停止。

## 2. 参数确认状态与待验证项目

| 优先级 | 项目与配置字段 | 当前值 | 需要得到的结果 |
|---|---|---|---|
| 已确认 | 5/6/7 号指令脉冲/圈 `axis[].pulses_per_rev` | 三轴均为 **3200** | 2026-10-26 用户实机确认全部 1～7 号电机均为该值 |
| 已确认 | 6 号每电机圈位移 `axis[1].units_per_rev` | **40 mm/圈** | 2026-10-26 用户实机确认 20 齿 × 2 mm，直驱无减速 |
| 已确认 | 7 号每电机圈位移 `axis[2].units_per_rev` | **1 mm/圈** | 用户确认直径 6 mm、螺距 1 mm、单头丝杆、电机直联；直径不参与换算 |
| 已确认 | 7 号正方向 `axis[2].positive_sign` | **+1 为伸出** | 2026-10-26 用户纠正：当前回零方向为伸出；保留协议方向 0 和 +1 符号，TEST 先伸出再缩回 |
| P2 | 6 号可用软件行程 `home[1].max_position` | **0..160 mm** | 从最终回零停放位置量到底部，确认软件上限和真实端部余量 |
| P2 | 5 号工作角 `outside_angle`、位置范围 | **90°**，范围 **0..90°** | 从已确认的回零平行姿态出发，核对工作端实际垂直程度及多次往返误差 |
| P2 | 两轴回零速度、搜索及退让 `home[]` | 见第 4 节 | 确认停距、限位释放、二次搜索成功和回零重复性 |
| P3 | 终点容差 `axis[].tolerance` | 5 号 **1°**；6/7 号 **0.05 mm** | 用外部量具核对实际误差，不能把软件判定到位当成机械精度已通过 |
| P3 | 姿态窗口 `top_window`、`work_window` | 顶部 **0.1 mm**；工作角 **±2°** | 确认实际允许旋转/下降的位置窗口，并与重复误差及机械干涉条件相符 |
| P3 | 动态参数与等待时间 | 加速度字段 **100**；准备 **10 s**；零速稳定 **100 ms**；段间等待 **500 ms** | 结合负载、反馈及机构稳定情况核验；加速度 100 是协议字段，不是物理加速度 |

### 升降 40 mm/圈的确认状态

用户于 **2026-10-26 实机确认同步轮 20 齿、同步带齿距 2 mm**。当前 **40 mm/电机圈已由假设升级为结构实测确认值**，配置数值无需更改。该确认不等同于运动定位精度、有效行程及端部余量已完成验收。

- 20 齿 × 2 mm 齿距，对应 40 mm/圈。
- 早期考虑过 MXL 2.032 mm 齿距、40.64 mm/圈；该候选已由本次实机确认排除，不再作为待选值。
- 原总行程约 165 mm 是粗测值，用它和平均计数曾推得约 40.8278 mm/圈。该值保留为历史估算，不覆盖当前 40 mm/圈配置。
- 按当前 40 mm/圈，平均计数对应约 161.655 mm。因此不能直接用“165 − 4 − 160”宣称还剩 1 mm；底部真实余量需重新实测。

## 3. 后续标定顺序和记录方法

1. **已完成：全部电机指令脉冲/圈与 6 号传动规格确认。** 1～7 号均为 3200 指令脉冲/电机圈；6 号为 20 齿 × 2 mm、40 mm/圈。指令脉冲与每圈 65536 反馈计数是不同单位。
2. **验证 6/7 号实际定位误差与重复性。** 传动换算已确认分别为 40 mm/圈、1 mm/圈；记录同一段运动的实际长度和反馈计数差，分别保留正反向结果，核对实际距离与指令是否一致。
3. **核对实际姿态和可用行程。** 以完成回零后的软件零点为起点，核对旋转臂 90° 终点，并量取升降轴到下端的距离。最终退离已包含在零位定义中，不能把开关触发点混作软件零点。
4. **验证回零与带载动作。** 至少记录三次回零、三轮 TEST；记录载荷、开关触发后继续移动的距离、退让后是否稳定释放、最终停放点和失败情况。当前 TEST 升降为 0→+5→0 mm，7 号相对本轮起点先伸出 5 mm、回起点，再缩回 5 mm、回起点。
5. **最后确定容差和窗口。** 根据实测误差与机械允许姿态评估现有值，记录最终选择依据，不仅凭屏幕显示正常就判定标定完成。

上面是测量与记录方法，不表示已经加入新的调试入口。临时整段采数功能已删除。

## 4. 当前回零与运动参数快照

| 参数 | 5 号旋转臂 | 6 号升降臂 |
|---|---:|---:|
| 回零快寻/慢寻速度（电机 RPM） | 24 / 6 | 60 / 12 |
| 初始已触发时最大退离 | 6° | 8 mm |
| 首次搜索上限 | 360° | 170 mm |
| 第一次触发后退让 | 4° | 4 mm |
| 二次搜索上限 | 10° | 10 mm |
| 最终释放退离 | 4° | 4 mm |
| 普通动作速度 | 6°/s | 10 mm/s |
| 最大转速参数 | 24.1 RPM | 60.1 RPM |

5/6 最大转速参数的 0.1 RPM 余量仅容纳浮点换算误差，下一整数 RPM 仍被拒绝。初始退离、触发后退让及最终退离均使用各轴慢速。5/6 回零逻辑及其他距离保持不变。

### 7 号碰撞回零与中点（回零功能用户实测完成）

用户确认总行程 **50 mm**、不便添加限位，要求伸出至挡块后缩回中点。7 轴正坐标为伸出，负坐标为缩回；中点为软件 0，普通目标范围为 **−25..+25 mm**。这替代旧的任意上电位置会话零点。TEST 顺序保持 +5→起点→−5→起点。

上电/HOME 先执行 6→5；5 号完成后，只有 7 号配置有效、在线且位置/速度/状态反馈新鲜、无保护/堵转/未确认 STOP、动作非 UNKNOWN/REJECTED，才执行 7 号回零。否则 HOME 可结束为 SUCCESS，但 7 号仍为 NO ZERO，舵机自动启用不会放行。7 轴使用 X42S/Emm 原生无限位碰撞回零（9A 模式 02），并以主控连续无进展判定作为寻端到达条件（见第 7 节）；普通驱动器保护故障仍按故障处理。回零参数 4C、碰撞退角 5C 仅写 RAM，不存 EEPROM，也不启用驱动器独立上电回零。回零中用 3C 同时读取回零/电机状态；STOP 使用 9C 中断原生回零，随后确认停车。

| 7 轴参数 | 本轮试跑值 | 状态 |
|---|---:|---|
| 机械传动 | 1 mm/电机圈 | 用户确认 |
| 总行程 / 中点距伸出挡块 | 50 / 25 mm | 用户确认总行程；中点由行程推算 |
| 回零方向 | 协议方向 0（正向伸出） | 根据现有 TEST 与实测对应关系 |
| 碰撞搜索 / 回中速度 | 180 RPM，即 3 mm/s | 试跑值，快于普通 30 RPM |
| 搜索超时 | 25 s | 50 mm 匀速约 16.67 s；超时失败，不自动重试 |
| 碰撞检测转速 / 电流 / 时间 | 300 RPM / 800 mA / 60 ms | 厂家默认，尚未实机验证 |
| 驱动器碰撞后固定退角 | 360°，即缩回 1 mm | 试跑值；避免默认按电流退回造成距离不定 |
| 随后继续缩回 | 24 mm | 与驱动器 1 mm 退让合计 25 mm |
| 普通速度 / 最大 RPM | 0.5 mm/s（30 RPM）/ 180.1 RPM | 普通速度不变，最大值兼容回中 |

800 mA 是碰撞识别的电流阈值，不是电机电流上限；300 RPM 是识别阈值，实际搜索转速为 180 RPM。

原生回零成功后继续缩回 24 mm；主控无进展判定到端后，先中断并确认停车，再从端部缩回 25 mm。两条路径均在回中到位后建立中点 HOMED。用户取消、异常失败或通信异常不建立参考；主控判定到端后的主动中断按第 7 节归中流程处理。若中途有障碍，原生碰撞检测无法区分障碍与端部；挡块重复位置、800 mA 阈值、回中误差和端部余量需实机核验。±25 mm 是标称端点，不表示留有额外机械余量。

协议依据：本机厂家《ZDT_X42S第二代闭环步进电机用户手册 V1.0.5_260527》第 61–65、74、91 页，以及配套 Emm_V5.c 的 Origin 函数。旧计划与旧交付中的“7 号不设边界、不自动回中”已过时。

`calibrated`、`wiring_confirmed`、`home_confirmed` 当前置 1 是原 TRIAL 试运行放行，不能据此把本表待办标记为实测完成。

## 5. 结果填写表

每项附测量日期、固件提交号、载荷、量具和原始数据；重复测量逐次保留，避免仅保存平均值。

| 待办 | 实测结果/原始数据 | 最终采用值 | 确认状态 |
|---|---|---|---|
| 1～4 号指令脉冲/圈 | 用户于 2026-10-26 实机确认 | 各 3200 指令脉冲/电机圈 | 已确认 |
| 5 号指令脉冲/圈 | 用户于 2026-10-26 实机确认 | 3200 指令脉冲/电机圈 | 已确认 |
| 6 号指令脉冲/圈 | 用户于 2026-10-26 实机确认 | 3200 指令脉冲/电机圈 | 已确认 |
| 7 号指令脉冲/圈 | 用户于 2026-10-26 实机确认 | 3200 指令脉冲/电机圈 | 已确认 |
| 6 号同步轮/同步带规格 | 用户于 2026-10-26 实机确认 20 齿、2 mm 齿距 | 40 mm/电机圈 | 规格已确认；定位误差仍待验证 |
| 7 号传动及方向 | 单头 1 mm 螺距、电机直联；TEST 先伸出 | 1 mm/圈、+1 伸出 | 结构与方向已确认，实移待复核 |
| 7 号回零功能 | 用户实测确认无进展判定有效，并确认回零程序实测完成 | 见第 7 节 | 功能实测完成；重复定位精度未提供量测记录 |
| 旋转臂工作角误差及回位重复性 | 待填写 | 暂用 90° 工作角 | 待验证 |
| 升降有效行程及底部余量 | 待填写 | 暂用 0..160 mm | 待验证 |
| 两轴回零停距、退让及重复性 | 待填写 | 见第 4 节 | 待验证 |
| 三轴终点误差、姿态窗口和带载保持 | 待填写 | 见第 2 节 | 待验证 |

以下第 6 节为此前碰撞回零提交的软件验证历史；本轮改动与验收方法见第 7 节。

## 6. 碰撞回零代码的软件验证记录（2026-10-26）

Clang C11、`-Wall -Wextra -Werror`：

- 机构默认/严格门控各通过 **12708 项**检查；严格构建同时通过 AddressSanitizer / UndefinedBehaviorSanitizer。
- TRIAL 实际参数在默认/严格门控下均完成 6→5→7 回零及八段 TEST，检查发送 RPM。
- 7 轴新增验证：从两端回到中点、固定退角、范围及 TEST 起点检查；参数拒绝、丢失 ACK/回零状态、驱动回零失败/保护、超时、搜索与回中阶段 STOP；零速但仍报告回零中的状态不能通过停车确认。失败/取消不建立中点参考。
- 现有总线默认 **7597 项**、严格旧门控 **5292 项**及两组 STOP 专项通过。
- 应用 TRIAL 启动/重复 HOME/STOP、普通应用 **18958 项**、动作和调度回归通过；模拟 UI 单步最大 2 ms、STOP 7 ms、gyro 轮询 3 ms。

以上为主机合成模型验证，不代表真实碰撞识别、受力或中点精度。未运行 Windows Keil/AC5 构建，未生成新 HEX，未烧录。

## 7. 2026-10-26 功能反馈与回零实现记录

**7 号电机回零程序：实测完成（用户确认）。** 用户反馈无进展保护效果良好，决定以其作为到达端部的判据，不再测量或显示电流。此记录表示功能实测完成，不代表已量化重复定位精度；本轮将“无进展报错”改为“到端后自动归中”的衔接改动另行通过主机回归，未把改后未烧录的软件冒充实测。

方向：7 轴协议方向 0、软件正向（+1）是**伸出**；回零向伸出端，归中向缩回方向。中点为软件 0，普通 TEST 为伸出 5 mm→起点→缩回 5 mm→起点。`S_Vel_IS` 用户已修改，软件仍按 Disable、直接 RPM 输入，不改方向位及原动作超时。

1. 上电/HOME 按 6→5→符合配置与健康反馈条件的 7 执行，完整条件见第 4 节。7 号原生碰撞回零保持现有参数。
2. **主控无进展判定仅在 7 号回零寻端阶段生效**：连续新鲜位置反馈约 1500 ms 没有超过 0.02 mm 的累计位移，认为到达伸出端部，进入 `CONTACT STOP`，不再报 `NO PROGRESS`。编码器微小抖动不重置计时；缺失反馈或明确驱动器故障不能当作到端。若已观察到驱动器反向退让，则停止使用寻端判据。
3. 先发送 9C 中断原生回零，等待现有 STOP 流程确认停车，再等待新鲜位置和稳定零速。停车未确认、通信异常或用户 STOP 均禁止自动归中；3 秒确认窗口到期按故障处理。
4. **主控判定到端路径：从确认停车的位置缩回完整 25 mm**。此时未假定驱动器已退让 1 mm，不能只退 24 mm。到中点后才标记 `HOMED`。
5. **驱动器自行完成碰撞回零路径：保持原有退让 1 mm＋主控缩回 24 mm**。
6. 回中、普通位置动作、八段 TEST 不使用无进展寻端判据；它们仍有原来的反馈、驱动器故障、动作超时及 STOP 处理，不会把中途卡住当成零点。

`EMM_CURRENT`/0x27 查询、最大值存储、采样调度及 `7 Imax` 显示和相关测试已删除，机械臂页恢复原说明。驱动器原生碰撞回零配置中的检测电流参数仍保留，这是原生回零协议参数，不是主控电流测量。

此方案按用户确认的机构条件，将回零方向持续无进展视为端部；它不能区分端部挡块与中途障碍。

本轮 `Scripts/test.ps1` 全部通过：机构默认/严格门控各 14960 项，实际 TRIAL 参数回零及八段 TEST 通过。新增覆盖到端判定后完整 25 mm 归中、编码器抖动、时钟回绕、停车无法确认、用户取消，以及普通移动/回中卡住仍按原动作超时失败。

2026-10-26 当次 `Scripts/build.ps1` 因 ARMCC/ArmLink 启动失败（CreateProcess failed）未生成新固件，未烧录。后续 2026-10-27 合入记录报告 Keil 全量构建通过；2026-11-04 用户确认完成机构回零功能测试，但未提供对应 HEX/提交及具体路径覆盖，不能据此追认当次构建成功或全部归中异常路径通过。

## 8. 与舵机启用的当前关系

`qr_app.c` 要求 HOME 结果 SUCCESS、三轴均为 HOMED 且机构/底盘/总线空闲、无待确认 STOP，才由 `ServoControl_Startup` 启用两路初始 PWM。仅 5/6 回零成功不足以自动启用；若 7 被跳过且未出现 FAILED/CANCELLED，舵机上电意图仍保持等待，手动 ON 也会被 boot_pending 门控，只有满足条件或由明确 OFF/STOP 取消等待后才可能继续。上电自动回零仅尝试一次，不自动反复重试；STOP 取消机构与舵机的上电待执行意图。手动 HOME 不会重新设置已取消的舵机自动启用意图。

手动舵机 ON 受回零等待、控制权和总线忙/停车门控，但不检查三轴 HOMED；通过 ON 恢复 PWM 不等于机构已回零。具体预设和 OFF 行为见 [README](../README.md)。
