dadatiaoao/-1021ccc/User/main.c

/*
 * 程序入口总览：先完成 HAL、180 MHz 时钟、调试串口、触摸和 LCD 初始化，
 * 再建立电机/扫码通信与应用状态，最后由 QrApp_Process 持续推进各模块。
 * 这是协作式主循环；各服务需及时返回，运行期等待由状态和时间期限表达。
 */
#include "main.h"
#include "./usart/bsp_debug_usart.h"
#include "./lcd/bsp_lcd.h"
#include "./touch/gt9xx.h"
#include "./app/qr_app.h"
#include "./usart/bsp_motor_uart.h"
#include "./usart/bsp_qr_uart.h"
#include "./usart/bsp_qr_trigger.h"

/*
 * 一次性初始化硬件并进入统一调度。app 使用静态存储，长期保留七轴、扫码、
 * 光流、陀螺和界面的状态；首页显示准备阶段，上电机构回零由机构配置门控。
 */
int main(void)
{
    static QrApp app;
    MotorTransport motor;
    uint8_t qr_ready;
    HAL_Init();
    SystemClock_Config();
    DEBUG_USART_Config();
    GTP_Init_Panel();
    LCD_Init();
    LCD_LayerInit(0, LCD_FB_START_ADDRESS, ARGB8888);
    LCD_SelectLayer(0);
    LCD_SetTransparency(0, 255);
    LCD_DisplayOn();
    GTP_SetRuntimeMode();
    motor = BspMotorUart_Init();
    qr_ready = BspQrUart_Init();
    BspQrTrigger_Init();
    QrApp_Init(&app, motor, qr_ready, HAL_GetTick());
    while (1) {
        /* Diagnostics and explicitly started chassis actions share one motor bus. */
        QrApp_Process(&app, HAL_GetTick());
    }
}

/*
 * 配置 HSE=25 MHz、PLL 系统时钟 180 MHz，以及 APB1=45 MHz、APB2=90 MHz。
 * HAL 毫秒时基和传感器 DWT 耗时换算依赖该时钟配置；配置失败时停留在故障循环。
 */
static void SystemClock_Config(void)
{
  RCC_ClkInitTypeDef RCC_ClkInitStruct;
  RCC_OscInitTypeDef RCC_OscInitStruct;

  /* Enable Power Control clock */
  __HAL_RCC_PWR_CLK_ENABLE();

  /* ʹ��HSE������HSEΪPLL��ʱ��Դ������PLL�ĸ��ַ�Ƶ����M N P Q
	 * PLLCLK = HSE/M*N/P = 25M / 25 *360 / 2 = 180M
	 */
  __HAL_PWR_VOLTAGESCALING_CONFIG(PWR_REGULATOR_VOLTAGE_SCALE1);

  RCC_OscInitStruct.OscillatorType = RCC_OSCILLATORTYPE_HSE;
  RCC_OscInitStruct.HSEState = RCC_HSE_ON;
  RCC_OscInitStruct.PLL.PLLState = RCC_PLL_ON;
  RCC_OscInitStruct.PLL.PLLSource = RCC_PLLSOURCE_HSE;
  RCC_OscInitStruct.PLL.PLLM = 25;
  RCC_OscInitStruct.PLL.PLLN = 360;
  RCC_OscInitStruct.PLL.PLLP = RCC_PLLP_DIV2;
  RCC_OscInitStruct.PLL.PLLQ = 7;
  if(HAL_RCC_OscConfig(&RCC_OscInitStruct) != HAL_OK)
  {
   while(1) {}
  }


  HAL_PWREx_EnableOverDrive();

  /* ѡ��PLLCLK��ΪSYSCLK�������� HCLK, PCLK1 and PCLK2 ��ʱ�ӷ�Ƶ����
	 * SYSCLK = PLLCLK     = 180M
	 * HCLK   = SYSCLK / 1 = 180M
	 * PCLK2  = SYSCLK / 2 = 90M
	 * PCLK1  = SYSCLK / 4 = 45M
	 */
  RCC_ClkInitStruct.ClockType = (RCC_CLOCKTYPE_SYSCLK | RCC_CLOCKTYPE_HCLK | RCC_CLOCKTYPE_PCLK1 | RCC_CLOCKTYPE_PCLK2);
  RCC_ClkInitStruct.SYSCLKSource = RCC_SYSCLKSOURCE_PLLCLK;
  RCC_ClkInitStruct.AHBCLKDivider = RCC_SYSCLK_DIV1;
  RCC_ClkInitStruct.APB1CLKDivider = RCC_HCLK_DIV4;
  RCC_ClkInitStruct.APB2CLKDivider = RCC_HCLK_DIV2;
  if(HAL_RCC_ClockConfig(&RCC_ClkInitStruct, FLASH_LATENCY_5) != HAL_OK)
  {
    while(1) {}
  }
}
