dadatiaoao/-1021ccc/User/chassis/chassis_config.h

#ifndef CHASSIS_CONFIG_H
#define CHASSIS_CONFIG_H
#include <stdint.h>

/* Measured vehicle parameters ONLY. Zero/false means unconfigured, never a
   guessed vehicle dimension. Test fixtures supply their own ChassisConfig. */
#define CHASSIS_MECHANICAL_CONFIRMED 1u
#define CHASSIS_FEEDBACK_CONFIRMED 1u /* Motor position scale/signs and gyro mapping. */
#define CHASSIS_WHEEL_DIAMETER_MM 78.0f
#define CHASSIS_LENGTH_MM 216.0f
#define CHASSIS_WIDTH_MM 218.6f
#define CHASSIS_GEAR_RATIO 1.0f /* motor revolutions / wheel revolution */
#define CHASSIS_MOTOR_SIGNS {1, -1, 1, -1} /* Addresses 1..4; forward/backward button directions confirmed by user, 2026-11-05. */

#define CHASSIS_LEFT_TRAVEL_SCALE 1.0f
#define CHASSIS_RIGHT_TRAVEL_SCALE 1.0f
#define CHASSIS_GYRO_STARTUP_TIMEOUT_MS 2000u

typedef struct {
    float wheel_diameter_mm, length_mm, width_mm, gear_ratio;
    float left_travel_scale, right_travel_scale; /* actual circumference / nominal */
    float max_rpm, max_speed_mm_s, max_rate_deg_s;
    float acceleration_mm_s2, acceleration_deg_s2;
    float position_kp, heading_kp, rate_damping;
    float position_window_mm, angle_window_deg, rest_rate_deg_s;
    uint32_t control_ms, publish_ms, input_lease_ms, stable_ms;
    int8_t motor_sign[4];
    uint8_t mechanical_confirmed, feedback_confirmed, driver_acceleration;
} ChassisConfig;

enum { CHASSIS_CFG_MECHANICAL=1u, CHASSIS_CFG_GEOMETRY=2u,
       CHASSIS_CFG_DIRECTION=4u, CHASSIS_CFG_LIMITS=8u,
       CHASSIS_CFG_FEEDBACK=16u };
void Chassis_DefaultConfig(ChassisConfig *out);
uint32_t Chassis_ConfigIssues(const ChassisConfig *config, uint8_t closed_loop);
#endif
