dadatiaoao/-1021ccc/(commit log)

2026-10-23 修复光流与陀螺相位配对并锁存失败证据
2026-10-23 参数调试
2026-10-23 移除底盘光流反馈并改用电机位置估算行程
2026-10-23 实现非阻塞机构回零、限位保护与屏幕验收
2026-10-24 机构临时试运行参数填入
2026-10-24 显示界面改版
    删去过时页面和操控，统一管理UI并部分汉化
2026-10-25 机械臂数值测试
2026-10-25 标定升降臂，删除临时采数并调整回零参数
2026-10-26 5、6轴回零速度加快，记录7轴参数
2026-10-26 7号电机碰撞回零
    整理文档
2026-10-26 碰撞回零优化
    加入回零时无进展保护
2026-10-27 Integrate dual-servo control and startup positions
2026-11-05 加入 陀螺仪BUSY 细分诊断
2026-11-05 I²C 读写失败时，保存当时的信息
2026-11-05 陀螺仪初始化修复
    先读 0x7A，等于 0x83 就跳过重复写入。
    不同则继续写入、读回验证；失败仍正常报错。
    Bank 切换、超时和恢复策略未改。
    [gyro_service.c, gyro_service.h, gyro_ui.c, icm42688.h, test_gyro.c, test_qr.c]
2026-11-05 陀螺仪通信对照测试
2026-11-05 诊断 I2C 故障后释放主控引脚的电平变化
2026-11-05 抓住第一次失败的事务阶段和状态寄存器
2026-11-05 陀螺仪使用软件 I²C
2026-11-05 feat: migrate temporary gyro to MPU6050 on existing I2C pins
2026-11-05 校准时修正陀螺仪零偏
2026-11-05 底删除底盘八段验收
    彻底删除底盘八段路线、段号、段间等待及专用接口。
    原“底盘 → MORE”改为 前进30cm / 后退30cm，每次点击只执行一次，保留保向、互斥和停车检查。
2026-11-06 新增底盘左转右转九十度独立按钮
2026-11-06 新增陀螺启动失败轮端降级与左右轮周长校正
2026-11-06 Implement serial three-axis collision homing and parking
    [mechanism.c, mechanism.h, mechanism_config.h, motor_bus.c]
2026-11-06 Cover collision home paths and update mechanism UI status
    [qr_ui.c, test_mechanism.c, test_qr.c]
2026-11-06 Document stage-one homing parameters and acceptance gaps
2026-11-06 Tune three-axis homing and default motion speeds
